DocBohn/CowPi_documentation/README.md

# CowPi_documentation
Datasheet and Construction Instructions for Cow Pi hardware and libraries
