DocBohn/CowPi_documentation/docs/source/stdio.rst

*******************
CowPi_stdio Library
*******************

..  |LibraryLicense| image:: https://img.shields.io/github/license/DocBohn/CowPi_stdio
..  _LibraryLicense: https://github.com/DocBohn/CowPi_stdio/blob/main/LICENSE
..  |DocumentationLicense| image:: https://img.shields.io/github/license/DocBohn/CowPi_documentation
..  _DocumentationLicense: https://github.com/DocBohn/CowPi_documentation/blob/main/LICENSE
..  |ArduinoBadge| image:: https://www.ardu-badge.com/badge/CowPi_stdio.svg
..  _ArduinoBadge: https://www.ardu-badge.com/CowPi_stdio
..  |PlatformIOBadge| image:: https://badges.registry.platformio.org/packages/docbohn/library/CowPi_stdio.svg
..  _PlatformIOBadge: https://registry.platformio.org/libraries/docbohn/CowPi_stdio

- Library licensed under |LibraryLicense|_
- Documentation licensed under |DocumentationLicense|_

This documentation is for the ``CowPi_stdio`` library, v\ **0.6**\ .

The current version is: |ArduinoBadge|_ |PlatformIOBadge|_

..  toctree::
    :maxdepth: 3

    CowPi_stdio/configuration
    CowPi_stdio/considerations
    CowPi_stdio/other_functions
    CowPi_stdio/seven_segment
    CowPi_stdio/led_matrix
    CowPi_stdio/lcd_character
    CowPi_stdio/morse_code
    CowPi_stdio/protocols
    CowPi_stdio/theory_of_operation
    CowPi_stdio/direct-control
