DocBohn/CowPi_documentation/docs/source/expansion.rst

*****************
Expansion Options
*****************

..  TODO:: EEPROM

..  TODO:: Servomotor

..  TODO:: Ultrasonic Echo Sensor

..  TODO:: Piezobuzzer

..  TODO:: Rotary Encoder
