DocBohn/CowPi_documentation/docs/source/hardware/pinouts.pptx

## Arduino Nano – SPI

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
RESET

D0 (RX)

D1 (TX)

D13

3V3

AREF

A6

A7

5V

RESET

VIN

A0/D14

A1/D15

A2/D16

A3/D17

A4/D18

A5/D19

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
Keypad Rows
* 7 4 1

CS

SCK

1 2 3 A
Keypad Columns

## Arduino Nano – I2C

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
RESET

D0 (RX)

D1 (TX)

D13

3V3

AREF

A6

A7

5V

RESET

VIN

A0/D14

A1/D15

A2/D16

A3/D17

A4/D18

A5/D19

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
Keypad Rows
* 7 4 1

1 2 3 A
Keypad Columns

SDA

SCL

## Arduino Uno – SPI

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
Keypad Rows
* 7 4 1

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
D0 (RX)

D1 (TX)

AREF

GND

RESET

PC6

3V3

5V

A3/D17

A2/D16

A4/D18

A1/D15

1 2 3 A
Keypad Columns

A0/D14

PC0

PC1

PC2

PC3

PC4

A5/D19

PC5

IOREF

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
RESET

GND

## Arduino Uno – I2C

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
Keypad Rows
* 7 4 1

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
D0 (RX)

D1 (TX)

SCL

SDA

AREF

GND

RESET

PC6

3V3

5V

A3/D17

A2/D16

A4/D18

A1/D15

1 2 3 A
Keypad Columns

A0/D14

PC0

PC1

PC2

PC3

PC4

A5/D19

PC5

SDA

SCL

IOREF

GND

GND

VIN

## Raspberry Pi Pico

39

1
2

SDO

GP28/A3

GND

GP27/A1

GP26/A0

SCK

CS

SDI

VBUS (USB)

VSYS

GND

3V3_EN

3V3 (OUT)

AREF

RUN

GP22

GND

GP21

GP20

GP19

GP18

GP17

GND

GP16

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
1 4 7 *
Keypad Rows

GP7

GP8

GP9

GP10

GND

1 2 3 A
Keypad Columns

GP11

GP12

GP13

GND

GP14

GP15

## Arduino Nano – SPI – NAND

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
RESET

D0 (RX)

D1 (TX)

D13

3V3

AREF

A6

A7

5V

RESET

VIN

A0/D14

A1/D15

A2/D16

A3/D17

A4/D18

A5/D19

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
COPI

Keypad Rows
* 7 4 1

CS

SCK

1 2 3 A
Keypad Columns

## Arduino Nano – I2C – NAND

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
RESET

D0 (RX)

D1 (TX)

D13

3V3

AREF

A6

A7

5V

RESET

VIN

A0/D14

A1/D15

A2/D16

A3/D17

A4/D18

A5/D19

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
Keypad Rows
* 7 4 1

1 2 3 A
Keypad Columns

SDA

SCL
