DocBohn/CowPi_documentation/docs/source/construction/pico/mk3c-images/CowPi-mk3c-schematic.png

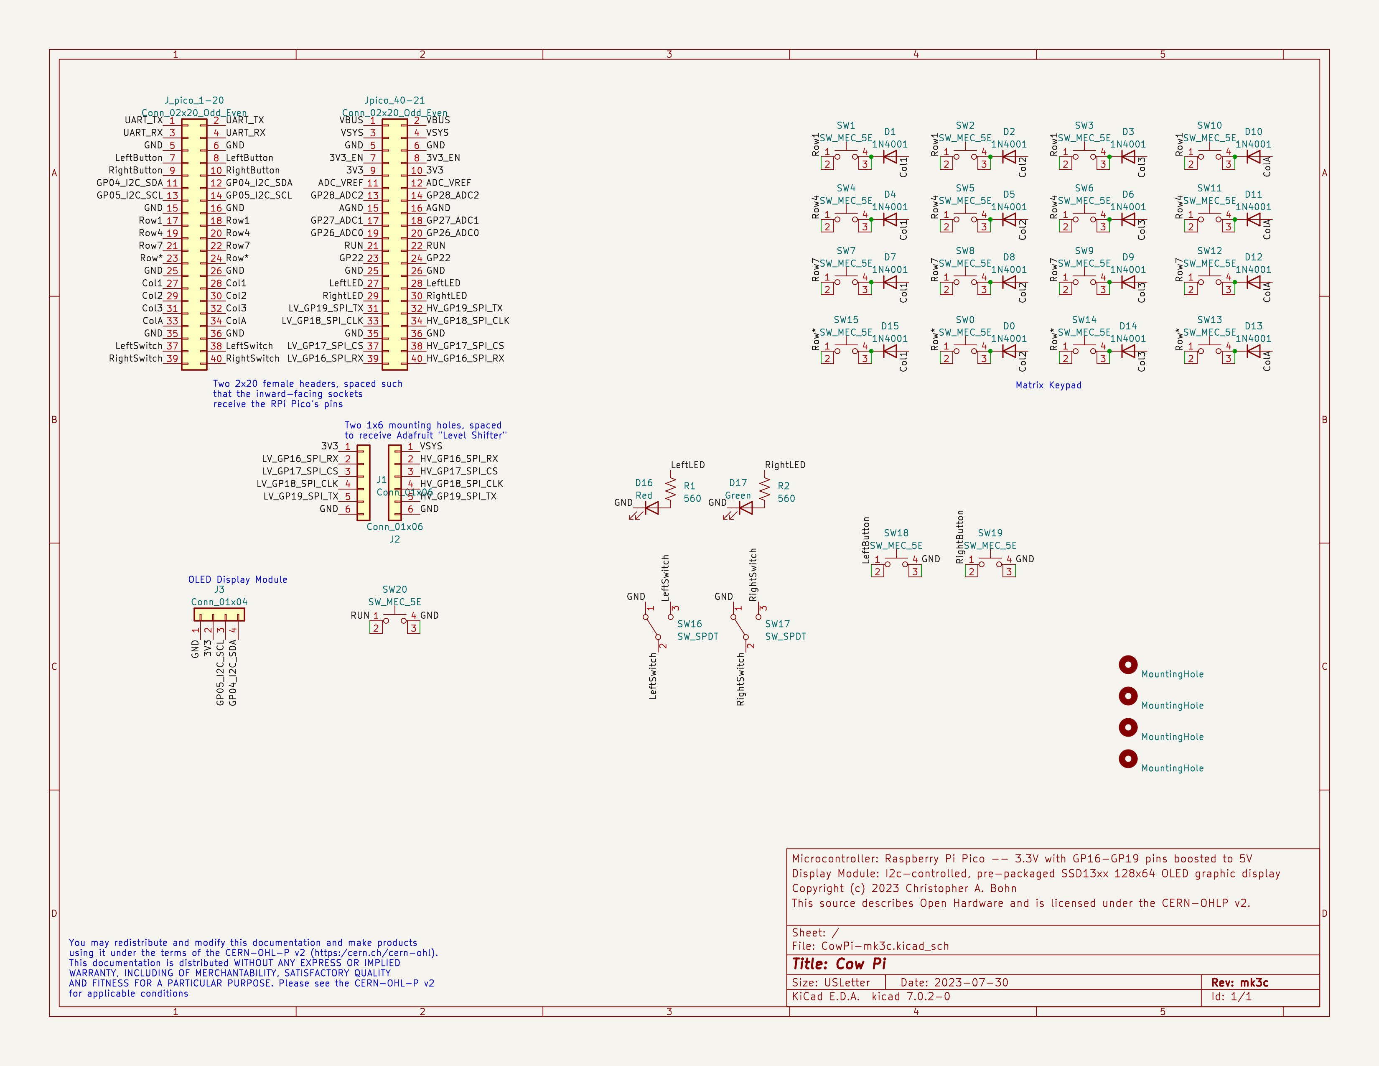
docs/source/construction/pico/mk3c-images/CowPi-mk3c-schematic.png
