DocBohn/CowPi_documentation/docs/source/construction/pico/mk4b-images/CowPi-mk4b-schematic.jpg

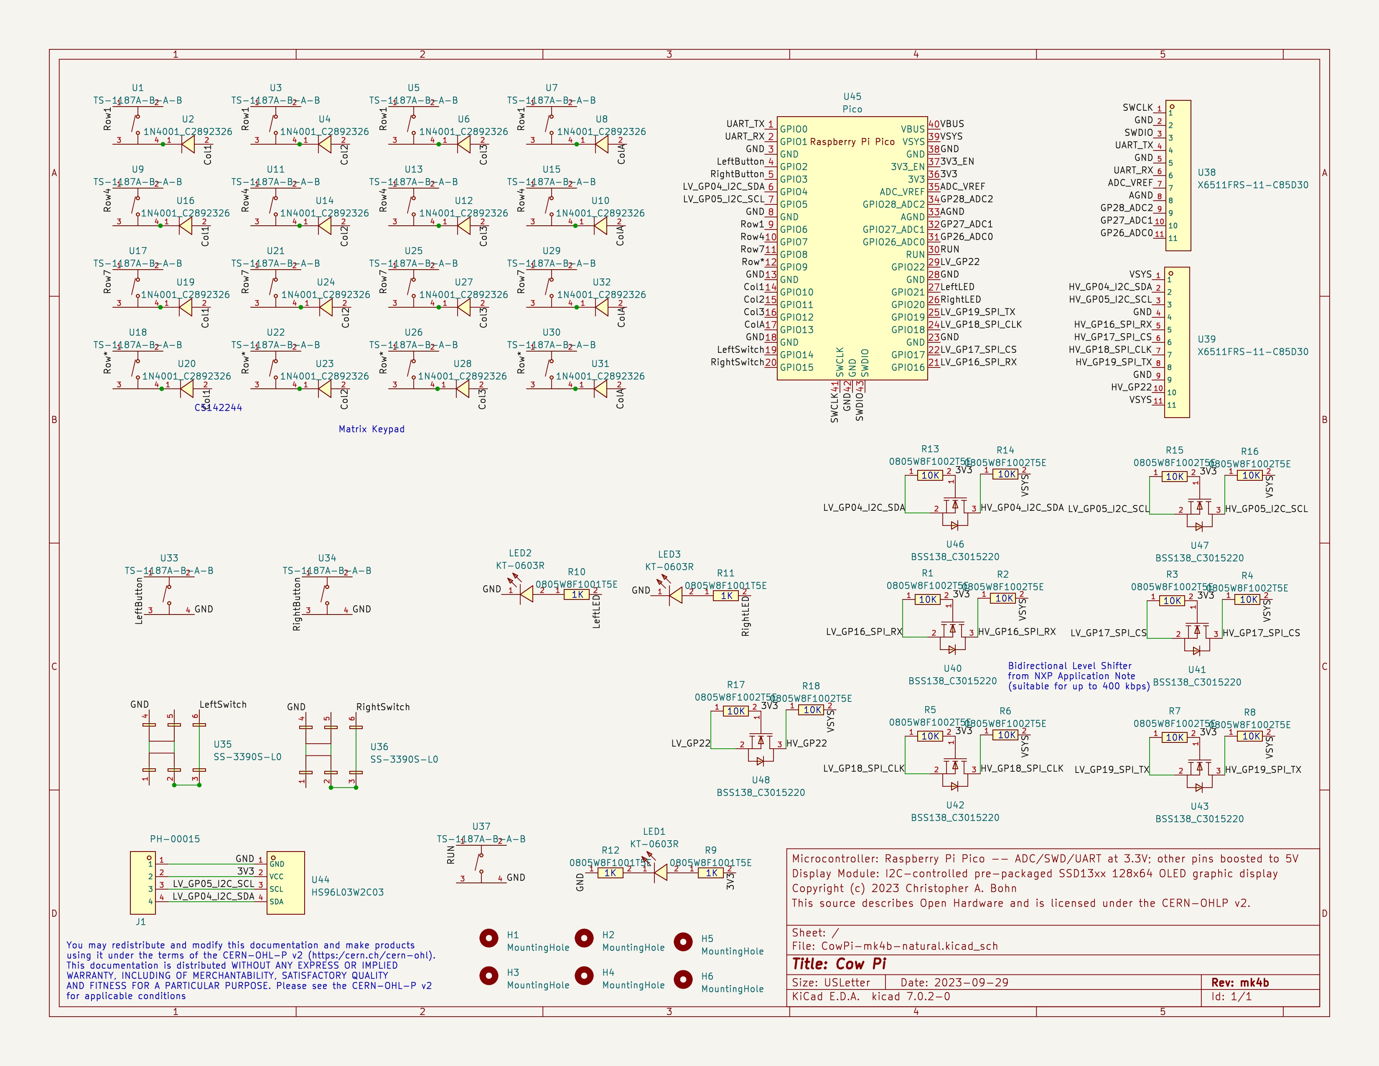
docs/source/construction/pico/mk4b-images/CowPi-mk4b-schematic.jpg
