DocBohn/CowPi_documentation/docs/source/CowPi_stdio/img/animations/lcd00.jpg

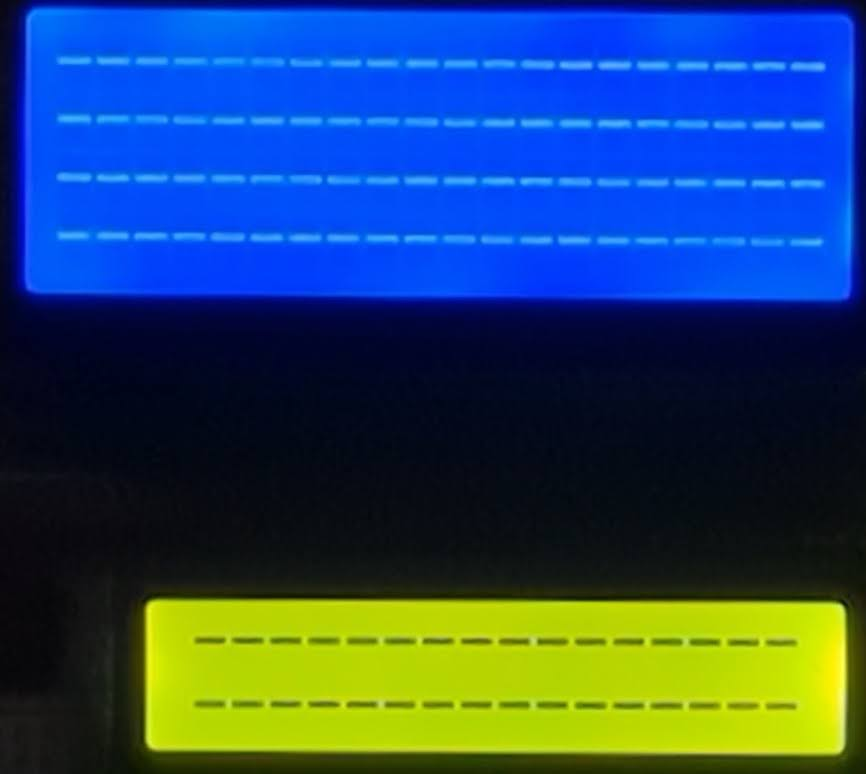
docs/source/CowPi_stdio/img/animations/lcd00.jpg
