DocBohn/CowPi_documentation/docs/source/CowPi_stdio/img/animations/lcd01.jpg

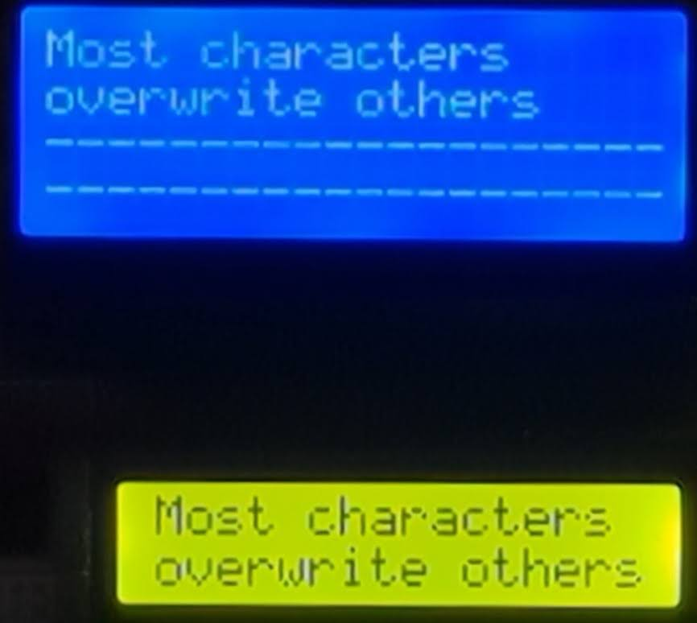
docs/source/CowPi_stdio/img/animations/lcd01.jpg
