DocBohn/CowPi_documentation/docs/source/CowPi_stdio/img/animations/lcd02.jpg

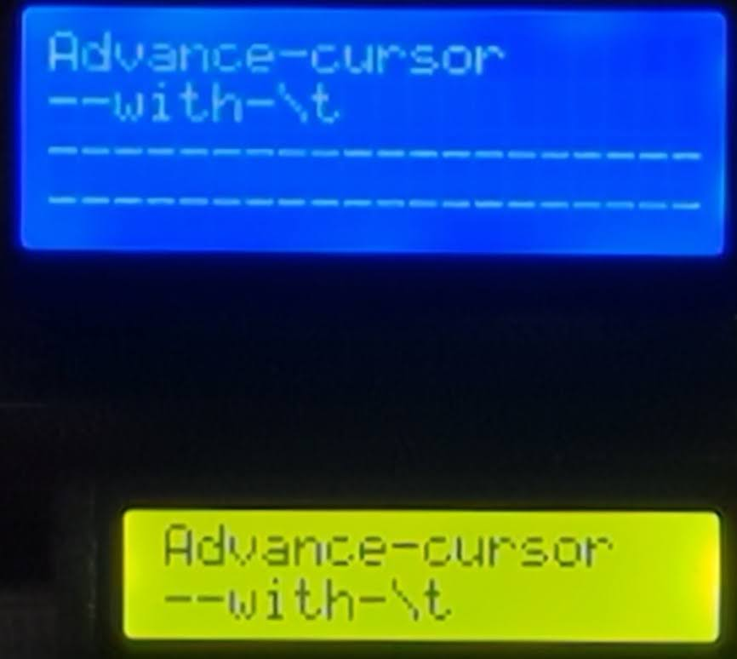
docs/source/CowPi_stdio/img/animations/lcd02.jpg
