DocBohn/CowPi_documentation/docs/source/CowPi_stdio/img/animations/lcd03.jpg

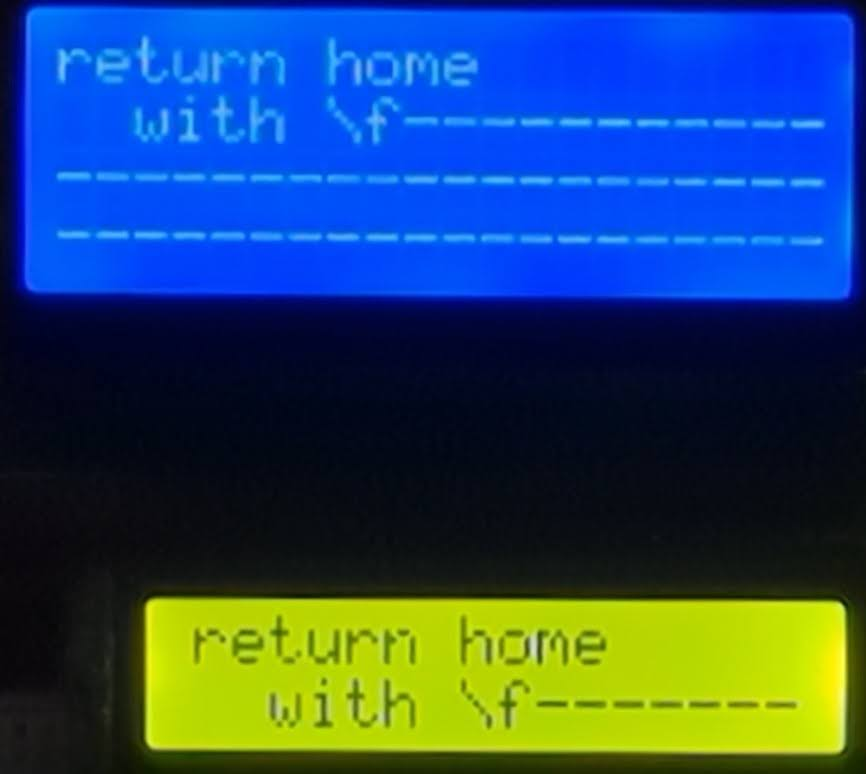
docs/source/CowPi_stdio/img/animations/lcd03.jpg
