DocBohn/CowPi_documentation/docs/source/CowPi_stdio/img/animations/lcd04.jpg

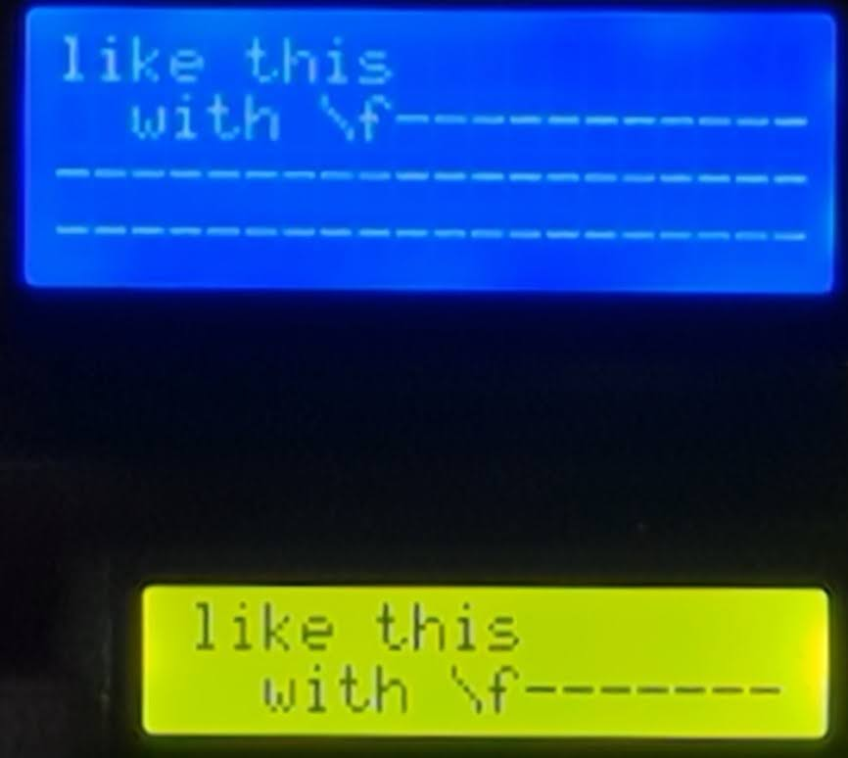
docs/source/CowPi_stdio/img/animations/lcd04.jpg
