DocBohn/CowPi_documentation/docs/source/CowPi_stdio/img/animations/lcd05.jpg

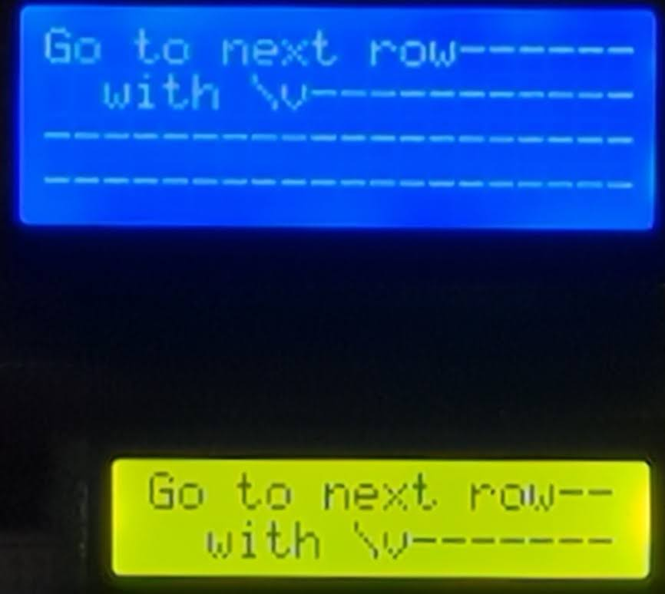
docs/source/CowPi_stdio/img/animations/lcd05.jpg
