DocBohn/CowPi_documentation/docs/source/CowPi_stdio/img/animations/lcd06.jpg

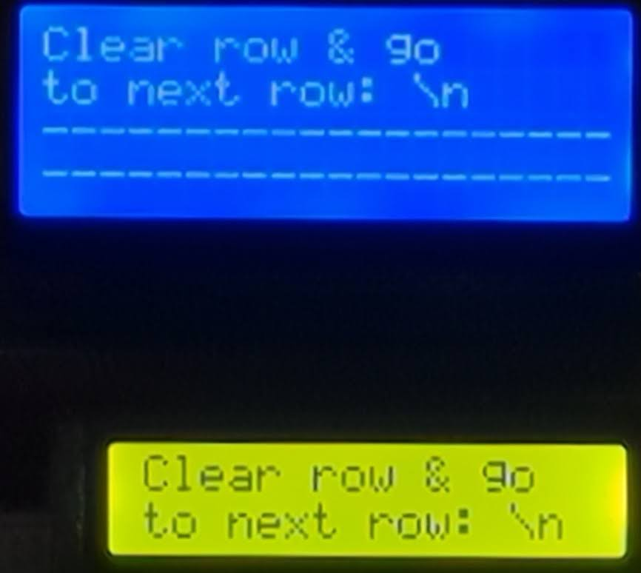
docs/source/CowPi_stdio/img/animations/lcd06.jpg
