DocBohn/CowPi_documentation/docs/source/CowPi_stdio/img/animations/lcd07.jpg

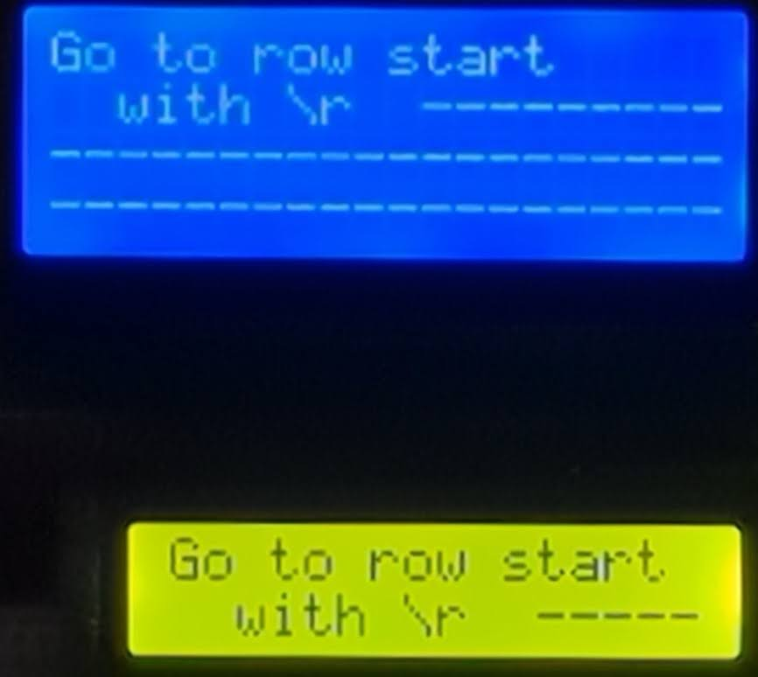
docs/source/CowPi_stdio/img/animations/lcd07.jpg
