DocBohn/CowPi_documentation/docs/source/CowPi_stdio/img/animations/lcd08.jpg

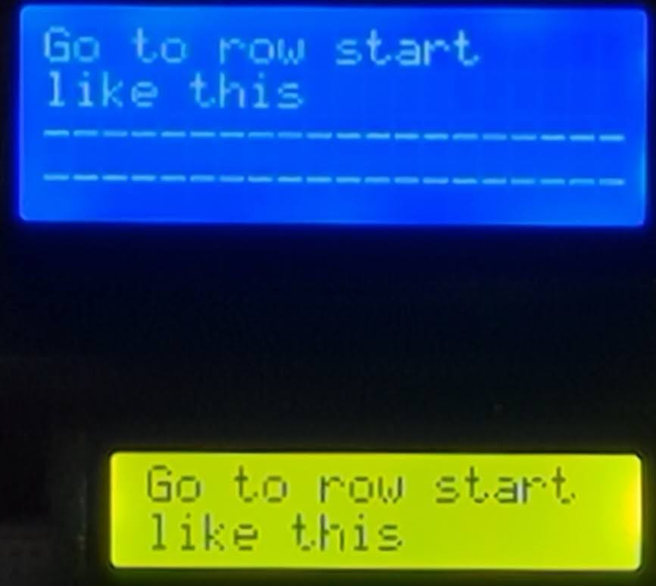
docs/source/CowPi_stdio/img/animations/lcd08.jpg
