DocBohn/CowPi_documentation/docs/source/CowPi_stdio/img/animations/lcd09.jpg

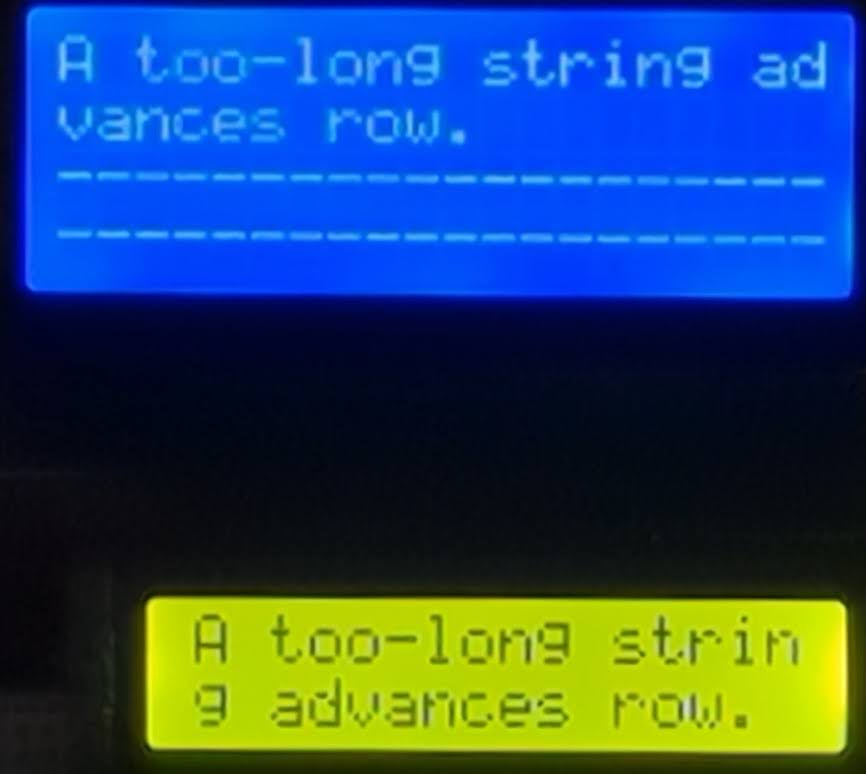
docs/source/CowPi_stdio/img/animations/lcd09.jpg
