DocBohn/CowPi_documentation/docs/source/CowPi_stdio/img/animations/lcd10.jpg

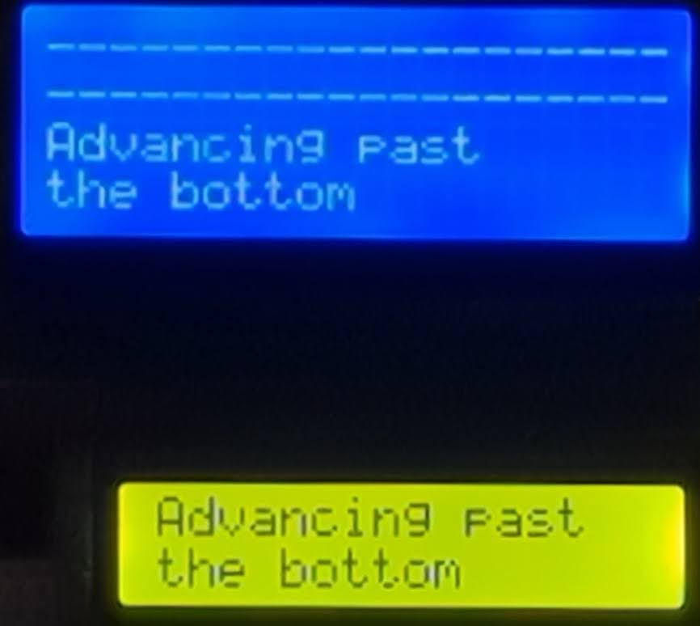
docs/source/CowPi_stdio/img/animations/lcd10.jpg
