DocBohn/CowPi_documentation/docs/source/CowPi_stdio/img/animations/lcd11.jpg

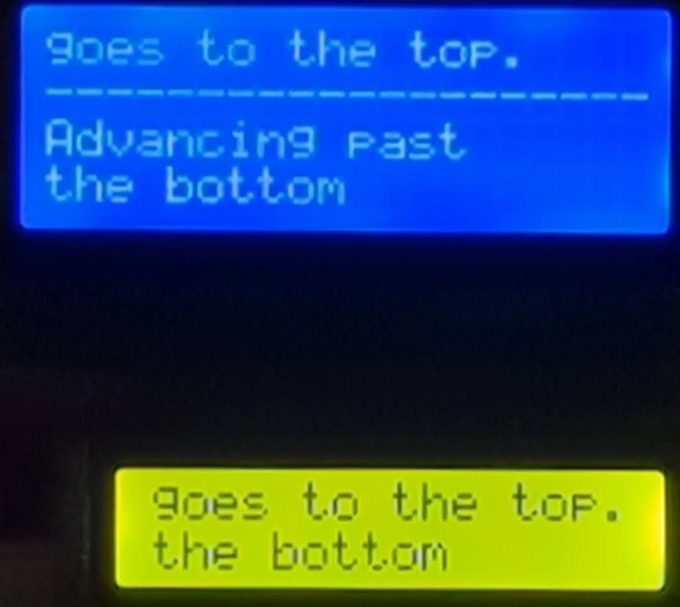
docs/source/CowPi_stdio/img/animations/lcd11.jpg
