DocBohn/CowPi_documentation/docs/source/CowPi_stdio/img/animations/lcd2004-1602.gif

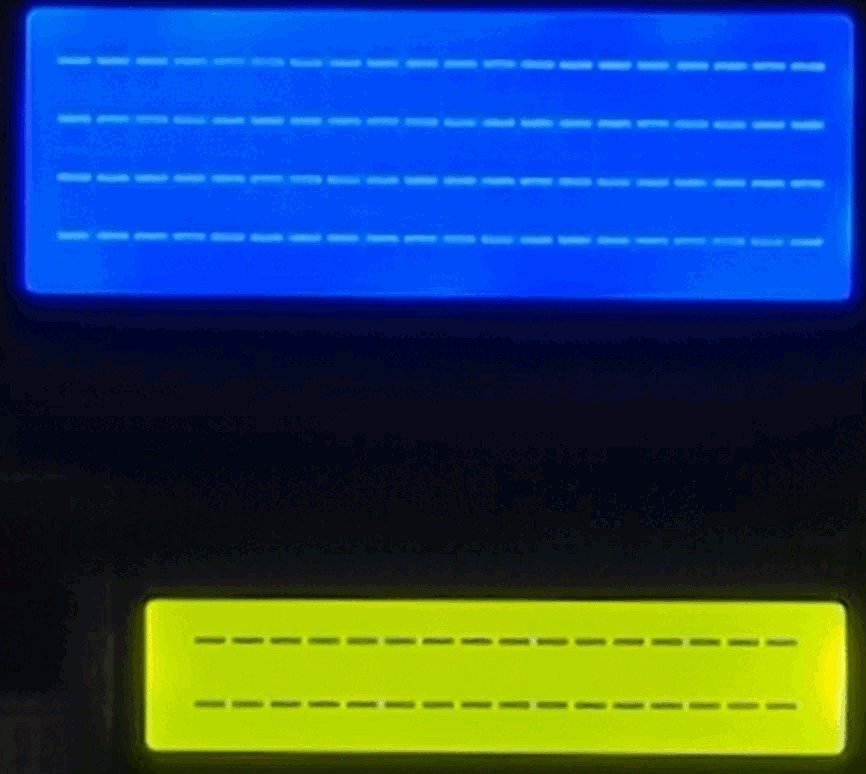
docs/source/CowPi_stdio/img/animations/lcd2004-1602.gif
