DocBohn/CowPi_documentation/docs/source/CowPi_stdio/img/morsecode.gif

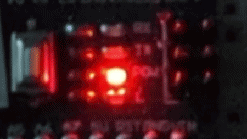
docs/source/CowPi_stdio/img/morsecode.gif
