DocBohn/CowPi_documentation/docs/source/CowPi_stdio/img/sevensegment.gif

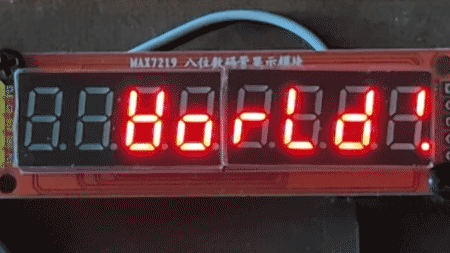
docs/source/CowPi_stdio/img/sevensegment.gif
