DocBohn/CowPi_documentation/docs/source/hardware/prepare-to-detect-keypress.png

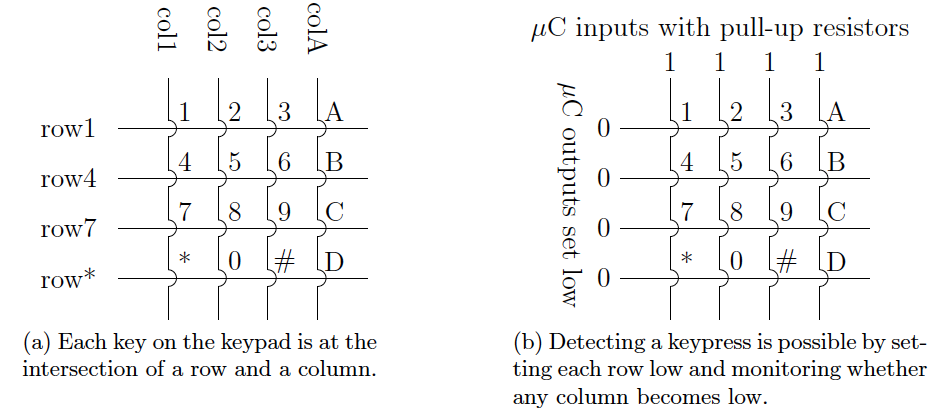
docs/source/hardware/prepare-to-detect-keypress.png
