DocBohn/CowPi_documentation/docs/source/hardware/scanning-keypad.png

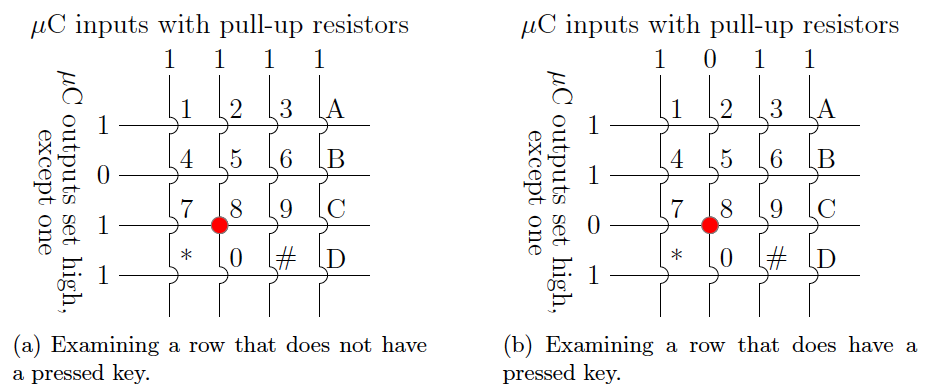
docs/source/hardware/scanning-keypad.png
