DocBohn/CowPi_documentation/docs/source/osi_symbol.png

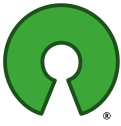
docs/source/osi_symbol.png
