DocBohn/CowPi_documentation/docs/source/construction/nano/inventory/preparation-mk1e.rst

..  include:: ../mk1e.txt

Prepare to Assemble the Cow Pi mark 1e
======================================

..  include:: preparation-inventory.rst

-   | One (1) 8-digit/7-segment display module
    | |max7219digits|

-   | One (1) 5-conductor 20cm "rainbow" cable (female-to-male)
    | |fiveConductor|

..  include:: preparation-assembling.rst

..  NOTE::
    The circuit you build by following these instructions will look a bit like a rat's nest by the time that you are finished.
    This is because the jumper wires you remove from the male-to-male rainbow cable are not cut to length and generally will be longer than they need to be (which is much better than being shorter than they need to be).
    If you have prior experience with building circuits on a solderless breadboard, and if you have solid-core wires and wire cutters, then optionally you may build the circuit with cut-to-length solid core wires.

    ..  image:: completed-kit-max7219.jpg
        :width: 90%
        :align: center

    \
        \
            Cow Pi mk1a that was constructed using 10cm jumper wires.

..  NOTE::
    In many of the photographs on the following pages, jumper wires from earlier steps have been replaced with cut-to-length wires to emphasize the wires from the current step.
    This may cause the photographs to look "cleaner" than your circuit.

..  |max7219digits|     image:: max7219digits.jpg
    :height: 2cm
..  |fiveConductor|     image:: fm-5cable.jpg
    :height: 2cm
