DocBohn/CowPi_documentation/docs/source/construction/nano/inventory/adafruit-lcd-adapter.jpg

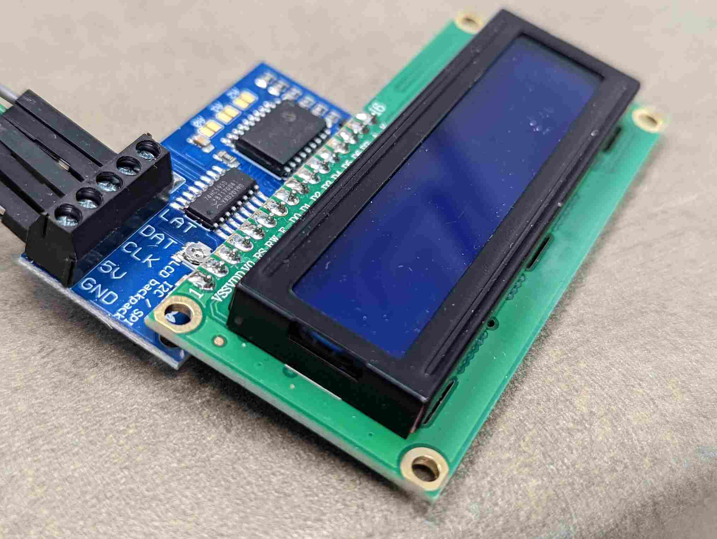
docs/source/construction/nano/inventory/adafruit-lcd-adapter.jpg
