DocBohn/CowPi_documentation/docs/source/construction/nano/inventory/breadboard.jpg

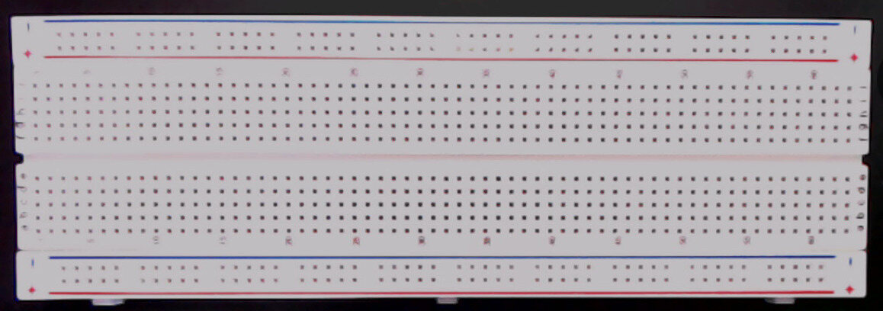
docs/source/construction/nano/inventory/breadboard.jpg
