DocBohn/CowPi_documentation/docs/source/construction/nano/inventory/buttons-2pin.jpg

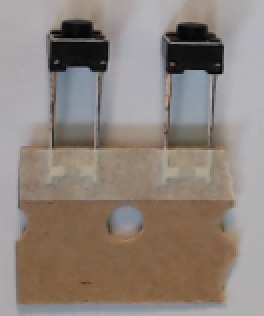
docs/source/construction/nano/inventory/buttons-2pin.jpg
