DocBohn/CowPi_documentation/docs/source/construction/nano/inventory/buttons-4pin.jpg

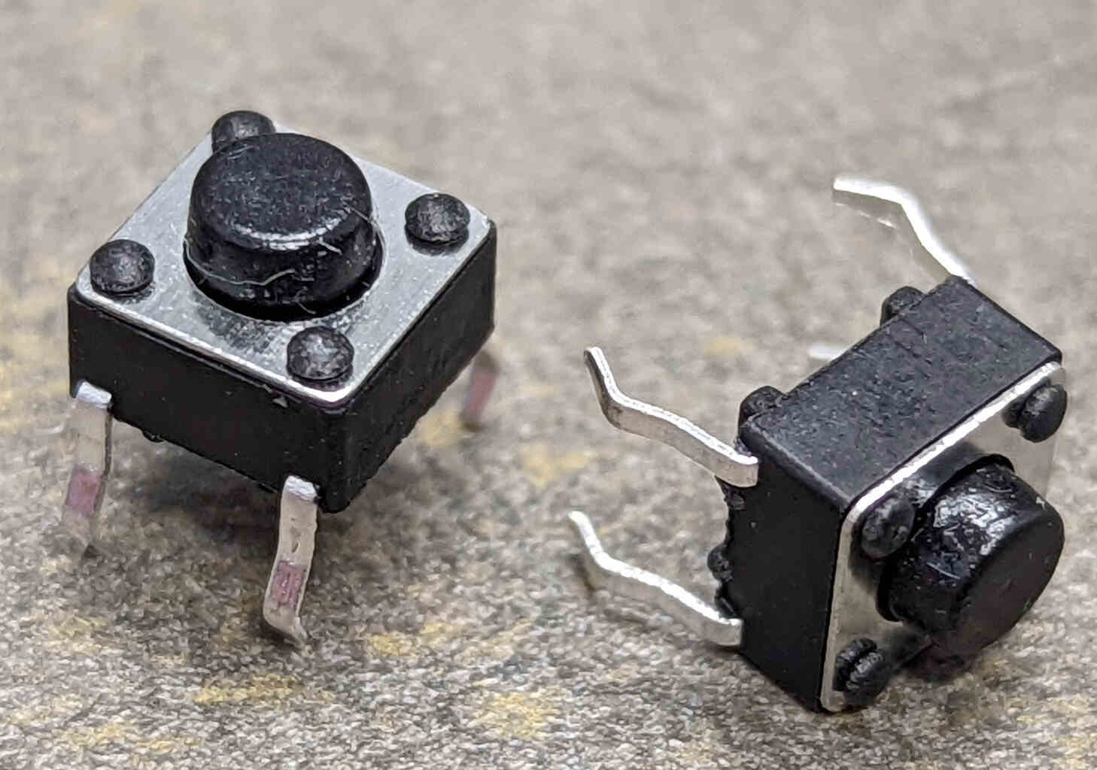
docs/source/construction/nano/inventory/buttons-4pin.jpg
