DocBohn/CowPi_documentation/docs/source/construction/nano/inventory/fm-4cable.jpg

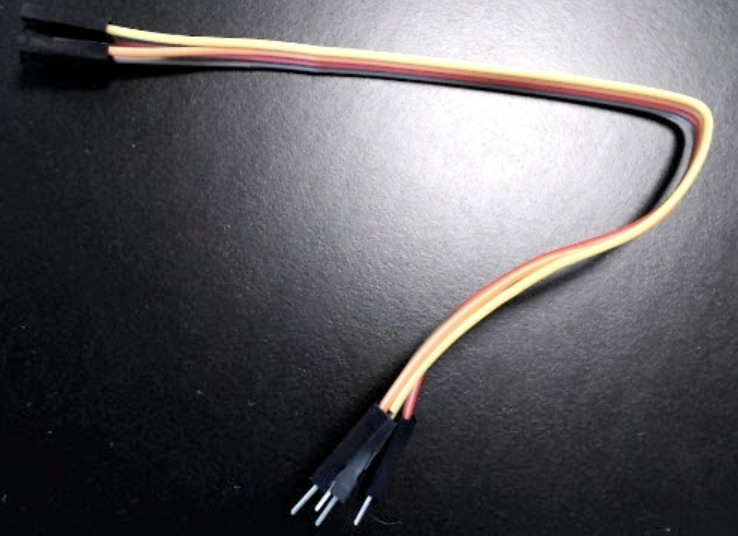
docs/source/construction/nano/inventory/fm-4cable.jpg
