DocBohn/CowPi_documentation/docs/source/construction/nano/inventory/fm-5cable.jpg

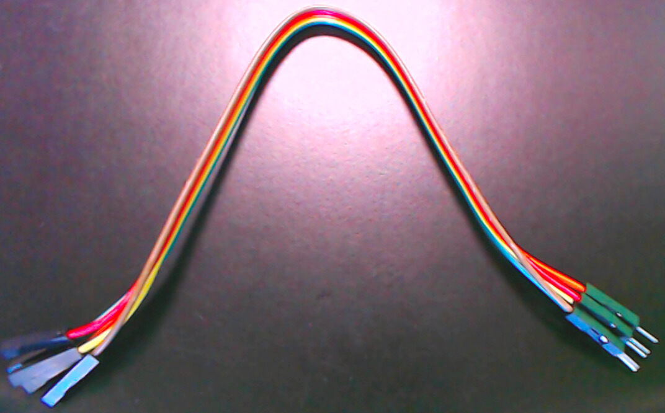
docs/source/construction/nano/inventory/fm-5cable.jpg
