DocBohn/CowPi_documentation/docs/source/construction/nano/inventory/keypad-header-in-connector.jpg

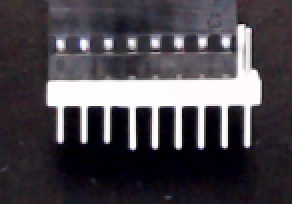
docs/source/construction/nano/inventory/keypad-header-in-connector.jpg
