DocBohn/CowPi_documentation/docs/source/construction/nano/inventory/keypad-header-without-connector.jpg

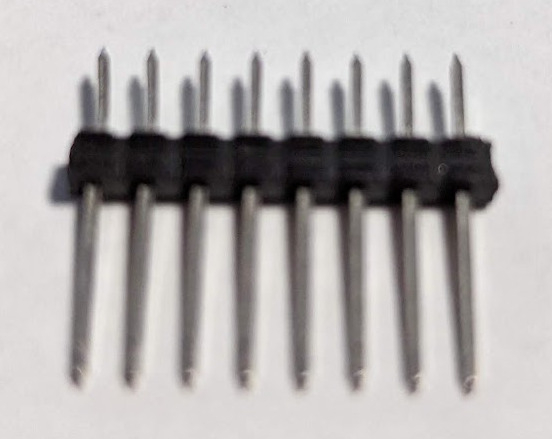
docs/source/construction/nano/inventory/keypad-header-without-connector.jpg
