DocBohn/CowPi_documentation/docs/source/construction/nano/inventory/keypad.jpg

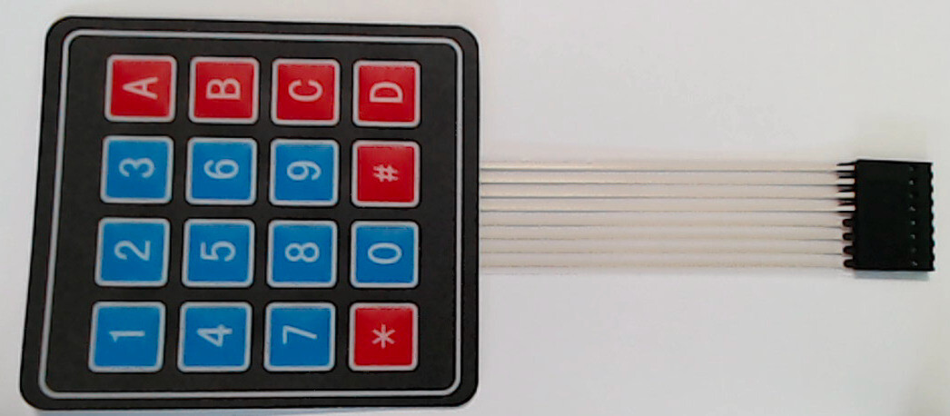
docs/source/construction/nano/inventory/keypad.jpg
