DocBohn/CowPi_documentation/docs/source/construction/nano/inventory/lcd1602.jpg

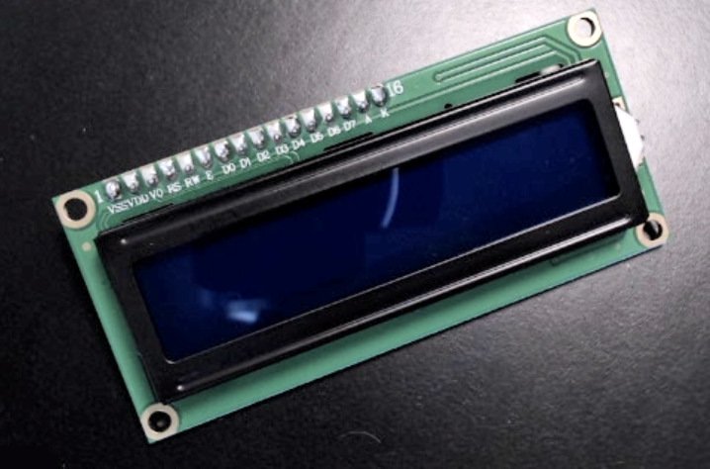
docs/source/construction/nano/inventory/lcd1602.jpg
