DocBohn/CowPi_documentation/docs/source/construction/nano/inventory/lcd-adapter.jpg

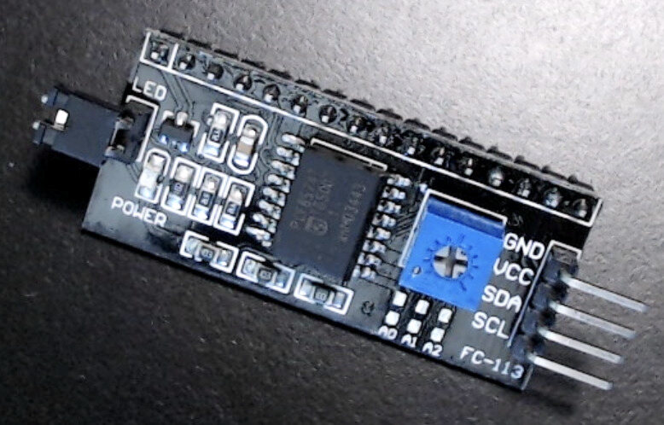
docs/source/construction/nano/inventory/lcd-adapter.jpg
