DocBohn/CowPi_documentation/docs/source/construction/nano/inventory/max7219digits.jpg

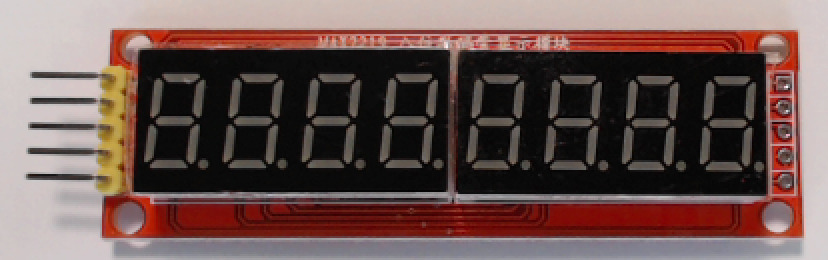
docs/source/construction/nano/inventory/max7219digits.jpg
