DocBohn/CowPi_documentation/docs/source/construction/nano/inventory/mm-cable.jpg

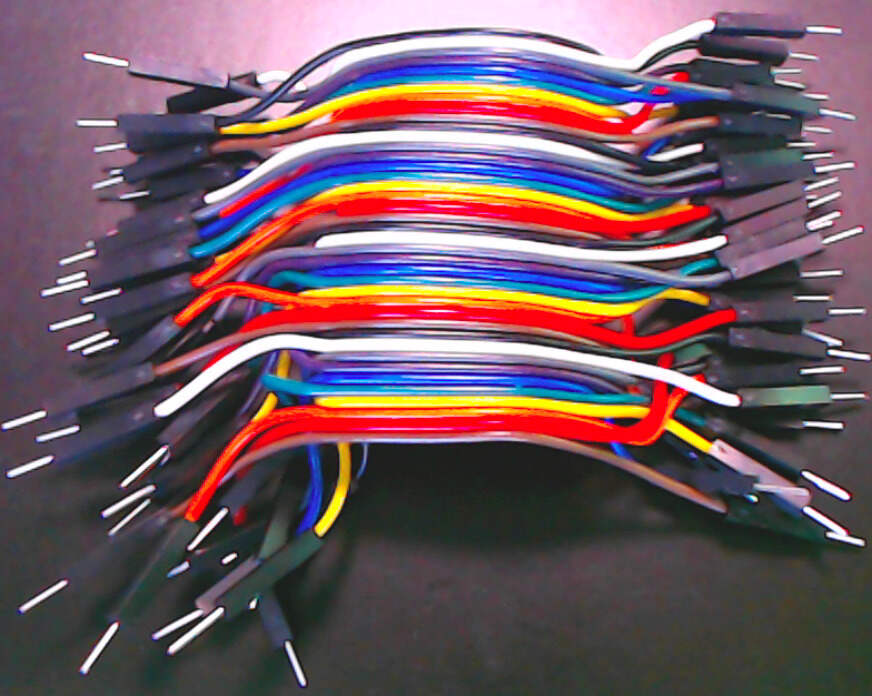
docs/source/construction/nano/inventory/mm-cable.jpg
