DocBohn/CowPi_documentation/docs/source/construction/nano/inventory/nano.jpg

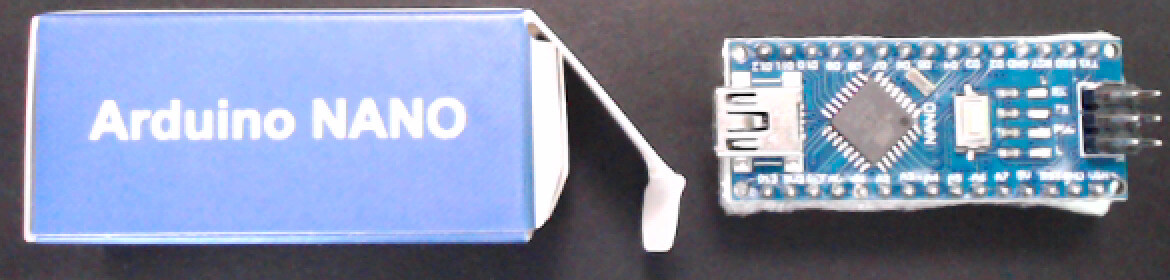
docs/source/construction/nano/inventory/nano.jpg
