DocBohn/CowPi_documentation/docs/source/construction/nano/inventory/piggyback-lcd-adapter.jpg

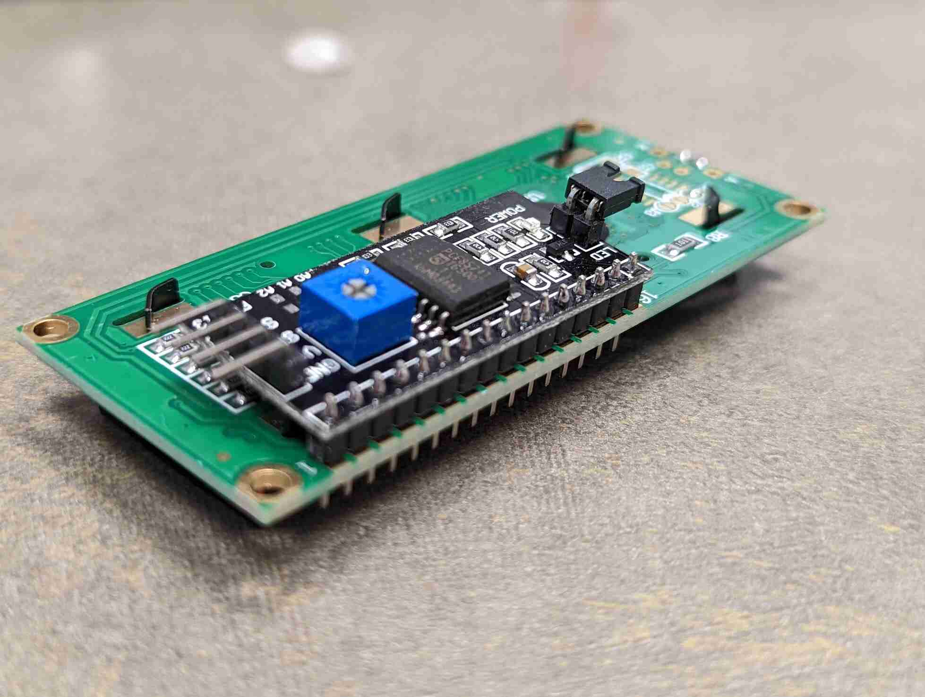
docs/source/construction/nano/inventory/piggyback-lcd-adapter.jpg
