DocBohn/CowPi_documentation/docs/source/construction/nano/inventory/sliders-spdt.jpg

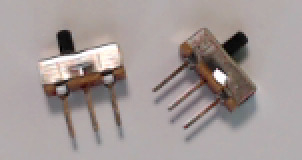
docs/source/construction/nano/inventory/sliders-spdt.jpg
