DocBohn/CowPi_documentation/docs/source/construction/nano/inventory/usb.jpg

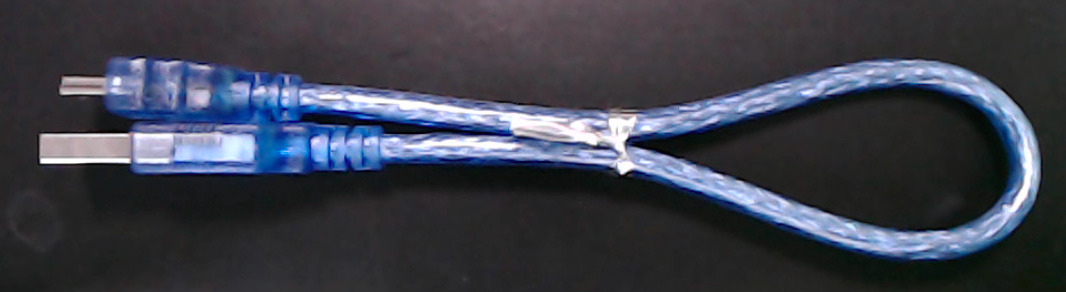
docs/source/construction/nano/inventory/usb.jpg
