DocBohn/CowPi_documentation/docs/source/construction/pico/mk3c-images/components.jpeg

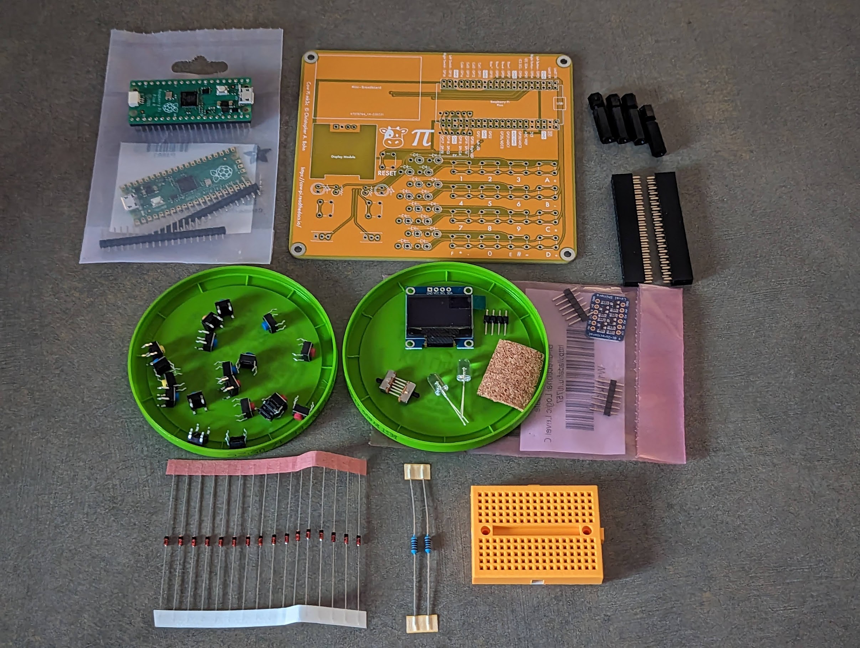
docs/source/construction/pico/mk3c-images/components.jpeg
