DocBohn/CowPi_documentation/docs/source/construction/pico/mk4b-images/components.jpeg

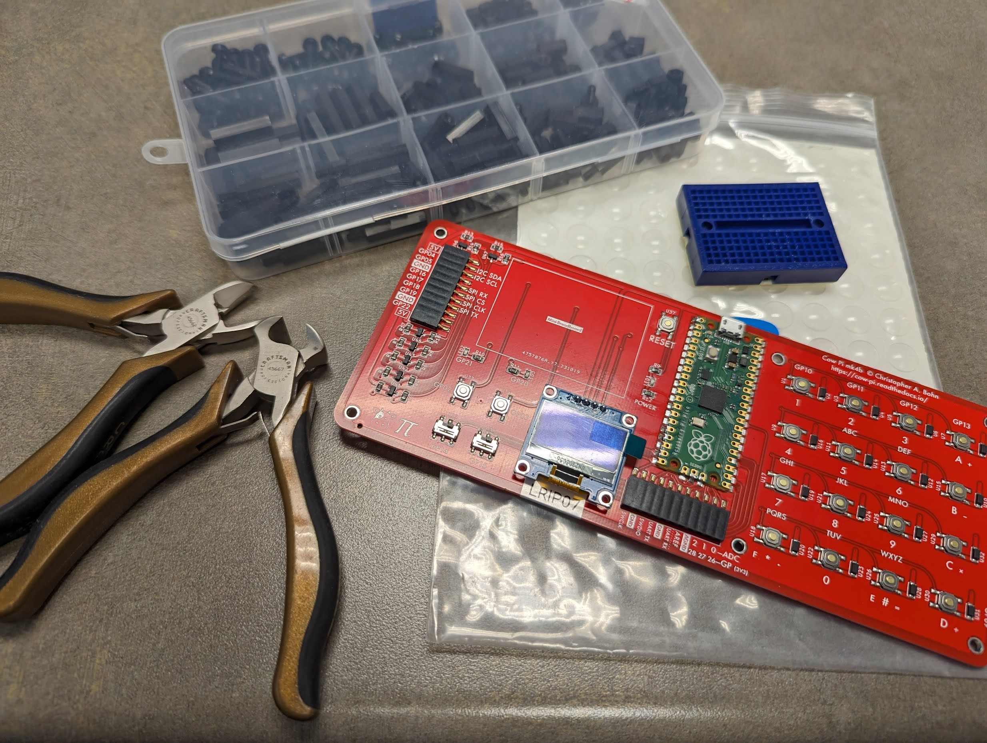
docs/source/construction/pico/mk4b-images/components.jpeg
