DocBohn/CowPi_documentation/docs/source/construction/nano/construction-mk1f.rst

****************************************************************************************
Cow Pi mark 1f Construction Instructions (Arduino Nano form factor, |i2c| communication)
****************************************************************************************

These are the instructions to assemble a Cow Pi circuit using an Arduino Nano, a Nano clone, or another microcontroller board that has the same form factor. [#nanos]_

..  TIP::
    In addition to the professor and the TAs, you may freely seek help on this assignment from other students.

In the I/O labs, we will use a microcontroller board with some peripherals. In this prelab, you will assemble the hardware for the I/O labs.

..  NOTE::
    The EE Shop has prepared “class kits” for CSCE 231;
    your class kit costs $34.
    The EE Shop is located at C308 Scott Engineering Center and is open M-F 7am-4pm.
    You do not need an appointment.
    You may pay at the window
    with cash, with a personal check, or with your NCard.
    The EE shop does *not* accept credit cards.

..  CAUTION::
    Access in/through the Scott Engineering Center changes frequently due to construction.
    See `the course's Piazza site <https://piazza.com/class/ll2imal4y7n5zq/post/42>`_ for the current best-known route.

----

.. toctree::
    :maxdepth: 2

    inventory/preparation-mk1f
    microcontroller/microcontroller-mk1f
    microcontroller/ide-mk1f
    microcontroller/power-mk1f
    direct-io/led-mk1f
    microcontroller/libraries-mk1f
    direct-io/switches-mk1f
    direct-io/buttons-mk1f
    keypad/keypad-mk1f
    display/i2c

----

..  [#nanos]
    | Five-volt microcontroller boards that have the same form factor as the Arduino Nano include the Nano itself and the Arduino Nano Every. Three-volt microcontroller boards that have the same form factor as the Arduino nano include the Arduino Nano 33 IoT, the Arduino Nano 33 BLE, and the Arduino Nano RP2040 Connect.
