DocBohn/CowPi_documentation/docs/source/construction/nano/direct-io/buttons-confirmation.rst

..  ATTENTION::
    **CHECKPOINT 6**
    | |checkpoint| inserted and wired the momentary pushbuttons. |updateCheckpointsTXT|

Connect your |developmentBoard| to the computer.
In the IDE's Serial Monitor, notice that
Left button is normally UP, but it becomes DOWN when you press the left button.
Similarly, Right button is normally UP, but it becomes DOWN when you press the right button.

Notice that both Left LED and Right LED are normally OFF.
Position both switches to the right.
Notice than when (and only when) the left button is to the right and you're also pressing the left button, Left LED becomes ON, and the LED labelled "L" on the |developmentBoard| illuminates.
Similarly, when (and only when) the right button is to the right and you're also pressing the right button, Right LED becomes ON, and the LED that you installed illuminates.
