DocBohn/CowPi_documentation/docs/source/construction/nano/direct-io/switches-confirmation.rst

..  ATTENTION::
    **CHECKPOINT 5**
    | |checkpoint| inserted and wired the slider switches. |updateCheckpointsTXT|

Connect your |developmentBoard| to the computer.
In the IDE's Serial Monitor, notice that
Left switch is LEFT when the left switch is toggled to the left, and it is RIGHT when the left switch is toggled to the right.
Similarly, Right switch is LEFT or RIGHT, depending on whether the right switch is toggled to the left or right.
