DocBohn/CowPi_documentation/docs/source/construction/nano/microcontroller/power-steps.rst

The columns marked with red and blue stripes are the power bus strips, also known as the power rails.
You will now provide power to the bus strips so that the other components can use power.

..  IMPORTANT:: |unplug|

:\:[   ]: Take the male-to-male rainbow cable, and peel off two wires.

:\:[   ]: Insert one end of a wire into contact point |mcuFiveVoltContactPoint|
    (notice that contact point |mcuFiveVoltContactPoint| is electrically connected to the |developmentBoard|'s ``5V`` pin, which is in contact point |mcuFiveVolt|).

:\:[   ]: Insert the other end of the ``5V`` wire into the upper |power| marked with a red stripe.

:\:[   ]: Now insert one end of the other wire into contact point |mcuUpperGroundContactPoint|
    (notice that contact point |mcuUpperGroundContactPoint| is electrically connected to one of the |developmentBoard|'s ``GND`` pins, which is in contact point |mcuUpperGround|).
