DocBohn/CowPi_documentation/docs/source/construction/nano/direct-io/buttons-mk1e.rst

..  include:: ../mk1ef.txt
..  include:: ../mk1e.txt

Install the Momentary Pushbuttons
=================================
*Cow Pi mk1e: Arduino Nano form factor, SPI communication*

..  include:: buttons-preamble.rst

Install the Buttons
-------------------

These are "normally open" momentary "switches" that close when pressed and re-open when released.
We will wire the pushbuttons such that they normally produce a 1, and when pressed will produce a 0.
:numref:`mk1eButtonDiagram` shows a diagram of the wiring for the pushbuttons.

.. _mk1eButtonDiagram:


    Diagram of wiring associated with momentary pushbutton input.

    +-------+-------------------------------------------------------------------+
    |       | 
    | **a** |    :width: 90.0%                                                  |
    |       |                                                                   |
    |       | 2-lead pushbuttons                                                |
    +-------+-------------------------------------------------------------------+
    |       | 
    | **b** |    :width: 90.0%                                                  |
    |       |                                                                   |
    |       | 4-prong pushbuttons                                               |
    +-------+-------------------------------------------------------------------+

..  _mk1eFigureButton:


    Wiring the momentary pushbuttons

    +-------+---------------------------------+-------+----------------------------------+
    |       | 
    | **a** |                                 | **b** |                                  |
    |       | Pushbuttons with two leads.     |       | Pushbuttons with four prongs.    |
    +-------+---------------------------------+-------+----------------------------------+
    |       | 
    | **c** |    :width: 90.0%                                                           |
    |       |                                                                            |
    |       | The momentary pushbuttons, wired to the |developmentBoard|.                |
    +-------+----------------------------------------------------------------------------+

..  include:: buttons-steps.rst

When you have finished setting up the pushbuttons' wiring, there should be the electrical paths described in :numref:`mk1eTablePushbuttons`.

..  _mk1eTablePushbuttons:
..  table:: Electrical Paths for Momentary Pushbuttons.

    +----------------+------------------------+-------------------+
    | Pushbutton     | |developmentBoard| pin | Power/Ground Rail |
    +================+========================+===================+
    | Left button's  |                        | |ground|          |
    | grounded lead  |                        |                   |
    +----------------+------------------------+-------------------+
    | Left button's  | |mcuLeftButtonPin|     |                   |
    | ungrounded     |                        |                   |
    | lead           |                        |                   |
    +----------------+------------------------+-------------------+
    | Right button's |                        | |ground|          |
    | grounded lead  |                        |                   |
    +----------------+------------------------+-------------------+
    | Right button's | |mcuRightButtonPin|    |                   |
    | ungrounded     |                        |                   |
    | lead           |                        |                   |
    +----------------+------------------------+-------------------+

..  include:: buttons-confirmation.rst
