DocBohn/CowPi_documentation/docs/source/construction/nano/direct-io/buttons-mk1f.rst

..  include:: ../mk1ef.txt
..  include:: ../mk1f.txt

Install the Momentary Pushbuttons
=================================
*Cow Pi mk1f: Arduino Nano form factor,* |i2c-italics| *communication*

..  include:: buttons-preamble.rst

Install the Buttons
-------------------

These are "normally open" momentary "switches" that close when pressed and re-open when released.
We will wire the pushbuttons such that they normally produce a 1, and when pressed will produce a 0.
:numref:`mk1fButtonDiagram` shows a diagram of the wiring for the pushbuttons.

.. _mk1fButtonDiagram:


    Diagram of wiring associated with momentary pushbutton input.

    +-------+-------------------------------------------------------------------+
    |       | 
    | **a** |    :width: 90.0%                                                  |
    |       |                                                                   |
    |       | 2-lead pushbuttons                                                |
    +-------+-------------------------------------------------------------------+
    |       | 
    | **b** |    :width: 90.0%                                                  |
    |       |                                                                   |
    |       | 4-prong pushbuttons                                               |
    +-------+-------------------------------------------------------------------+

..  _mk1fFigureButton:


    Wiring the momentary pushbuttons

    +-------+---------------------------------+-------+----------------------------------+
    |       | 
    | **a** |                                 | **b** |                                  |
    |       | Pushbuttons with two leads.     |       | Pushbuttons with four prongs.    |
    +-------+---------------------------------+-------+----------------------------------+
    |       | 
    | **c** |    :width: 90.0%                                                           |
    |       |                                                                            |
    |       | The momentary pushbuttons, wired to the |developmentBoard|.                |
    +-------+----------------------------------------------------------------------------+

..  include:: buttons-steps.rst

When you have finished setting up the pushbuttons' wiring, there should be the electrical paths described in :numref:`mk1fTablePushbuttons`.

..  _mk1fTablePushbuttons:
..  table:: Electrical Paths for Momentary Pushbuttons.

    +----------------+------------------------+-------------------+
    | Pushbutton     | |developmentBoard| pin | Power/Ground Rail |
    +================+========================+===================+
    | Left button's  |                        | |ground|          |
    | grounded lead  |                        |                   |
    +----------------+------------------------+-------------------+
    | Left button's  | |mcuLeftButtonPin|     |                   |
    | ungrounded     |                        |                   |
    | lead           |                        |                   |
    +----------------+------------------------+-------------------+
    | Right button's |                        | |ground|          |
    | grounded lead  |                        |                   |
    +----------------+------------------------+-------------------+
    | Right button's | |mcuRightButtonPin|    |                   |
    | ungrounded     |                        |                   |
    | lead           |                        |                   |
    +----------------+------------------------+-------------------+

..  include:: buttons-confirmation.rst
