DocBohn/CowPi_documentation/docs/source/construction/nano/microcontroller/libraries-arduino-steps.rst

Install the Libraries for the Arduino IDE
"""""""""""""""""""""""""""""""""""""""""

The library manager can be accessed either from the top menu bar (*File* ⟶ *Manage Libraries*) or from the side menu bar (select the icon that looks like books standing on a shelf).

:\:[   ]: Open the library manager.

:\:[   ]: In the library manager's search bar, type "CowPi" (without quotation marks).

The results will be the CowPi library and the CowPi_stdio library.

:\:[   ]: Click the "Install" button for the CowPi library.
