DocBohn/CowPi_documentation/docs/source/construction/nano/microcontroller/libraries.rst

Install the CowPi and the CowPi_stdio Libraries
===============================================
*Cow Pi mk1e/f: Arduino Nano form factor*

..  DANGER::
    TODO
