DocBohn/CowPi_documentation/docs/source/construction/nano/direct-io/animations/revisedblink-0.jpg

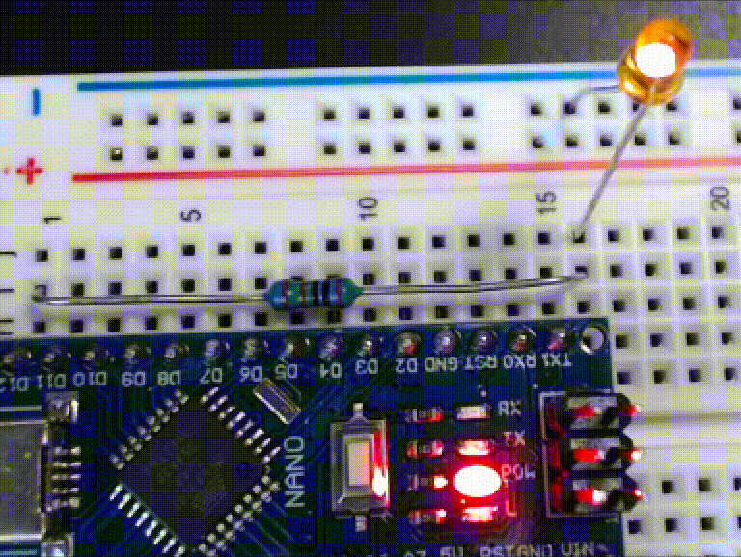
docs/source/construction/nano/direct-io/animations/revisedblink-0.jpg
