DocBohn/CowPi_documentation/docs/source/construction/nano/direct-io/led-inserted.jpg

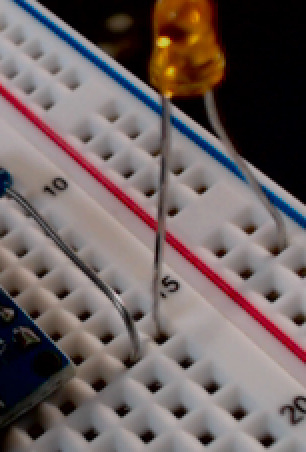
docs/source/construction/nano/direct-io/led-inserted.jpg
