DocBohn/CowPi_documentation/docs/source/construction/nano/direct-io/pushbutton-2lead.jpg

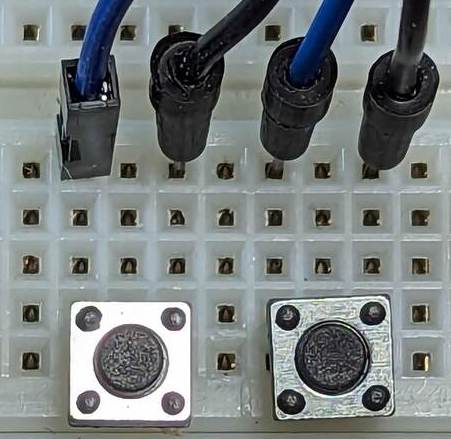
docs/source/construction/nano/direct-io/pushbutton-2lead.jpg
