DocBohn/CowPi_documentation/docs/source/construction/nano/direct-io/pushbutton-4prong.jpg

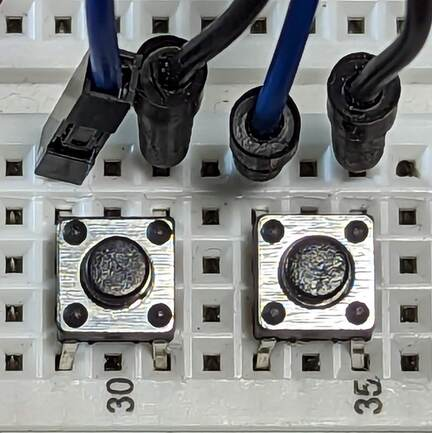
docs/source/construction/nano/direct-io/pushbutton-4prong.jpg
