DocBohn/CowPi_documentation/docs/source/construction/nano/direct-io/pushbutton-wired-mk1e.jpg

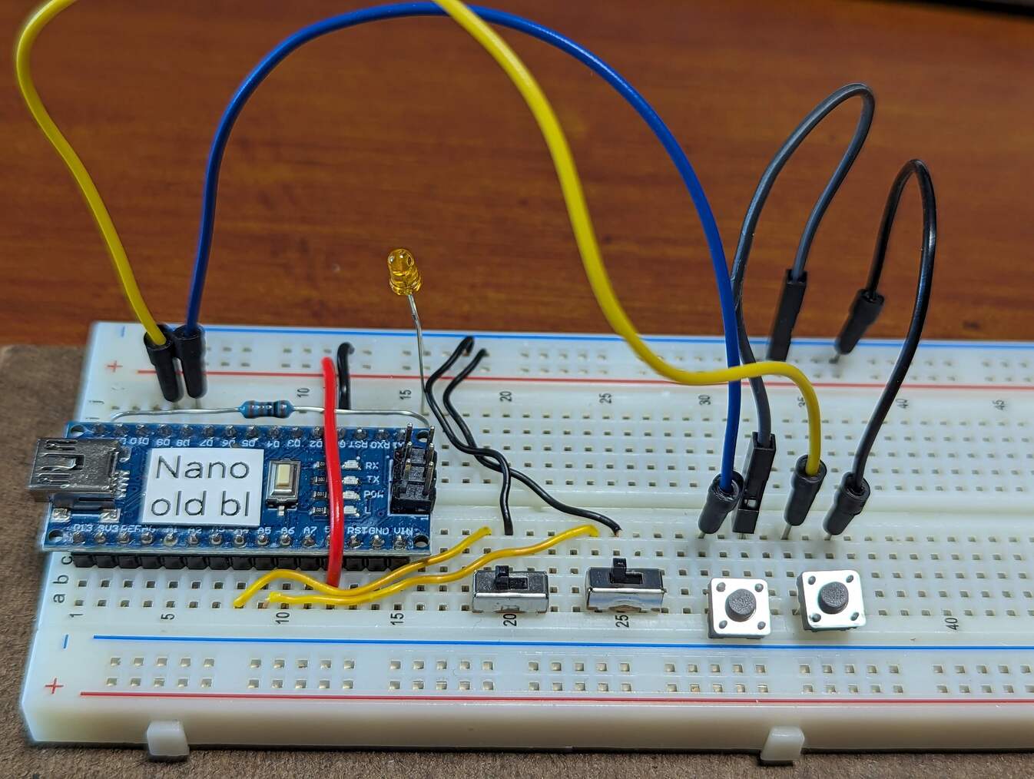
docs/source/construction/nano/direct-io/pushbutton-wired-mk1e.jpg
