DocBohn/CowPi_documentation/docs/source/construction/nano/direct-io/pushbutton-wired-mk1f.jpg

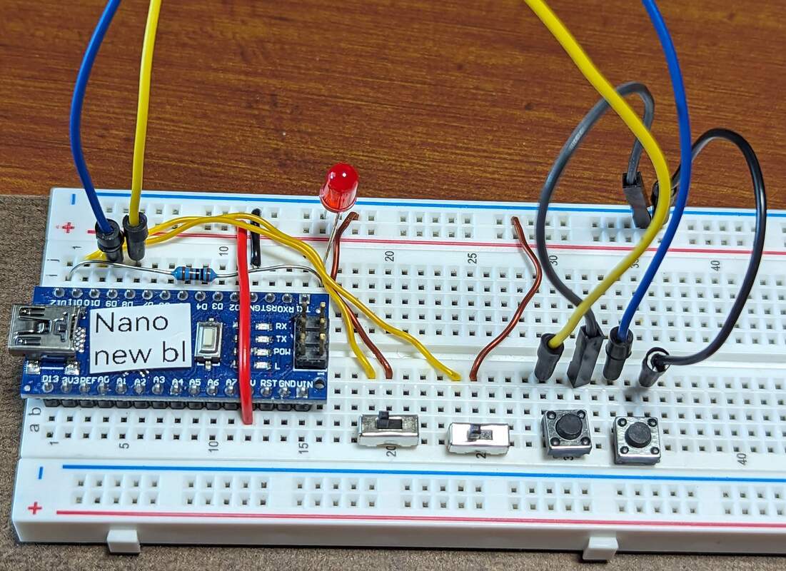
docs/source/construction/nano/direct-io/pushbutton-wired-mk1f.jpg
