DocBohn/CowPi_documentation/docs/source/construction/nano/direct-io/resistor-bent.jpg

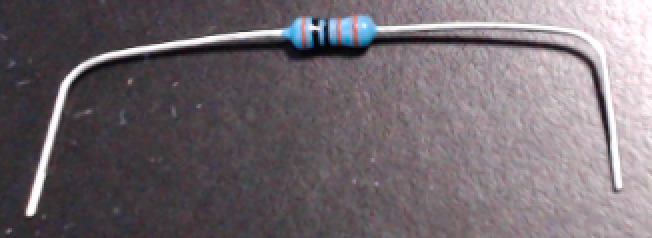
docs/source/construction/nano/direct-io/resistor-bent.jpg
