DocBohn/CowPi_documentation/docs/source/construction/nano/direct-io/resistor-inserted.jpg

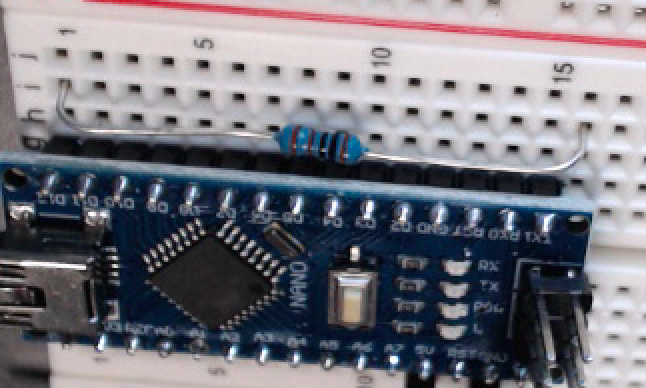
docs/source/construction/nano/direct-io/resistor-inserted.jpg
