DocBohn/CowPi_documentation/docs/source/construction/nano/direct-io/switches-spdt-mk1f.jpg

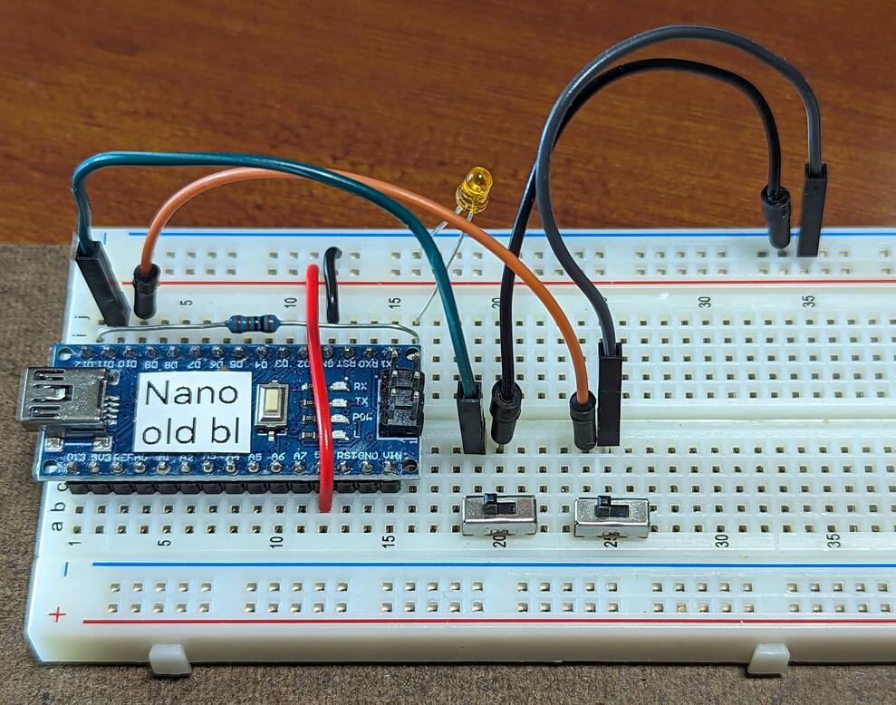
docs/source/construction/nano/direct-io/switches-spdt-mk1f.jpg
