DocBohn/CowPi_documentation/docs/source/construction/nano/display/animations/displaytest-0.jpg

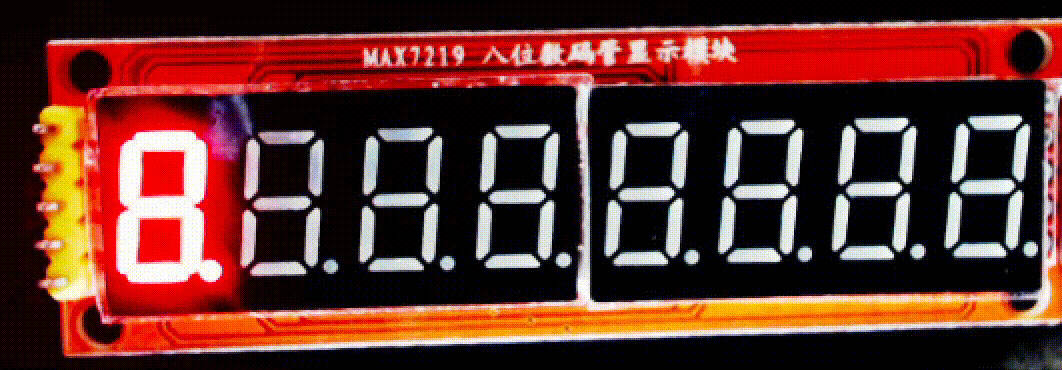
docs/source/construction/nano/display/animations/displaytest-0.jpg
