DocBohn/CowPi_documentation/docs/source/construction/nano/display/animations/displaytest-1.jpg

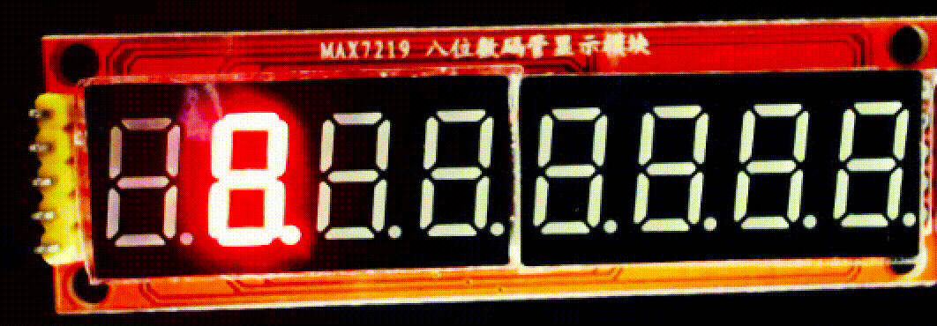
docs/source/construction/nano/display/animations/displaytest-1.jpg
