DocBohn/CowPi_documentation/docs/source/construction/nano/display/animations/displaytest-2.jpg

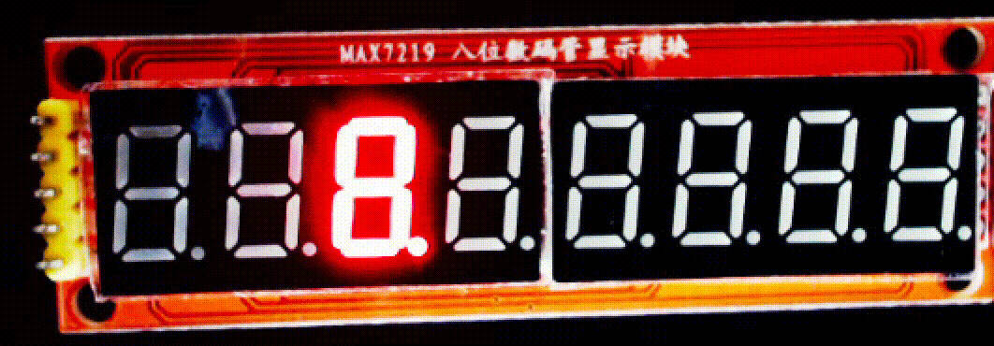
docs/source/construction/nano/display/animations/displaytest-2.jpg
