DocBohn/CowPi_documentation/docs/source/construction/nano/display/animations/displaytest-3.jpg

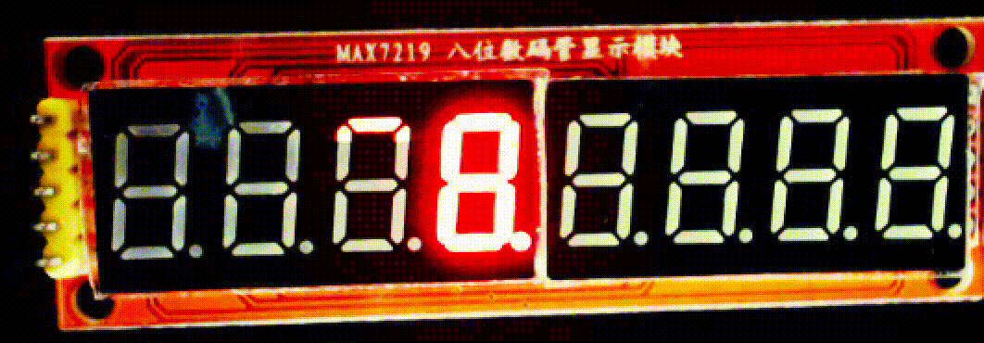
docs/source/construction/nano/display/animations/displaytest-3.jpg
