DocBohn/CowPi_documentation/docs/source/construction/nano/display/animations/displaytest-4.jpg

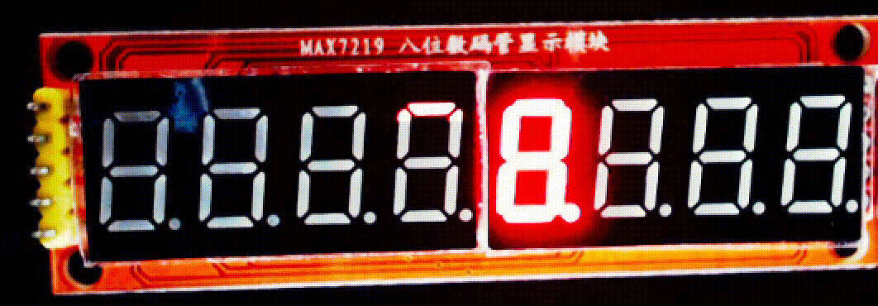
docs/source/construction/nano/display/animations/displaytest-4.jpg
