DocBohn/CowPi_documentation/docs/source/construction/nano/display/animations/displaytest-5.jpg

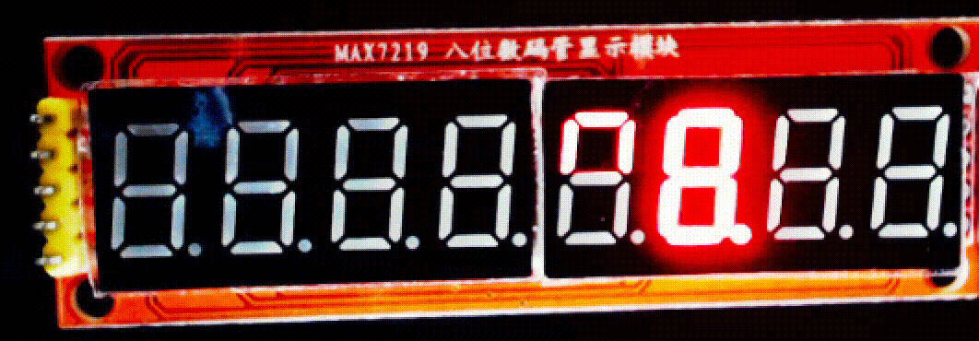
docs/source/construction/nano/display/animations/displaytest-5.jpg
