DocBohn/CowPi_documentation/docs/source/construction/nano/display/animations/displaytest-6.jpg

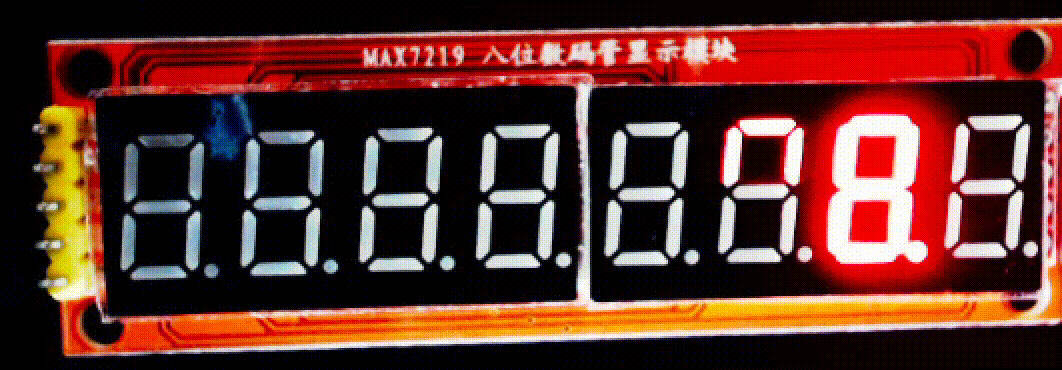
docs/source/construction/nano/display/animations/displaytest-6.jpg
