DocBohn/CowPi_documentation/docs/source/construction/nano/display/animations/displaytest-7.jpg

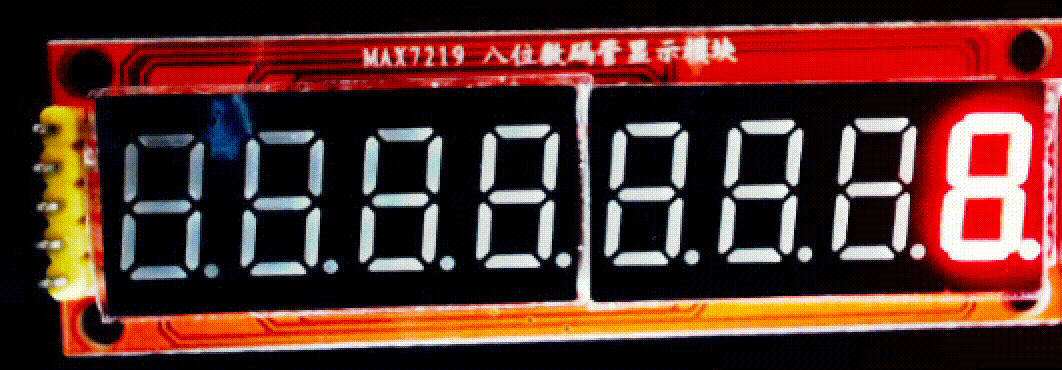
docs/source/construction/nano/display/animations/displaytest-7.jpg
