DocBohn/CowPi_documentation/docs/source/construction/nano/display/animations/lcd1602-0.jpg

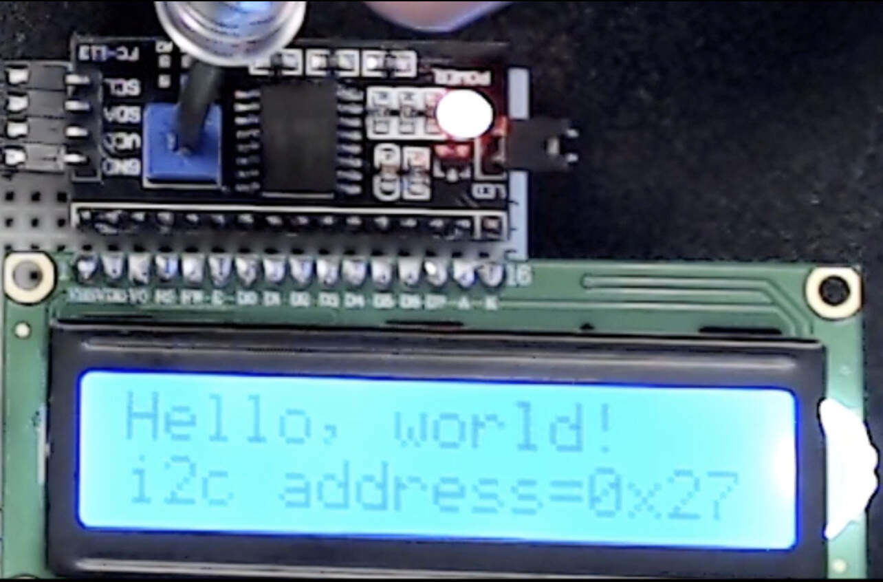
docs/source/construction/nano/display/animations/lcd1602-0.jpg
