DocBohn/CowPi_documentation/docs/source/construction/nano/display/display-connections-mk1e.jpg

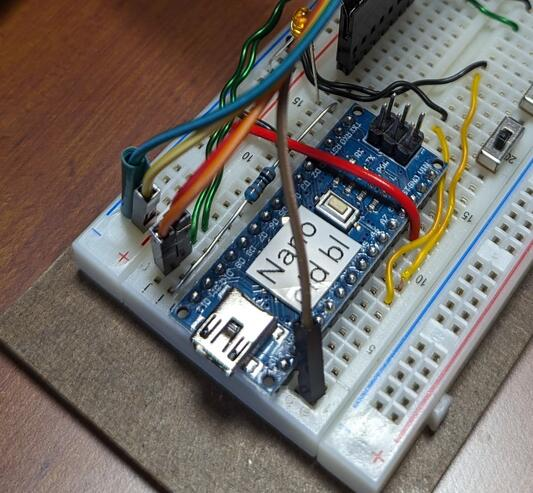
docs/source/construction/nano/display/display-connections-mk1e.jpg
