DocBohn/CowPi_documentation/docs/source/construction/nano/display/display-connections-mk1f.jpg

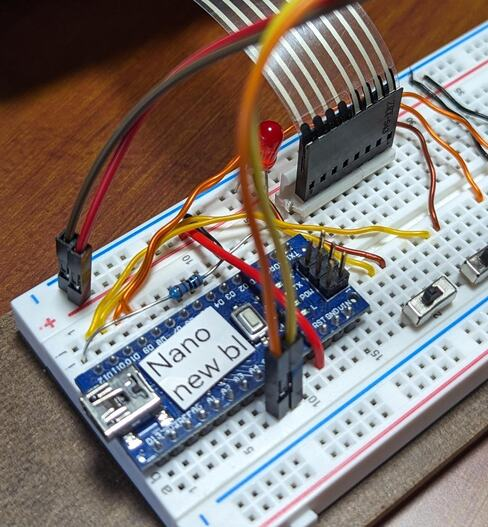
docs/source/construction/nano/display/display-connections-mk1f.jpg
