DocBohn/CowPi_documentation/docs/source/construction/nano/display/hd44780-character-floating-display.jpg

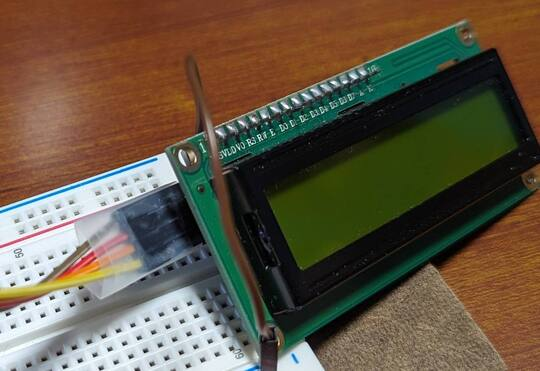
docs/source/construction/nano/display/hd44780-character-floating-display.jpg
