DocBohn/CowPi_documentation/docs/source/construction/nano/display/i2c-module-header.jpg

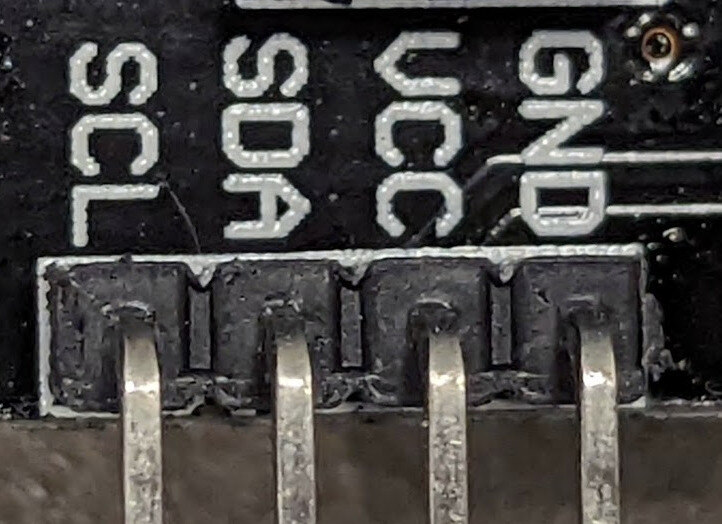
docs/source/construction/nano/display/i2c-module-header.jpg
