DocBohn/CowPi_documentation/docs/source/construction/nano/display/max7219-matrix-floating-display.jpg

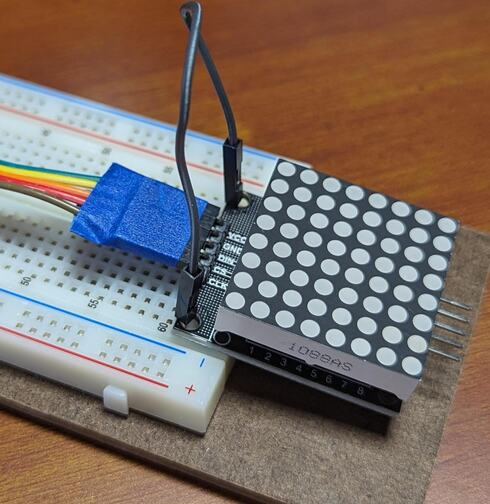
docs/source/construction/nano/display/max7219-matrix-floating-display.jpg
