DocBohn/CowPi_documentation/docs/source/construction/nano/display/max7219-matrix-pinned-display.jpg

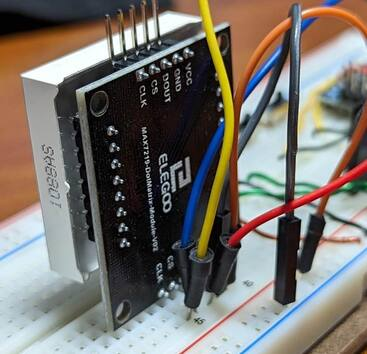
docs/source/construction/nano/display/max7219-matrix-pinned-display.jpg
