DocBohn/CowPi_documentation/docs/source/construction/nano/display/max7219-segment-display.jpg

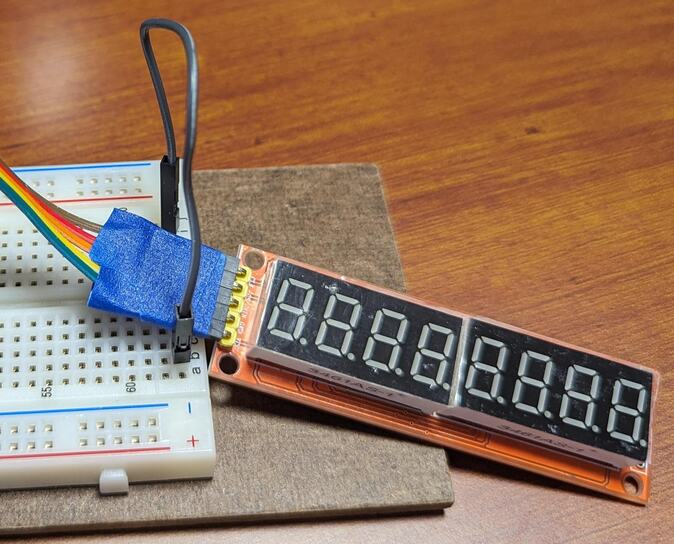
docs/source/construction/nano/display/max7219-segment-display.jpg
