DocBohn/CowPi_documentation/docs/source/construction/nano/display/spi-module-header.jpg

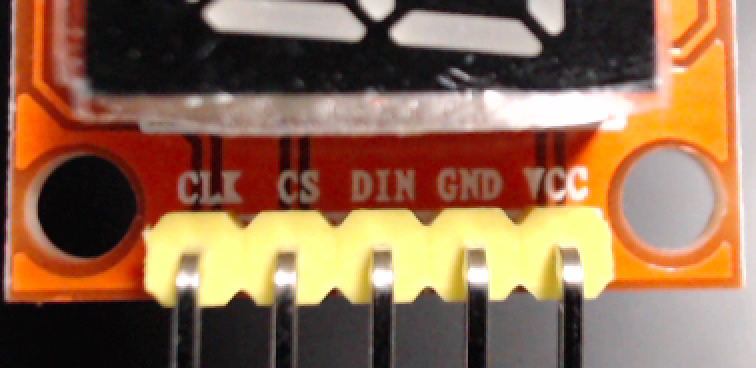
docs/source/construction/nano/display/spi-module-header.jpg
