DocBohn/CowPi_documentation/docs/source/construction/nano/display/ssd1306-oled-graphic-display.jpg

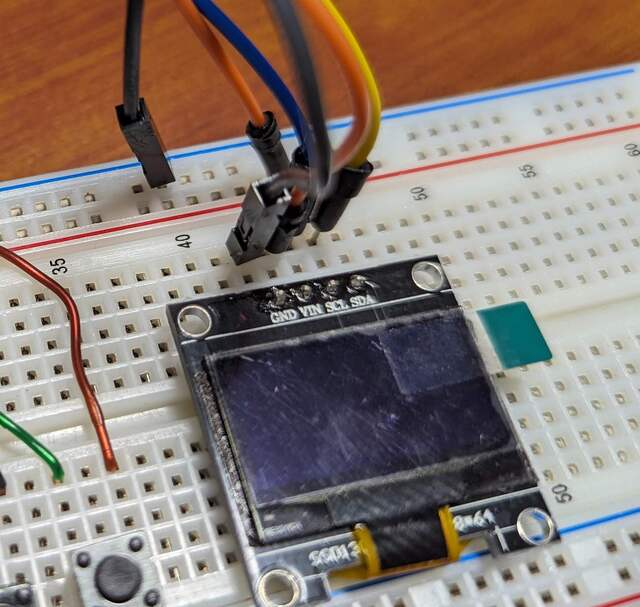
docs/source/construction/nano/display/ssd1306-oled-graphic-display.jpg
