DocBohn/CowPi_documentation/docs/source/construction/nano/fritzing_diagrams/CowPi-mk1e-display-max7219.png

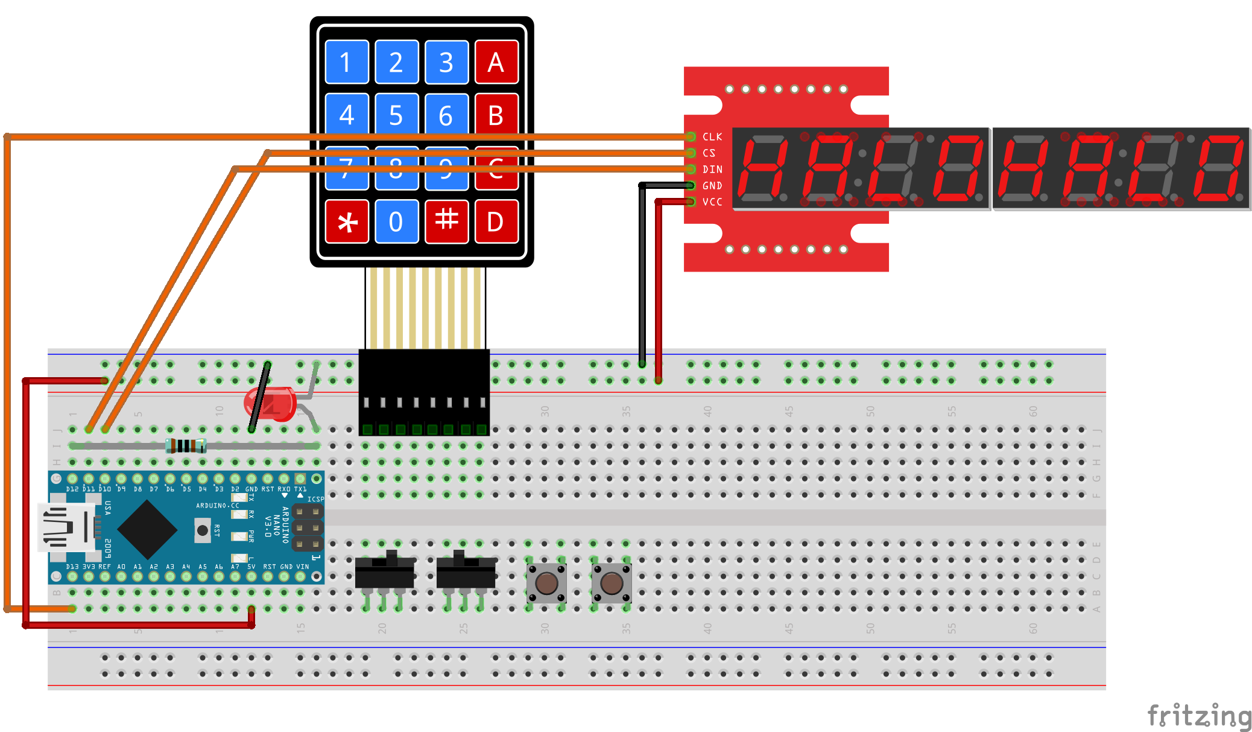
docs/source/construction/nano/fritzing_diagrams/CowPi-mk1e-display-max7219.png
