DocBohn/CowPi_documentation/docs/source/construction/nano/fritzing_diagrams/CowPi-mk1ef-keypad.png

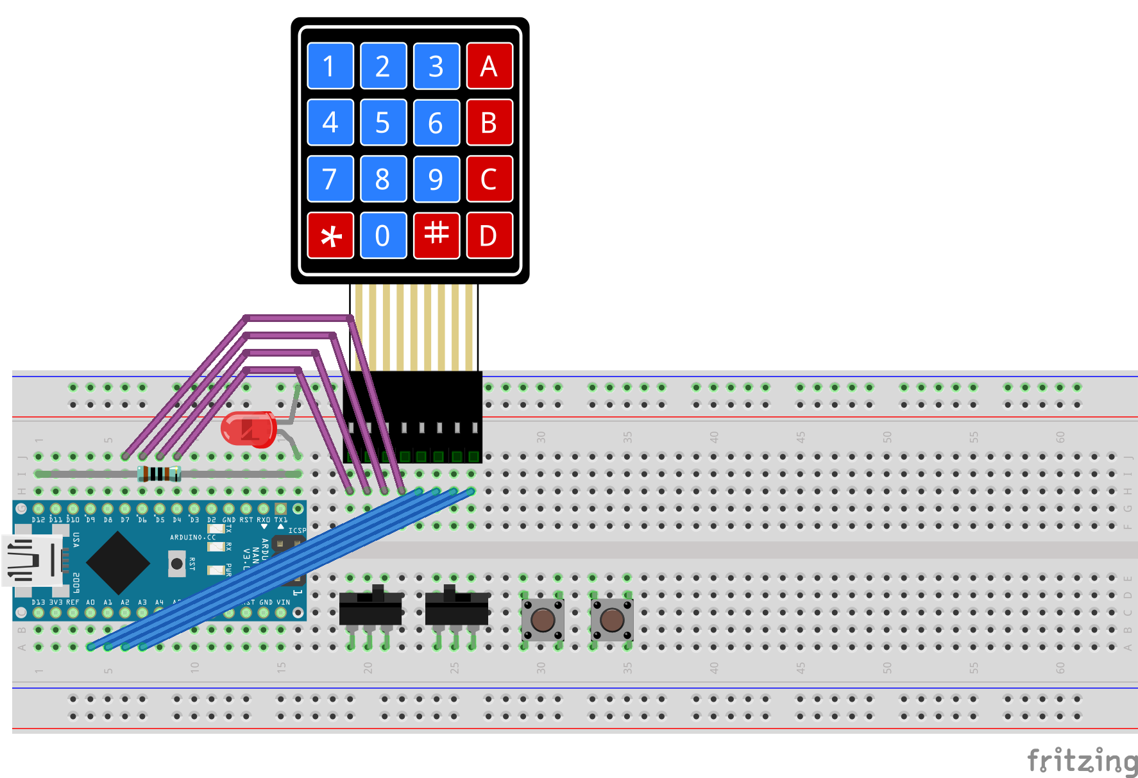
docs/source/construction/nano/fritzing_diagrams/CowPi-mk1ef-keypad.png
