DocBohn/CowPi_documentation/docs/source/construction/nano/fritzing_diagrams/CowPi-mk1ef-led.png

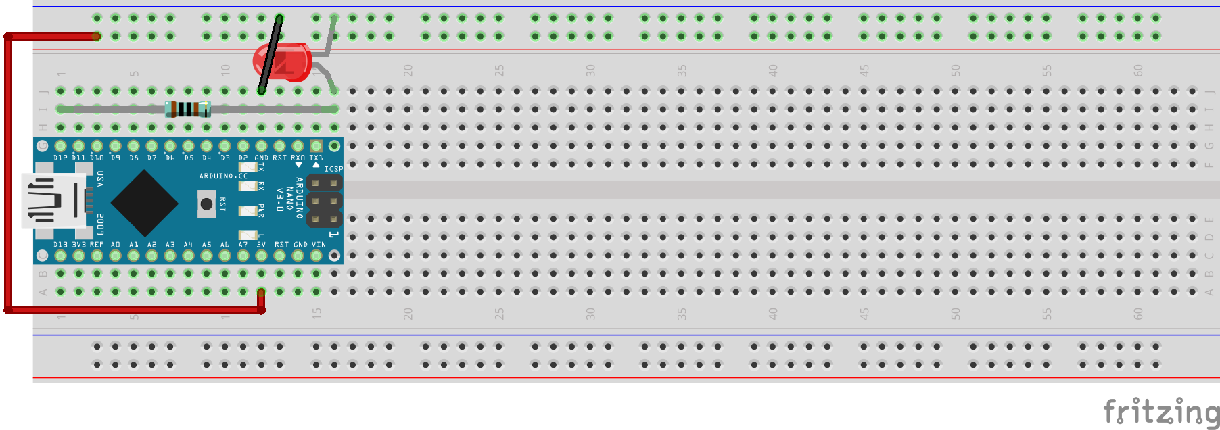
docs/source/construction/nano/fritzing_diagrams/CowPi-mk1ef-led.png
