DocBohn/CowPi_documentation/docs/source/construction/nano/fritzing_diagrams/CowPi-mk1ef-pushbutton-2lead.png

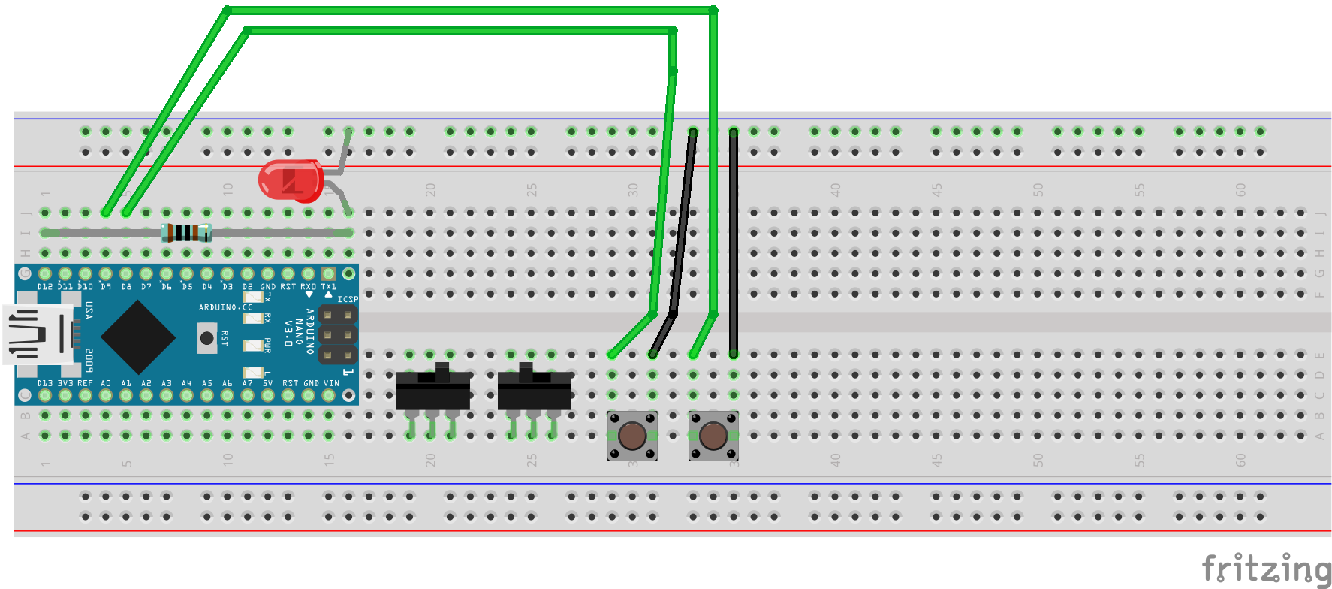
docs/source/construction/nano/fritzing_diagrams/CowPi-mk1ef-pushbutton-2lead.png
