DocBohn/CowPi_documentation/docs/source/construction/nano/fritzing_diagrams/CowPi-mk1f-display-lcd1602.png

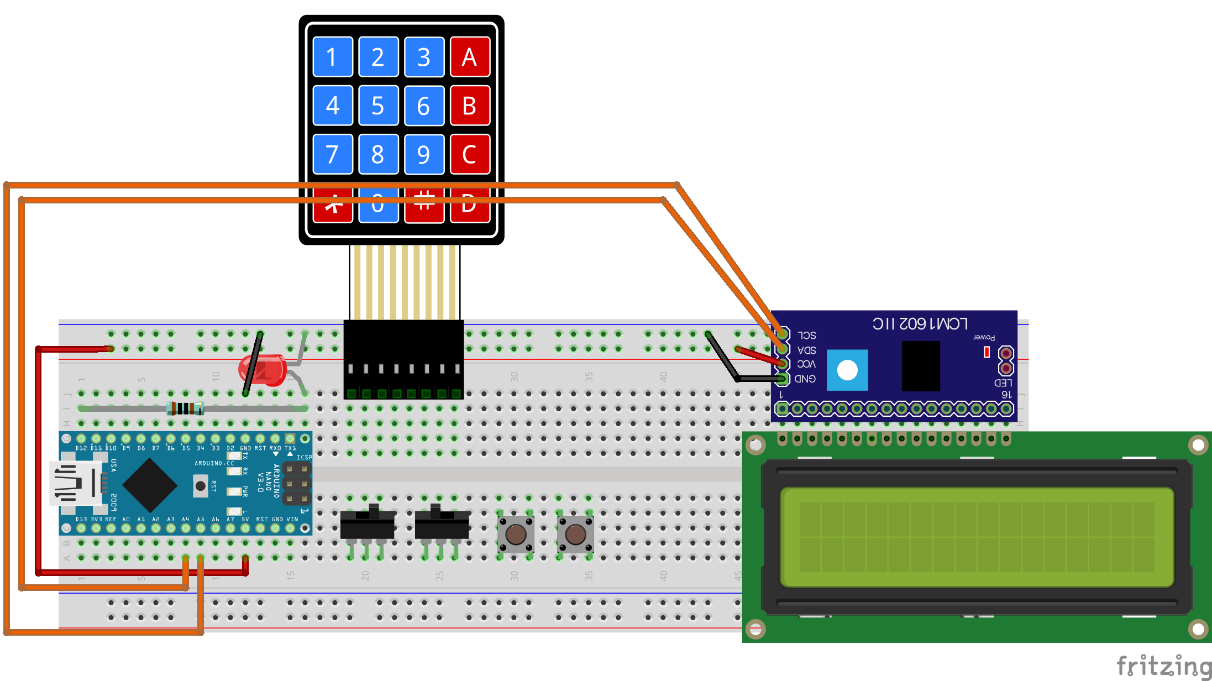
docs/source/construction/nano/fritzing_diagrams/CowPi-mk1f-display-lcd1602.png
