DocBohn/CowPi_documentation/docs/source/construction/nano/fritzing_diagrams/CowPi-mk1f-lcd1602-complete.png

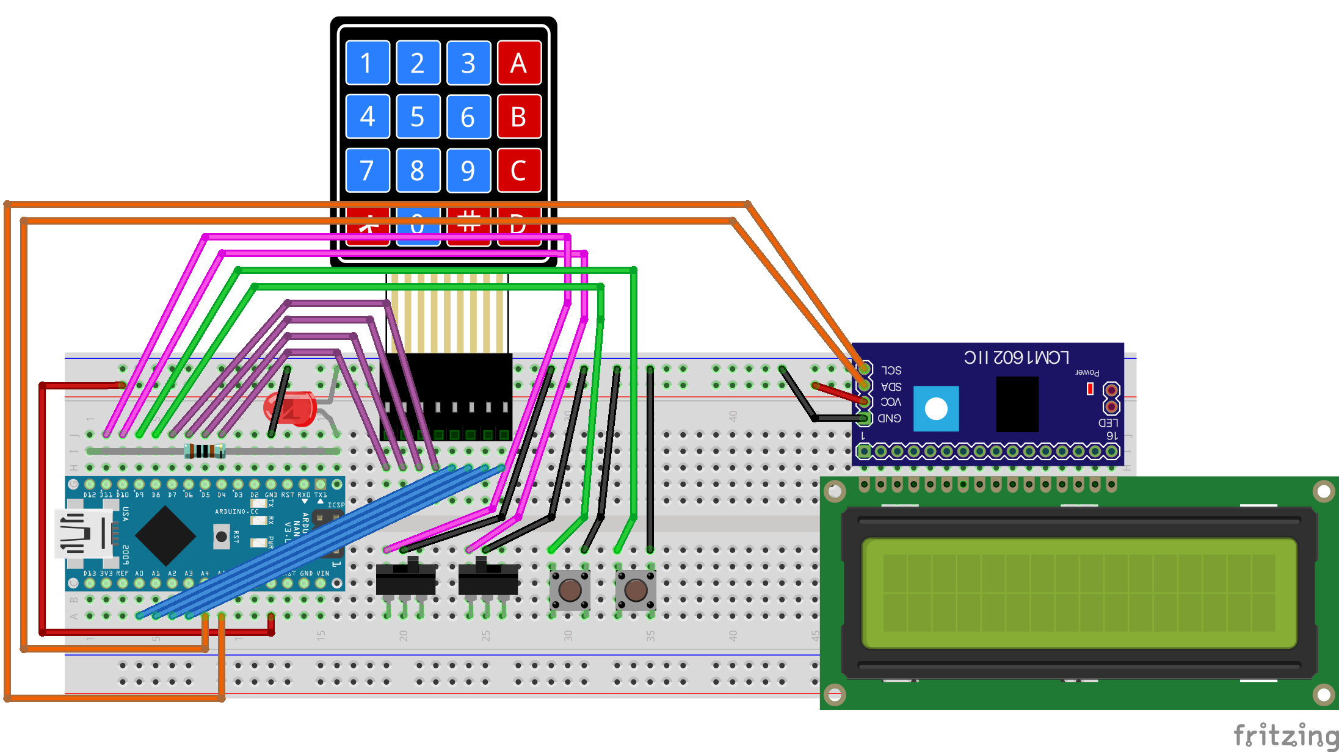
docs/source/construction/nano/fritzing_diagrams/CowPi-mk1f-lcd1602-complete.png
