DocBohn/CowPi_documentation/docs/source/construction/nano/fritzing_diagrams/CowPi-mk1f-switch-spdt.png

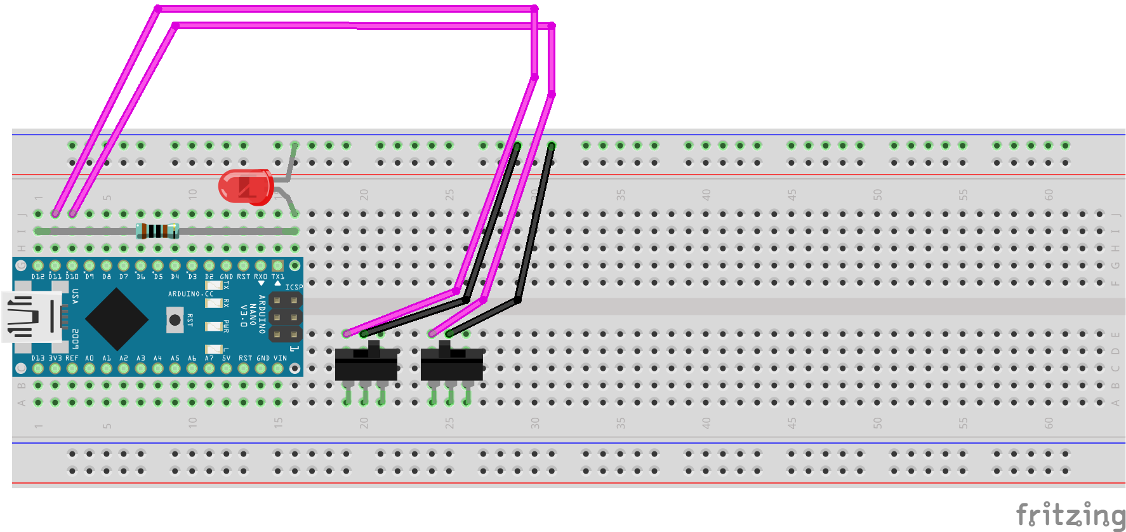
docs/source/construction/nano/fritzing_diagrams/CowPi-mk1f-switch-spdt.png
