DocBohn/CowPi_documentation/docs/source/construction/nano/keypad/keypad-annotated.jpg

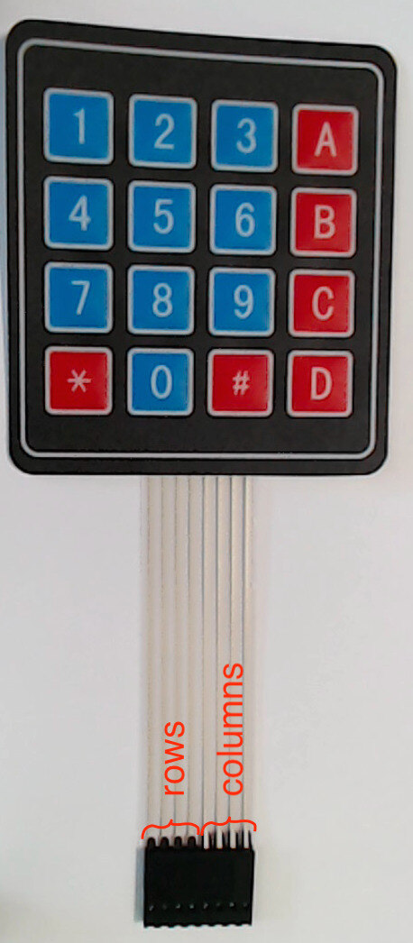
docs/source/construction/nano/keypad/keypad-annotated.jpg
