DocBohn/CowPi_documentation/docs/source/construction/nano/keypad/keypad-cables.jpg

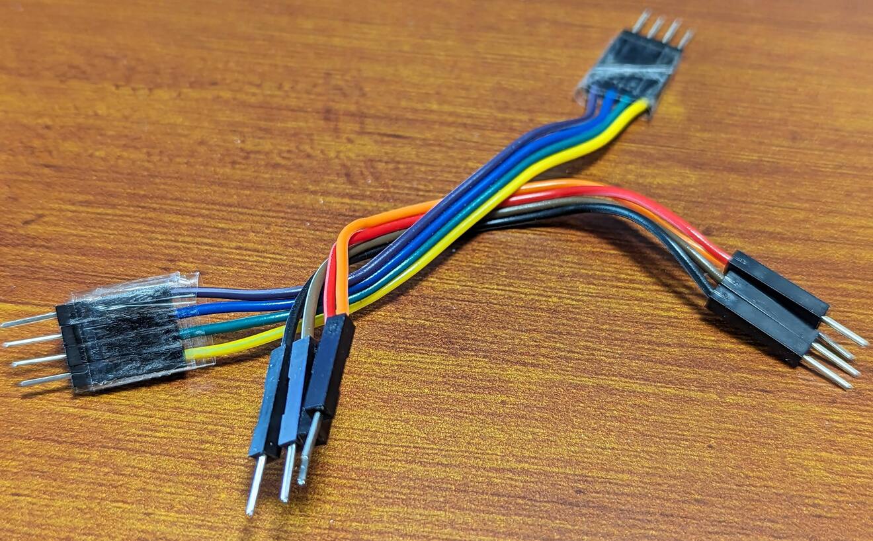
docs/source/construction/nano/keypad/keypad-cables.jpg
