DocBohn/CowPi_documentation/docs/source/construction/nano/keypad/keypad-columns-mk1e.jpg

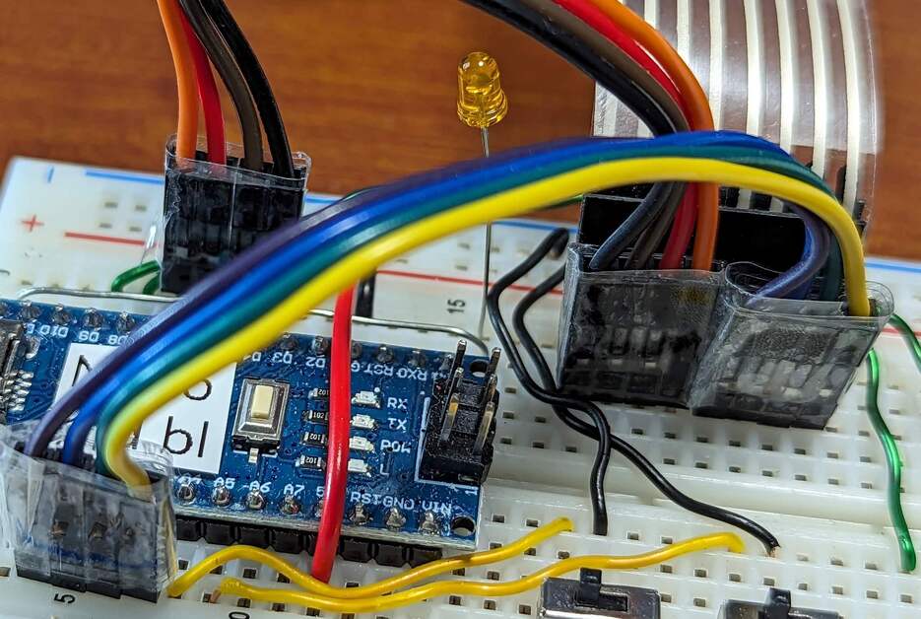
docs/source/construction/nano/keypad/keypad-columns-mk1e.jpg
