DocBohn/CowPi_documentation/docs/source/construction/nano/keypad/keypad-columns-mk1f.jpg

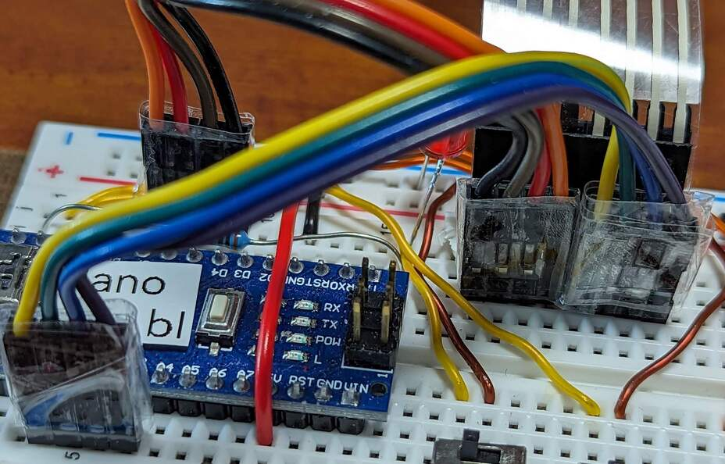
docs/source/construction/nano/keypad/keypad-columns-mk1f.jpg
