DocBohn/CowPi_documentation/docs/source/construction/nano/keypad/keypad-matrix.png

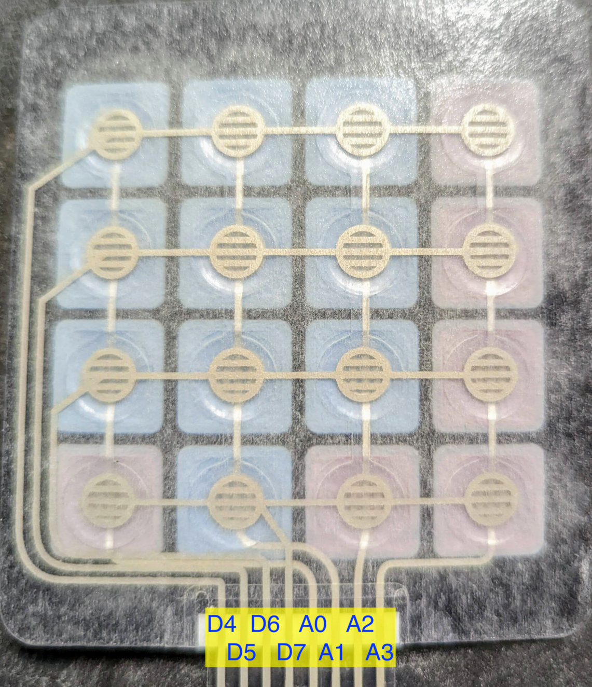
docs/source/construction/nano/keypad/keypad-matrix.png
