DocBohn/CowPi_documentation/docs/source/construction/nano/keypad/keypad-pullingwires.jpg

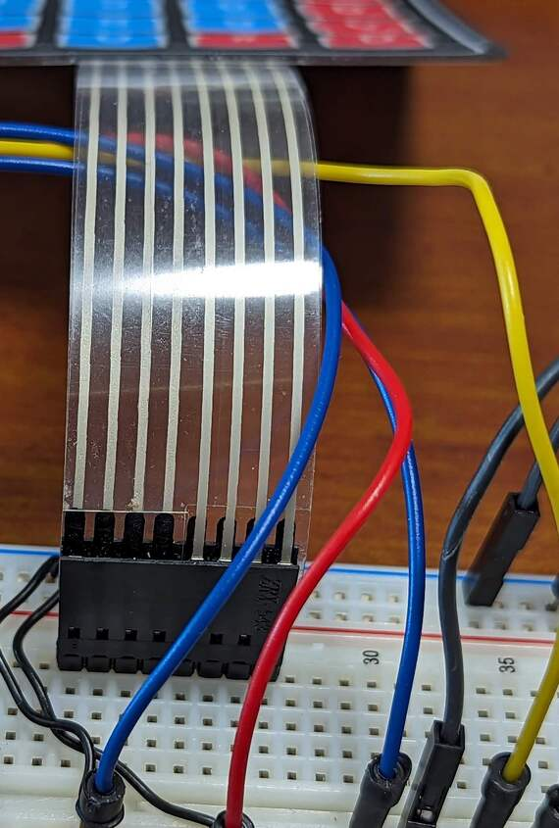
docs/source/construction/nano/keypad/keypad-pullingwires.jpg
