DocBohn/CowPi_documentation/docs/source/construction/nano/keypad/keypad-rows-mk1e.jpg

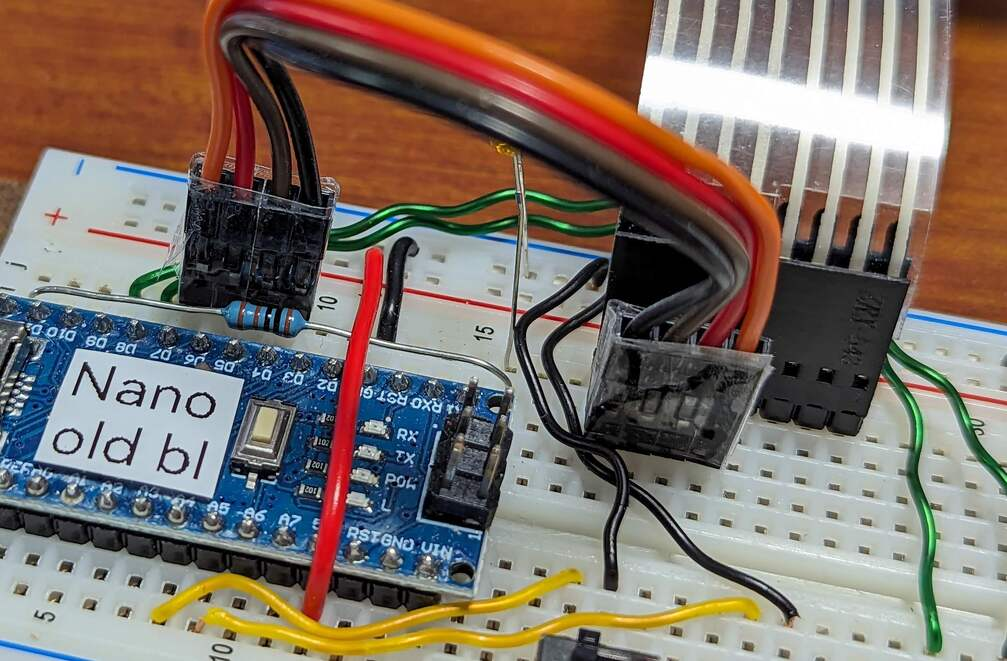
docs/source/construction/nano/keypad/keypad-rows-mk1e.jpg
