DocBohn/CowPi_documentation/docs/source/construction/nano/keypad/keypad-rows-mk1f.jpg

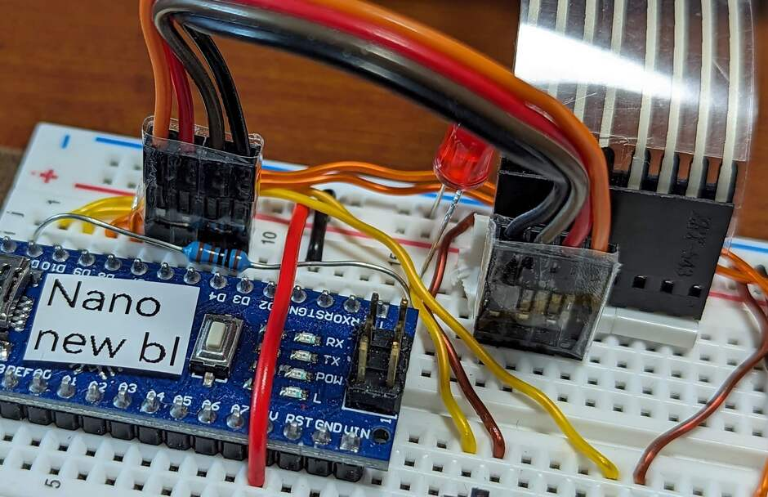
docs/source/construction/nano/keypad/keypad-rows-mk1f.jpg
