DocBohn/CowPi_documentation/docs/source/construction/nano/microcontroller/animations/myblink-0.jpg

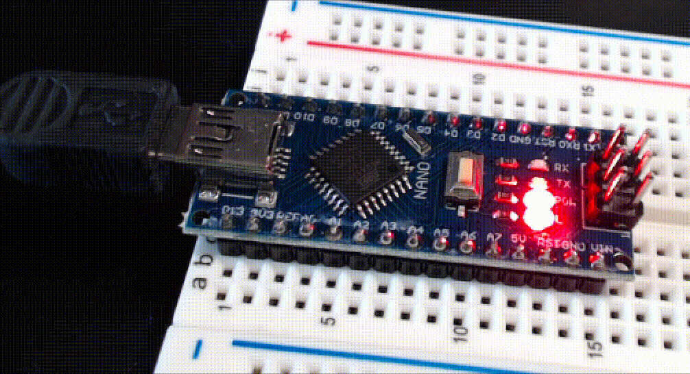
docs/source/construction/nano/microcontroller/animations/myblink-0.jpg
