DocBohn/CowPi_documentation/docs/source/construction/nano/microcontroller/animations/myblink-2.jpg

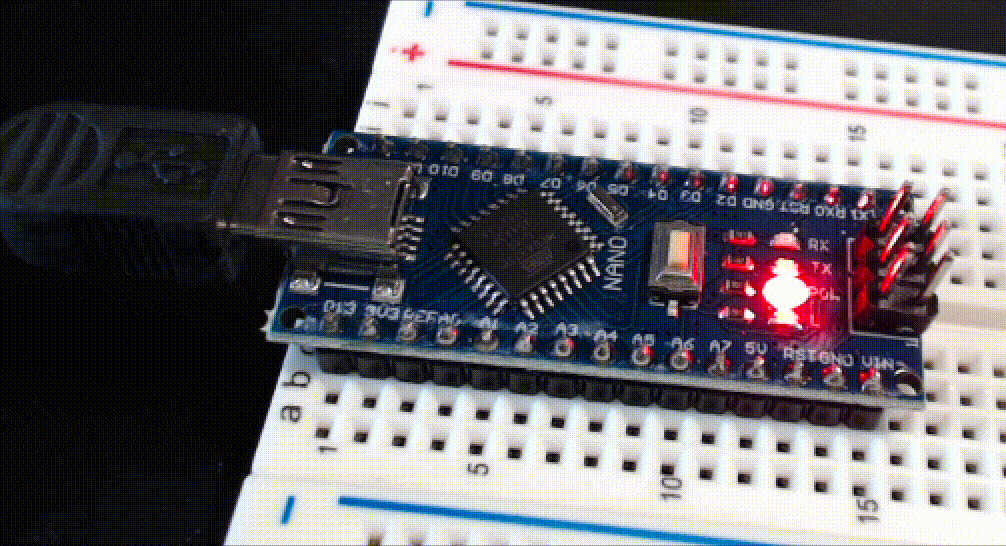
docs/source/construction/nano/microcontroller/animations/myblink-2.jpg
