DocBohn/CowPi_documentation/docs/source/construction/nano/microcontroller/inserting-nano.jpg

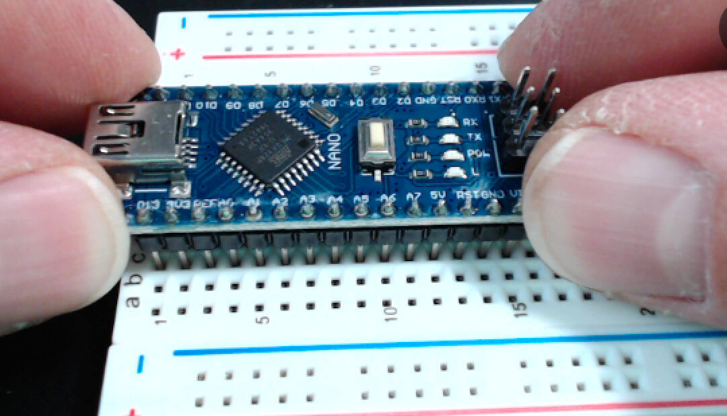
docs/source/construction/nano/microcontroller/inserting-nano.jpg
