DocBohn/CowPi_documentation/docs/source/construction/nano/microcontroller/libraries-arduino.png

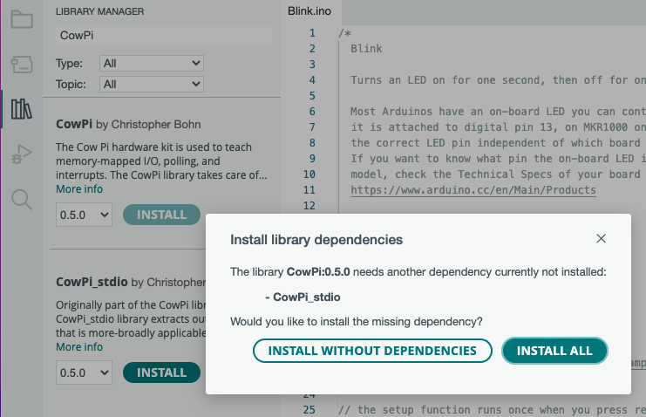
docs/source/construction/nano/microcontroller/libraries-arduino.png
