DocBohn/CowPi_documentation/docs/source/construction/nano/microcontroller/nano-fully-inserted.jpg

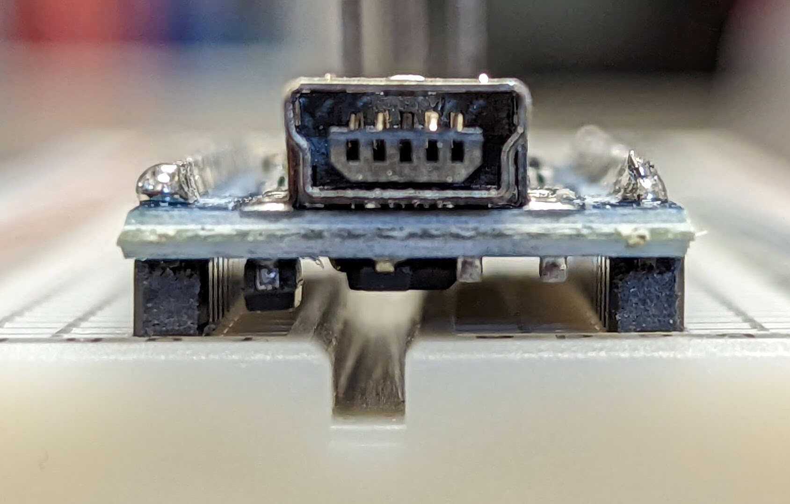
docs/source/construction/nano/microcontroller/nano-fully-inserted.jpg
