DocBohn/CowPi_documentation/docs/source/construction/nano/microcontroller/platformioINI.png

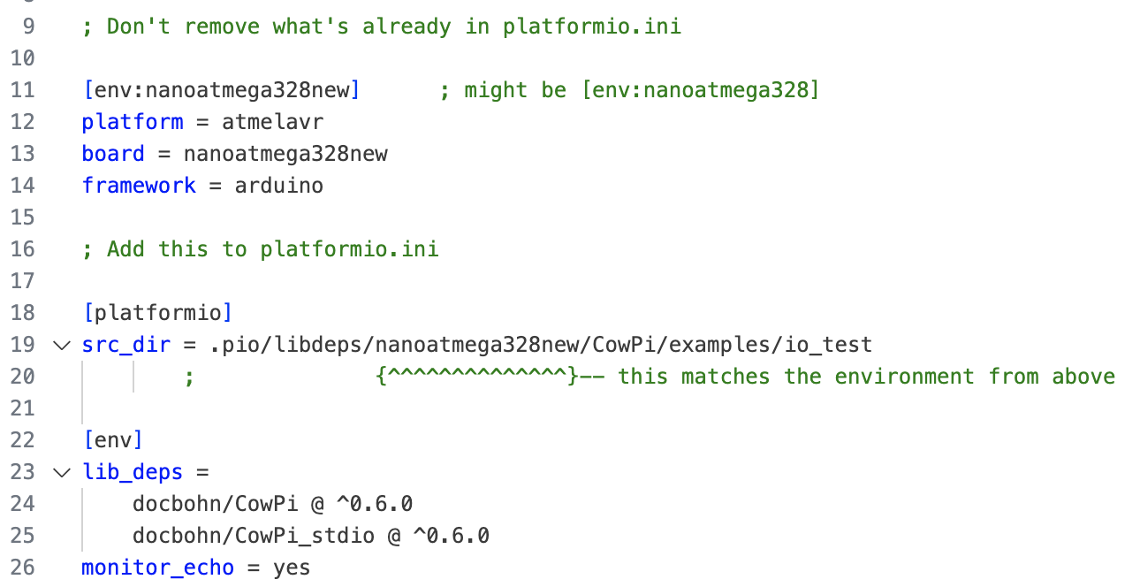
docs/source/construction/nano/microcontroller/platformioINI.png
