DocBohn/CowPi_documentation/docs/source/construction/nano/microcontroller/platformIOReadyForIOTest.png

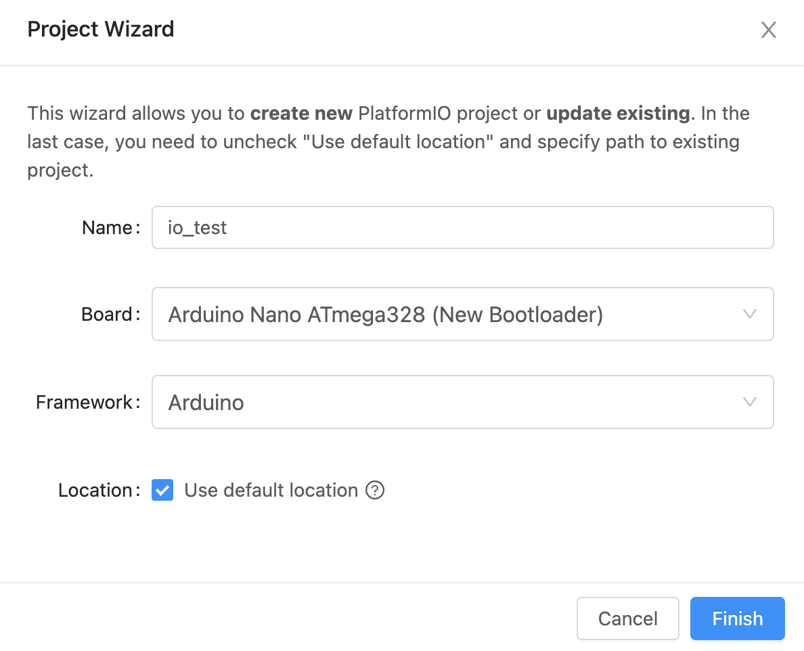
docs/source/construction/nano/microcontroller/platformIOReadyForIOTest.png
