DocBohn/CowPi_documentation/docs/source/construction/nano/microcontroller/platformioReadyForNewProject.png

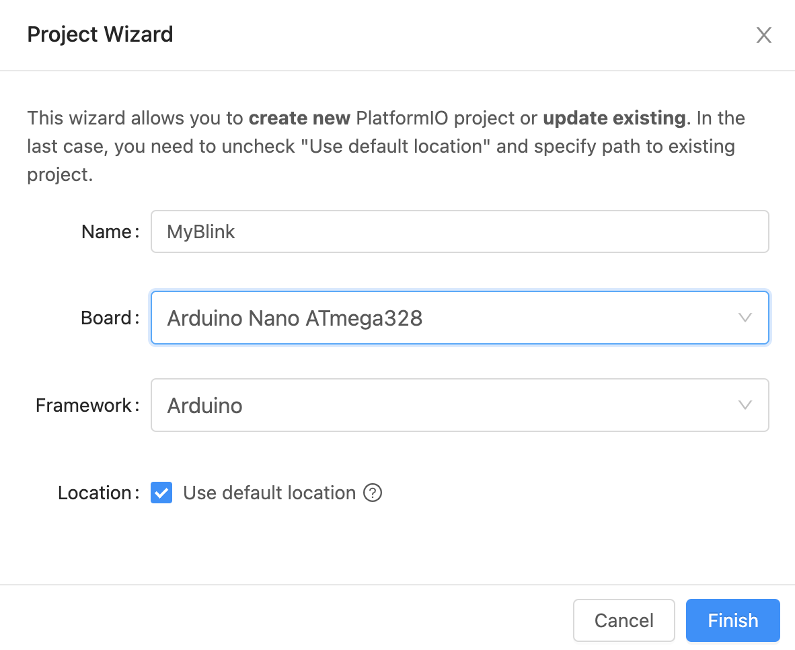
docs/source/construction/nano/microcontroller/platformioReadyForNewProject.png
