DocBohn/CowPi_documentation/docs/source/construction/nano/microcontroller/platformioSelectBoard.png

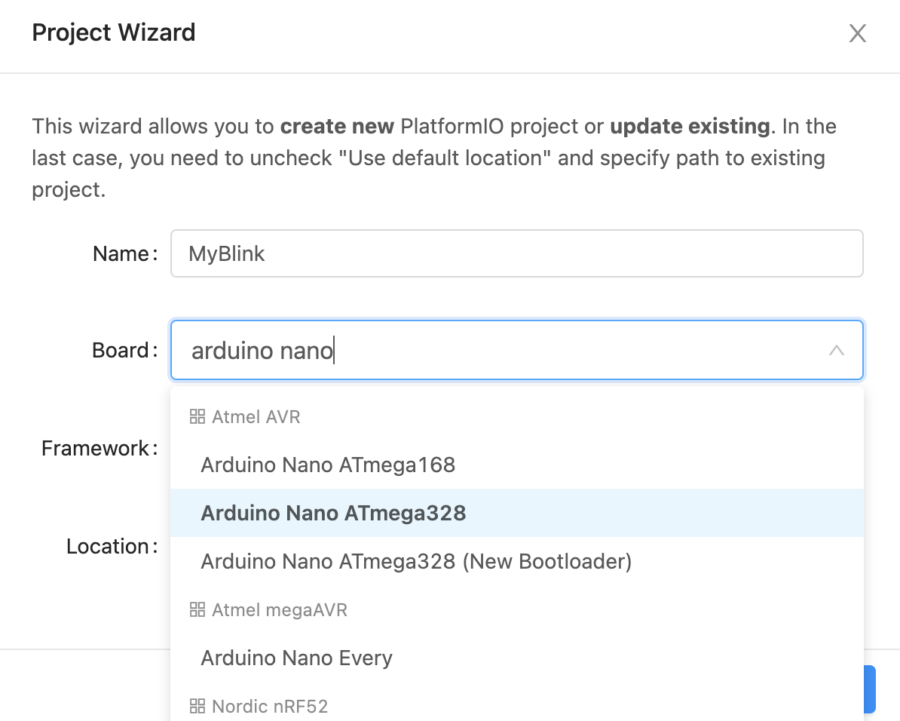
docs/source/construction/nano/microcontroller/platformioSelectBoard.png
