DocBohn/CowPi_documentation/docs/source/construction/nano/microcontroller/platformIOStartingProject.png

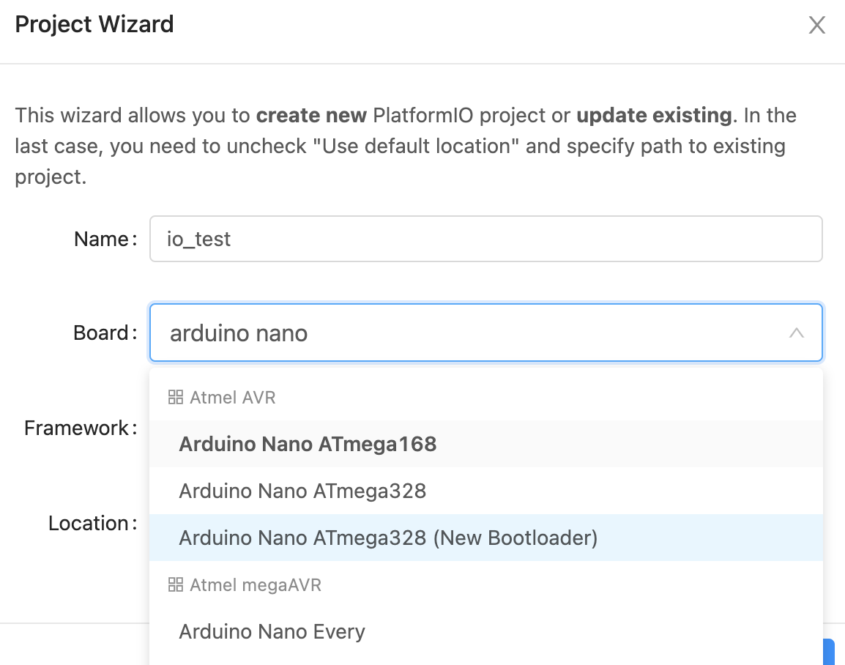
docs/source/construction/nano/microcontroller/platformIOStartingProject.png
