DocBohn/CowPi_documentation/docs/source/construction/nano/microcontroller/power.jpg

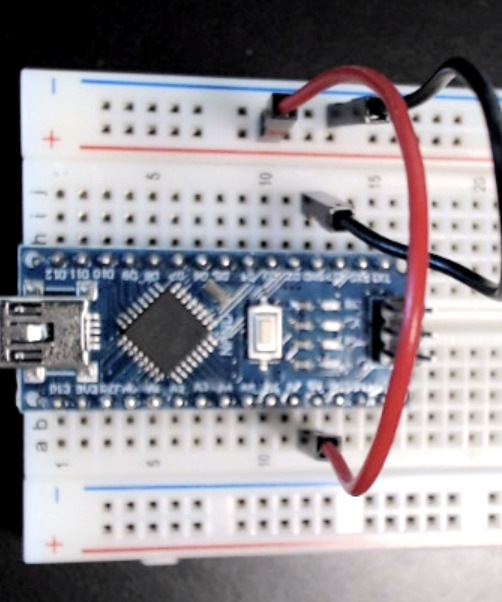
docs/source/construction/nano/microcontroller/power.jpg
