DocBohn/CowPi_documentation/docs/source/construction/nano/microcontroller/selecting-nano-processor.jpg

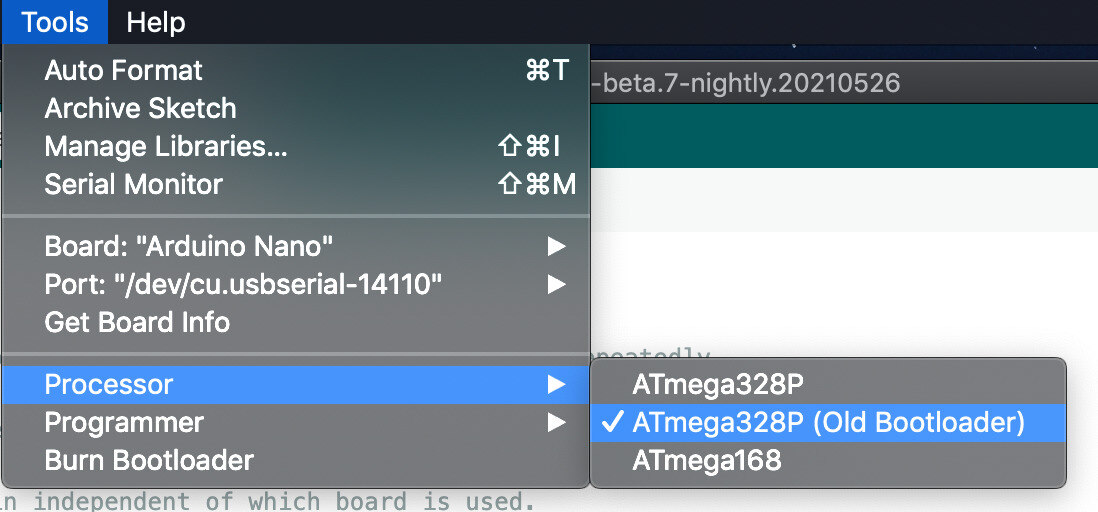
docs/source/construction/nano/microcontroller/selecting-nano-processor.jpg
