DocBohn/CowPi_documentation/docs/source/construction/nano/microcontroller/selecting-nano.jpg

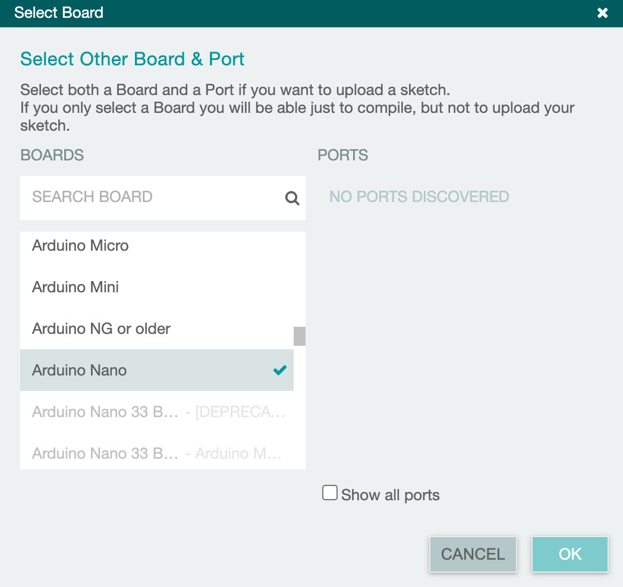
docs/source/construction/nano/microcontroller/selecting-nano.jpg
