DocBohn/CowPi_documentation/docs/source/construction/nano/microcontroller/terminalServerPlatformIO.png

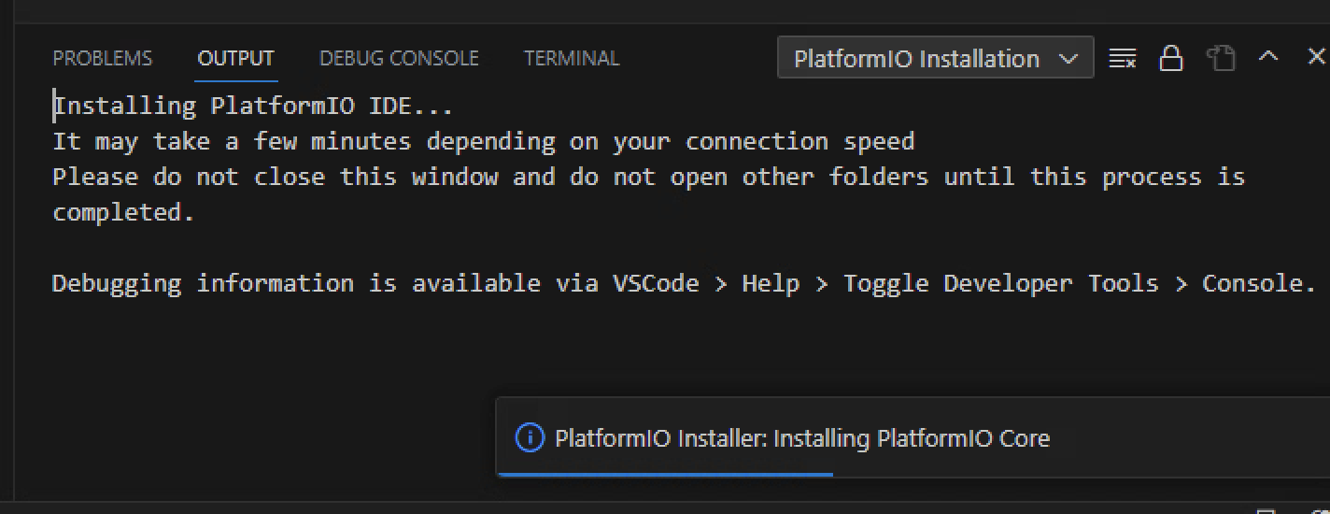
docs/source/construction/nano/microcontroller/terminalServerPlatformIO.png
