DocBohn/CowPi_documentation/docs/source/construction/nano/microcontroller/terminalServerUSB.png

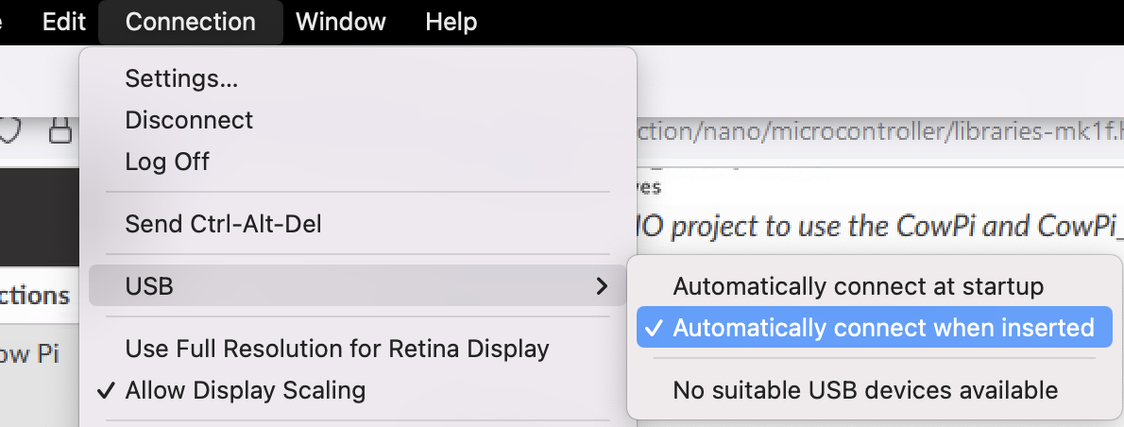
docs/source/construction/nano/microcontroller/terminalServerUSB.png
