DocBohn/CowPi_documentation/docs/source/construction/pico/mk3c-images/aligning-upper-socket.jpeg

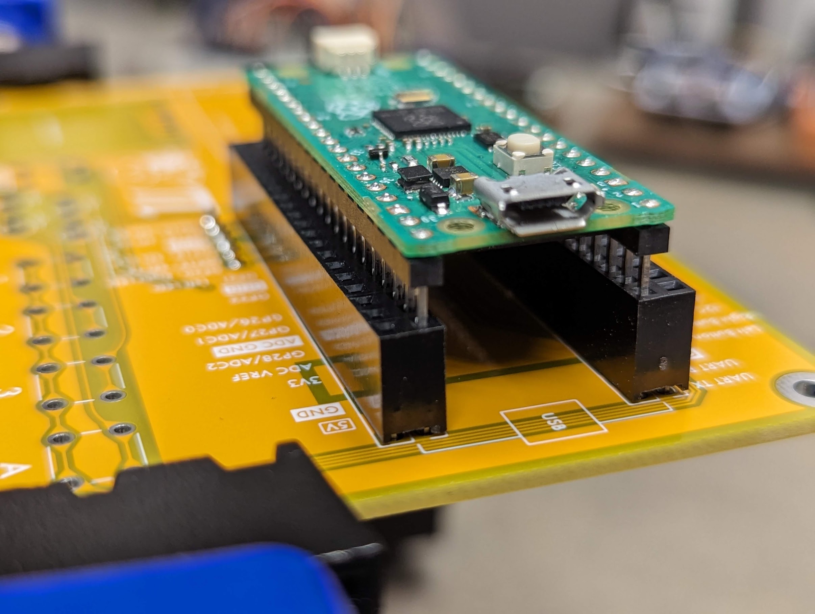
docs/source/construction/pico/mk3c-images/aligning-upper-socket.jpeg
