DocBohn/CowPi_documentation/docs/source/construction/pico/mk3c-images/aligning-voltage-booster.jpeg

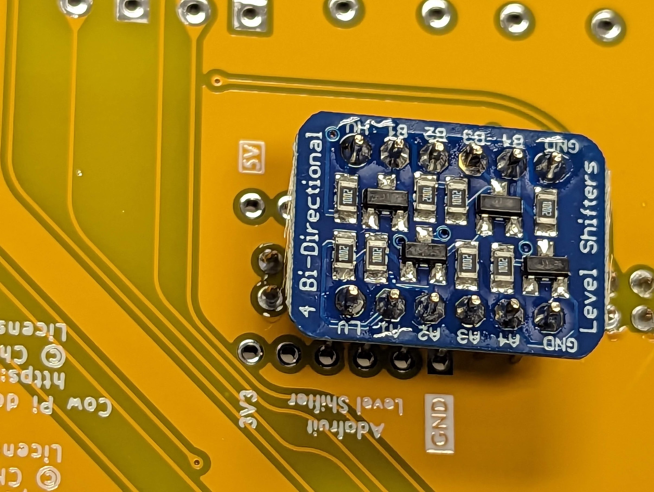
docs/source/construction/pico/mk3c-images/aligning-voltage-booster.jpeg
