DocBohn/CowPi_documentation/docs/source/construction/pico/mk3c-images/attaching-headers.jpeg

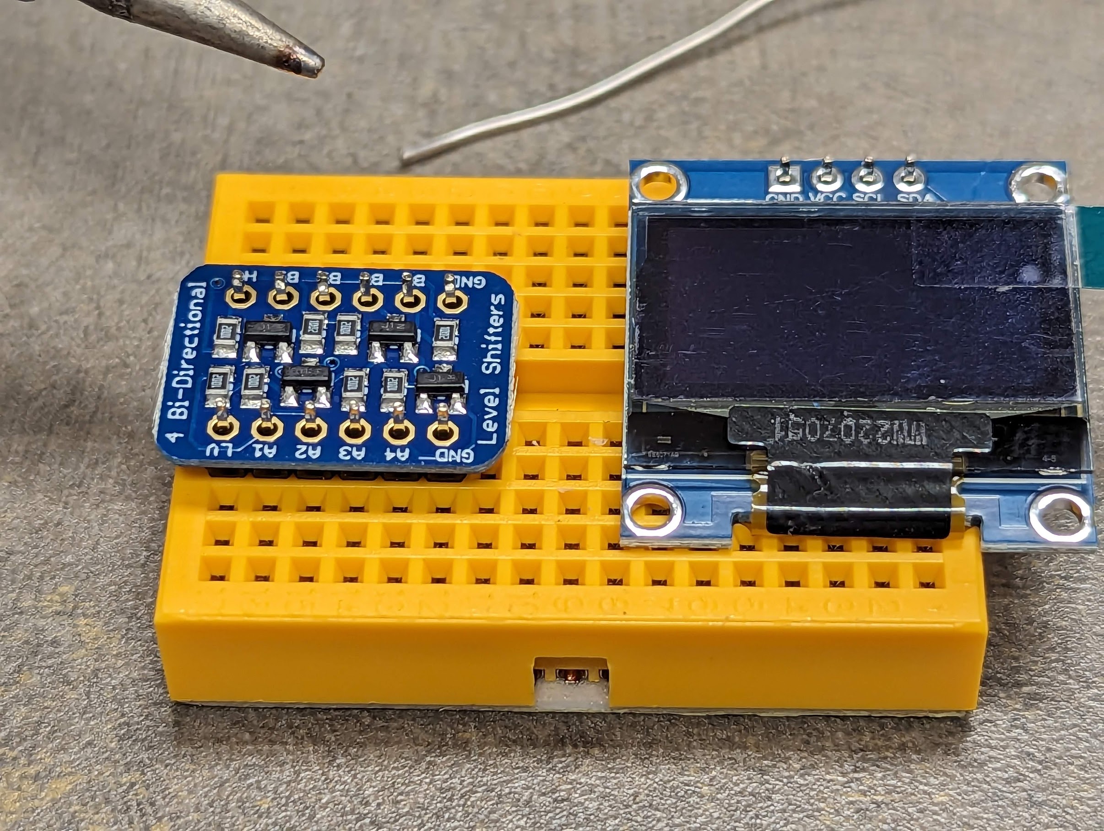
docs/source/construction/pico/mk3c-images/attaching-headers.jpeg
