DocBohn/CowPi_documentation/docs/source/construction/pico/mk3c-images/breadboard.jpeg

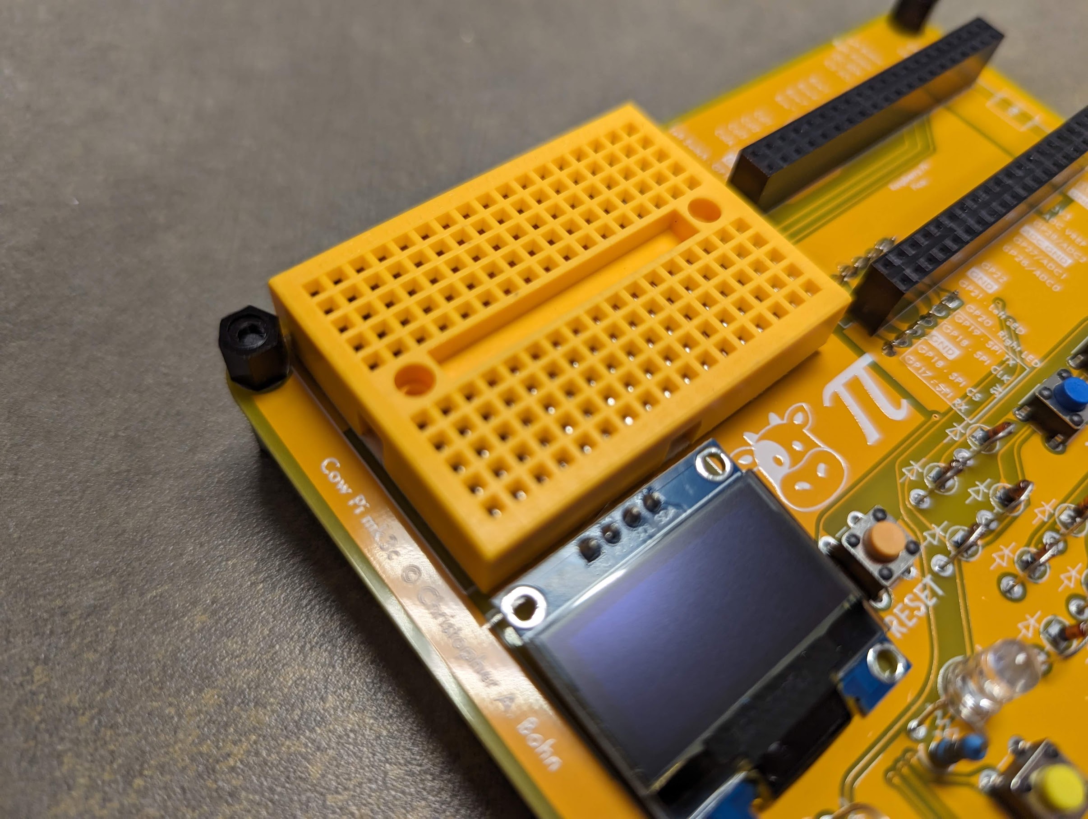
docs/source/construction/pico/mk3c-images/breadboard.jpeg
