DocBohn/CowPi_documentation/docs/source/construction/pico/mk3c-images/complete-back.jpg

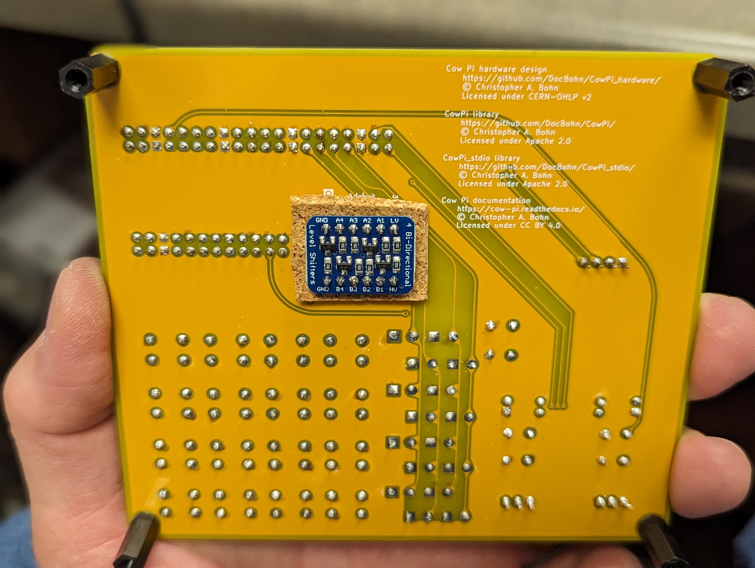
docs/source/construction/pico/mk3c-images/complete-back.jpg
