DocBohn/CowPi_documentation/docs/source/construction/pico/mk3c-images/cork-attached.jpeg

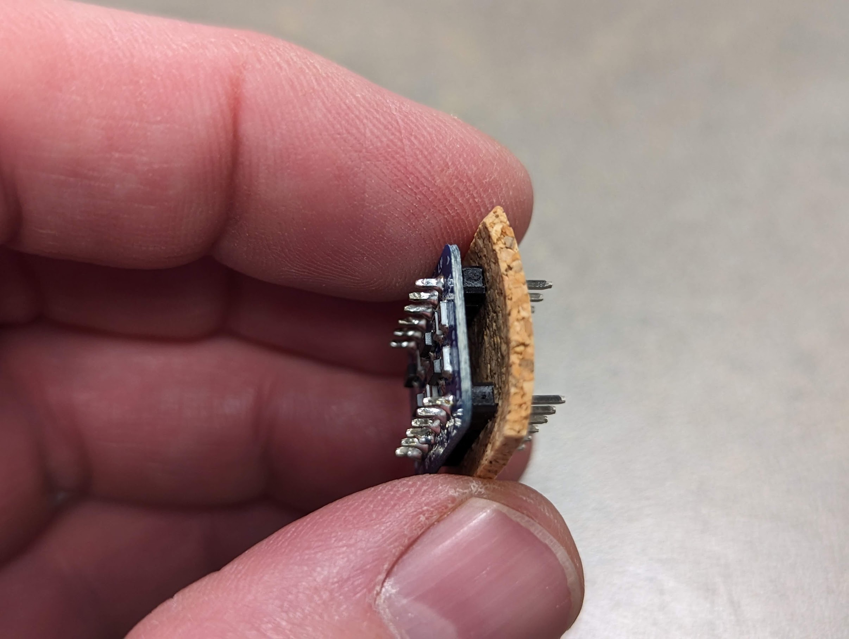
docs/source/construction/pico/mk3c-images/cork-attached.jpeg
