DocBohn/CowPi_documentation/docs/source/construction/pico/mk3c-images/defective-mk3c.png

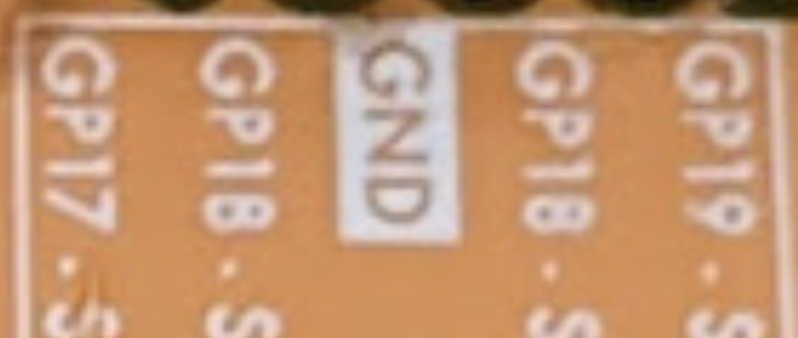
docs/source/construction/pico/mk3c-images/defective-mk3c.png
