DocBohn/CowPi_documentation/docs/source/construction/pico/mk3c-images/display-module.jpeg

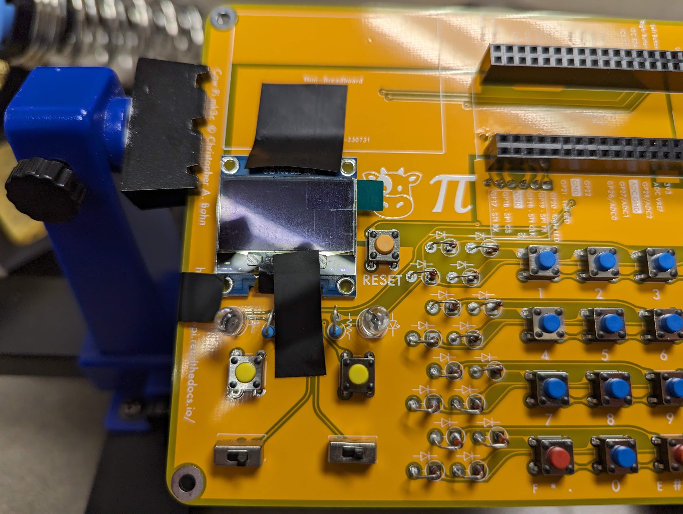
docs/source/construction/pico/mk3c-images/display-module.jpeg
