DocBohn/CowPi_documentation/docs/source/construction/pico/mk3c-images/feet-attached.jpeg

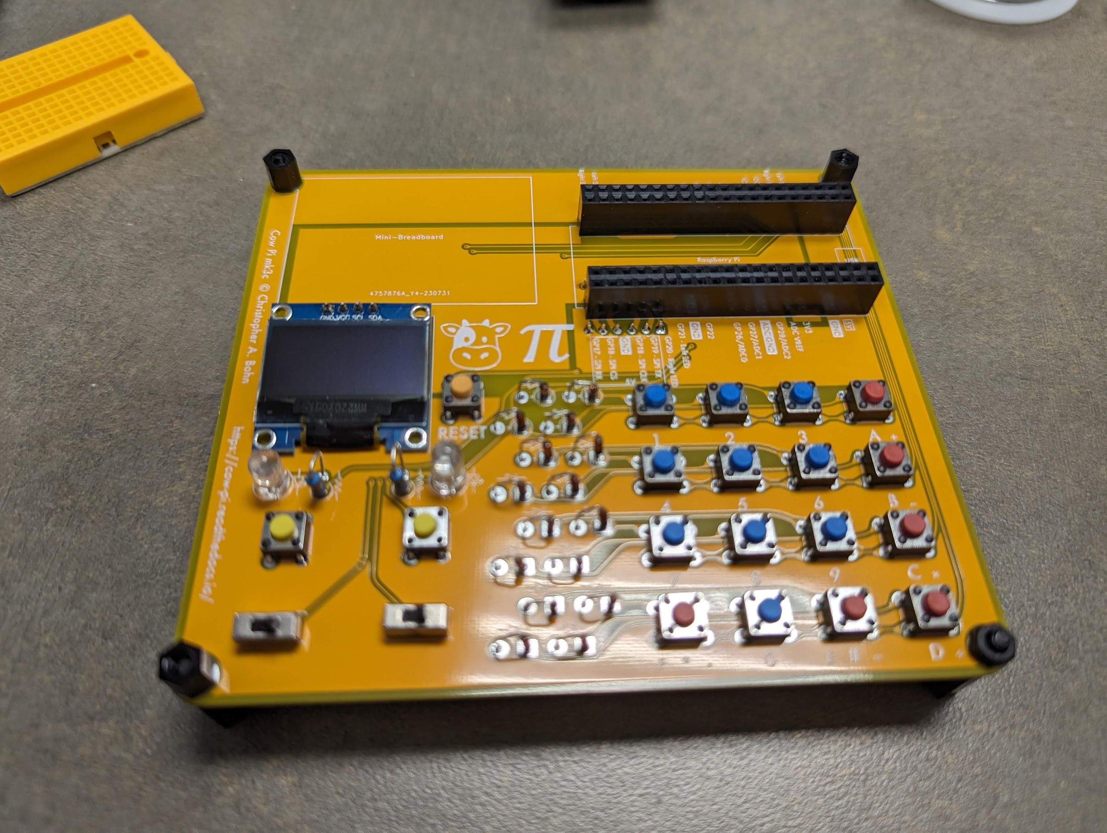
docs/source/construction/pico/mk3c-images/feet-attached.jpeg
