DocBohn/CowPi_documentation/docs/source/construction/pico/mk3c-images/inserting-diodes.jpeg

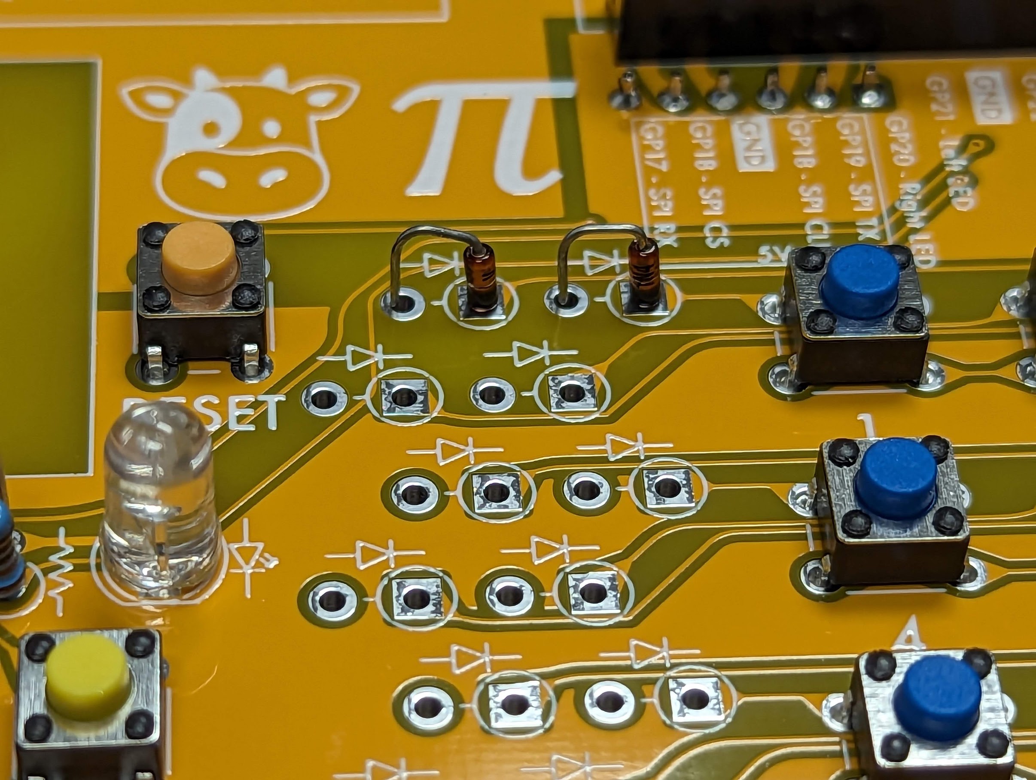
docs/source/construction/pico/mk3c-images/inserting-diodes.jpeg
