DocBohn/CowPi_documentation/docs/source/construction/pico/mk3c-images/LED.jpeg

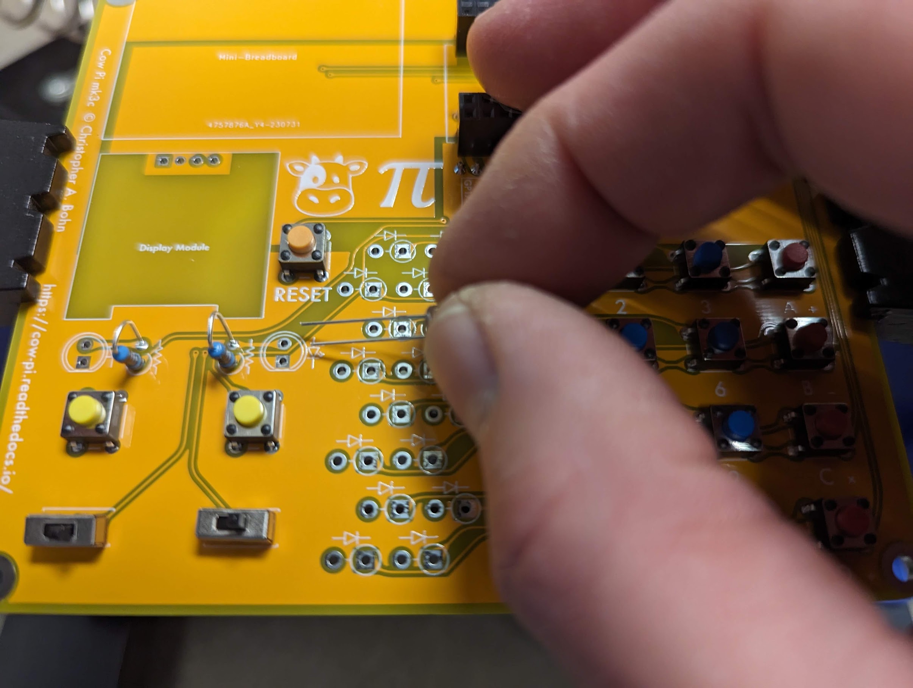
docs/source/construction/pico/mk3c-images/LED.jpeg
