DocBohn/CowPi_documentation/docs/source/construction/pico/mk3c-images/level-booster-with-cork.jpeg

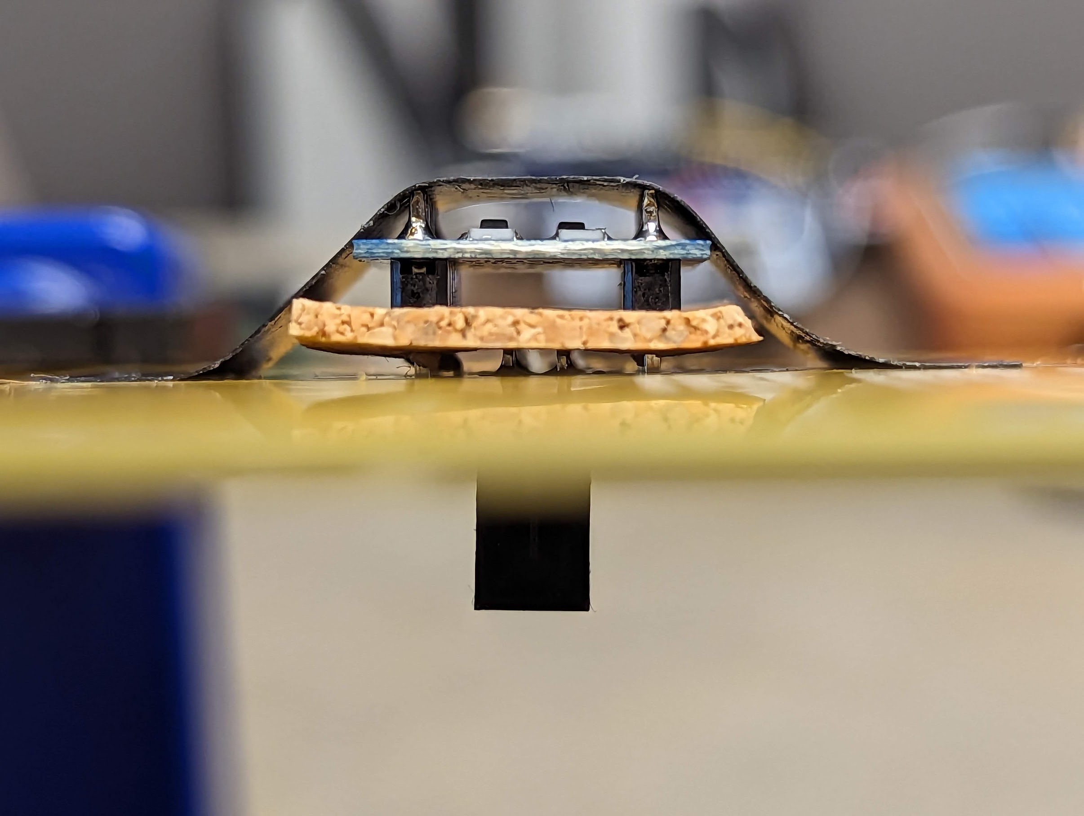
docs/source/construction/pico/mk3c-images/level-booster-with-cork.jpeg
