DocBohn/CowPi_documentation/docs/source/construction/pico/mk3c-images/lower-socket-ready.jpeg

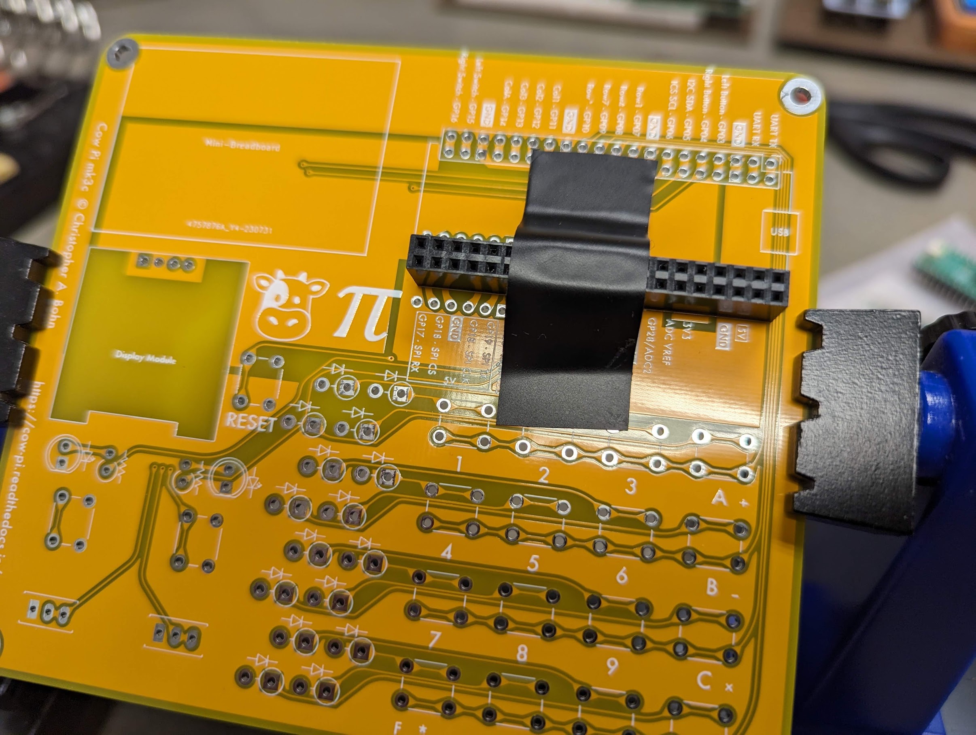
docs/source/construction/pico/mk3c-images/lower-socket-ready.jpeg
