DocBohn/CowPi_documentation/docs/source/construction/pico/mk3c-images/pico-inserted.jpeg

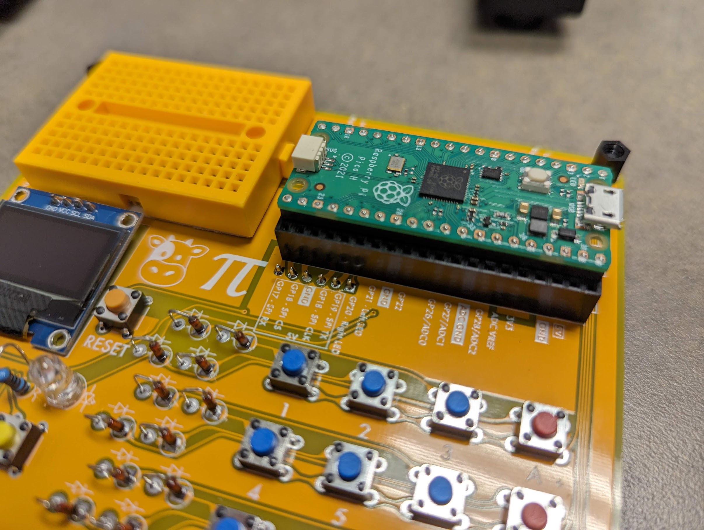
docs/source/construction/pico/mk3c-images/pico-inserted.jpeg
