DocBohn/CowPi_documentation/docs/source/construction/pico/mk3c-images/prepping-diodes.jpg

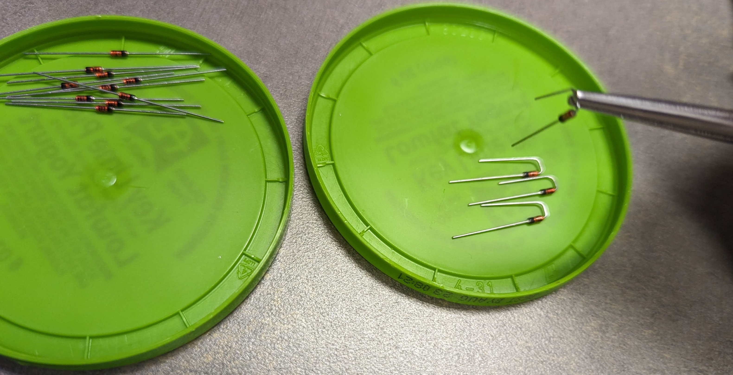
docs/source/construction/pico/mk3c-images/prepping-diodes.jpg
