DocBohn/CowPi_documentation/docs/source/construction/pico/mk3c-images/resistors.jpeg

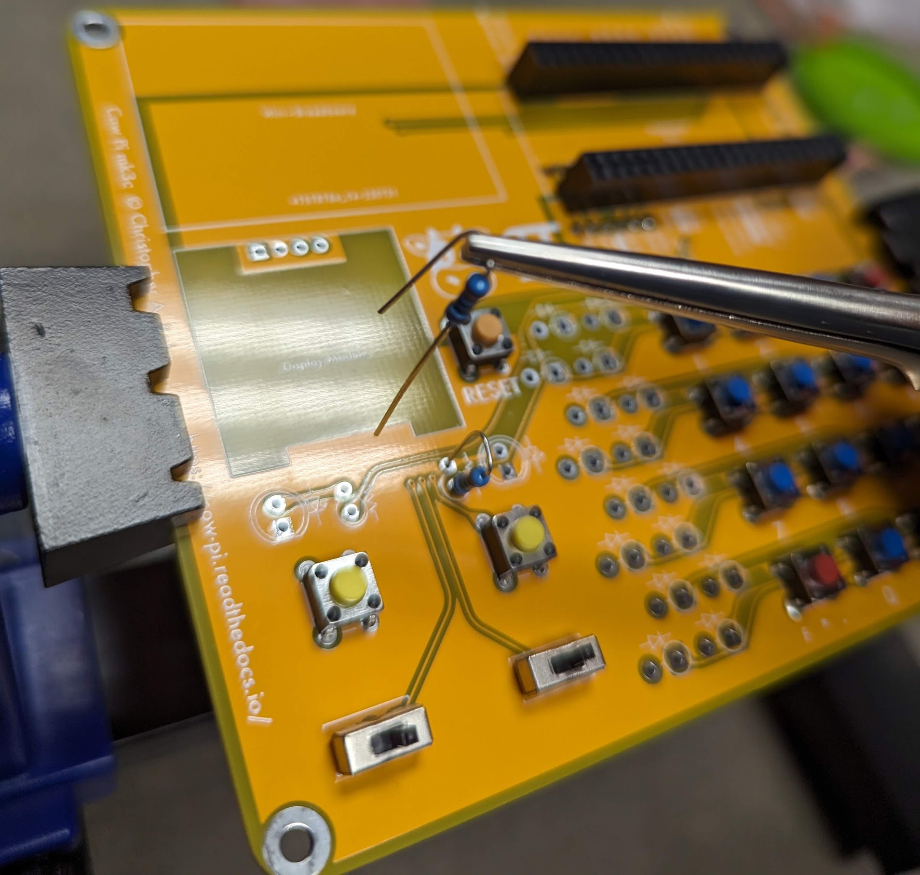
docs/source/construction/pico/mk3c-images/resistors.jpeg
