DocBohn/CowPi_documentation/docs/source/construction/pico/mk3c-images/slide-switches.jpeg

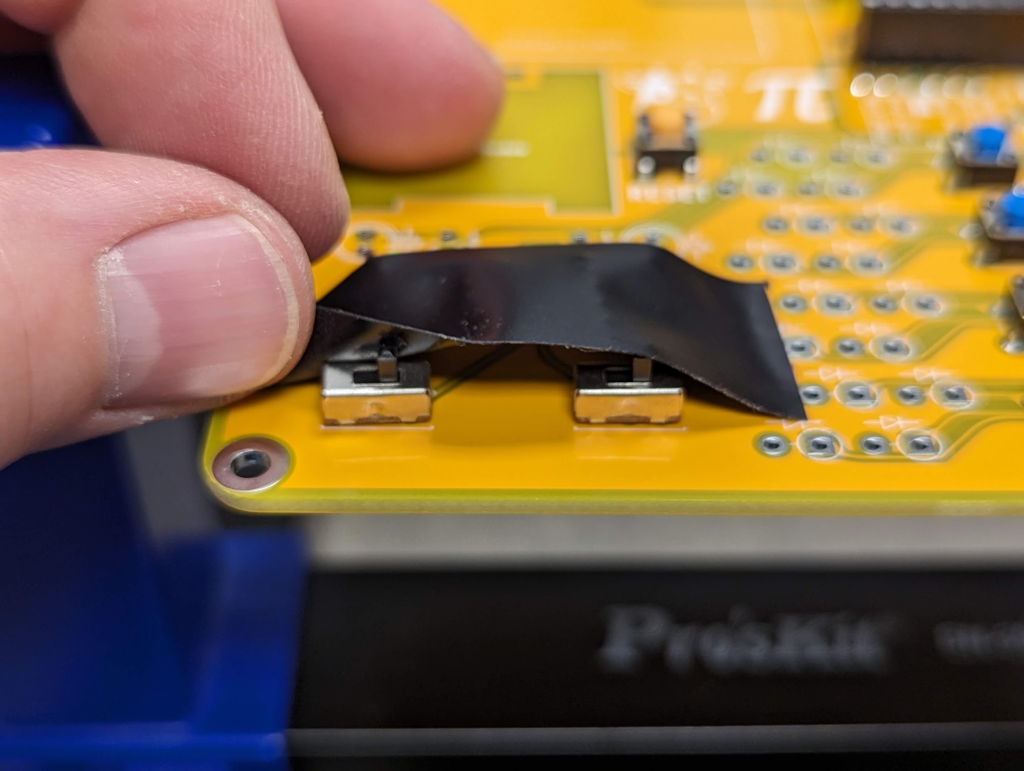
docs/source/construction/pico/mk3c-images/slide-switches.jpeg
