DocBohn/CowPi_documentation/docs/source/construction/pico/mk3c-images/soldering-diodes.jpeg

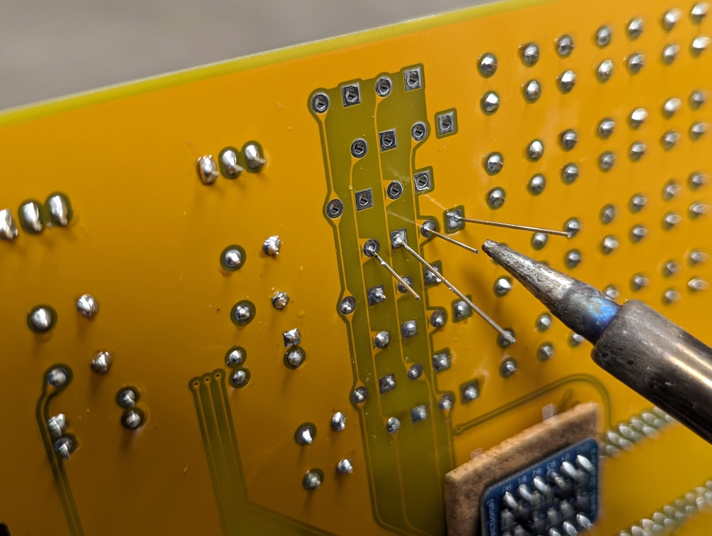
docs/source/construction/pico/mk3c-images/soldering-diodes.jpeg
