DocBohn/CowPi_documentation/docs/source/construction/pico/mk3c-images/tacking-upper-socket.jpeg

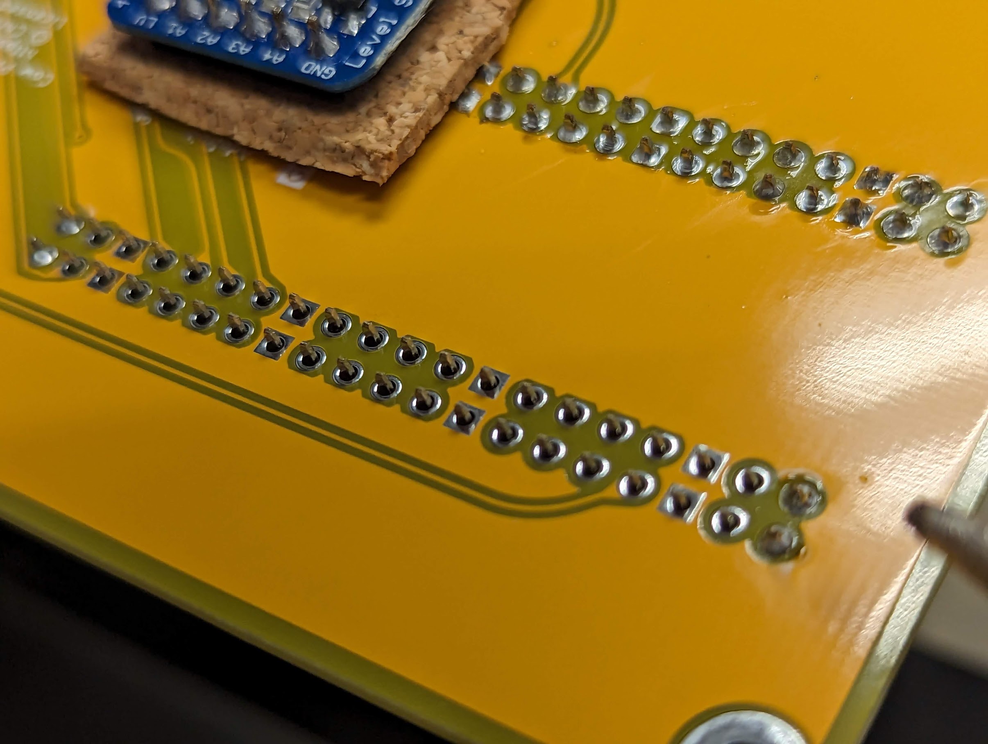
docs/source/construction/pico/mk3c-images/tacking-upper-socket.jpeg
