DocBohn/CowPi_documentation/docs/source/construction/pico/mk3c-images/tactile-switches.jpeg

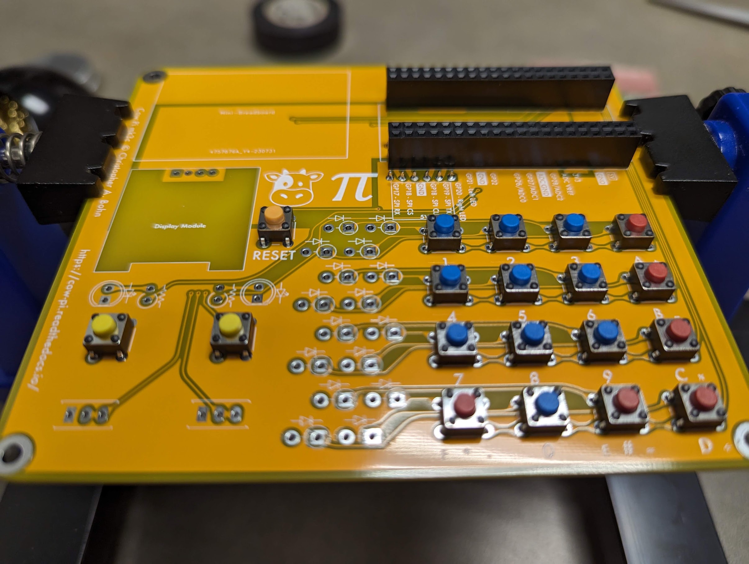
docs/source/construction/pico/mk3c-images/tactile-switches.jpeg
