DocBohn/CowPi_documentation/docs/source/construction/pico/mk3c-images/upper-socket-finished.jpeg

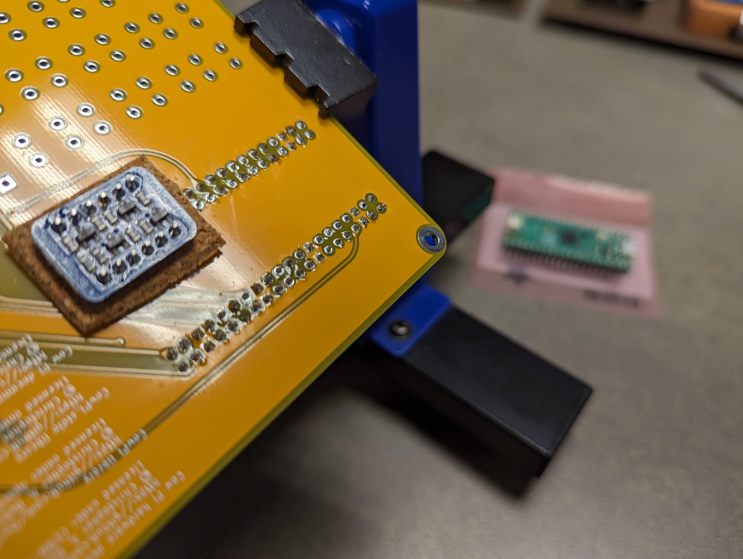
docs/source/construction/pico/mk3c-images/upper-socket-finished.jpeg
