DocBohn/CowPi_documentation/docs/source/construction/pico/mk3c-images/voltage-booster-without-cork.jpg

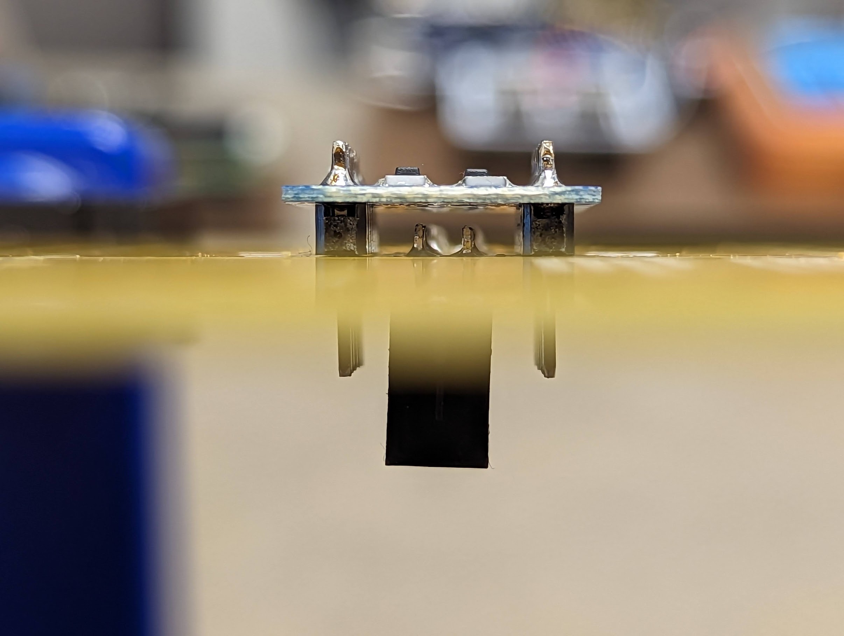
docs/source/construction/pico/mk3c-images/voltage-booster-without-cork.jpg
