DocBohn/CowPi_documentation/docs/source/construction/pico/mk4b-images/breadboard.jpeg

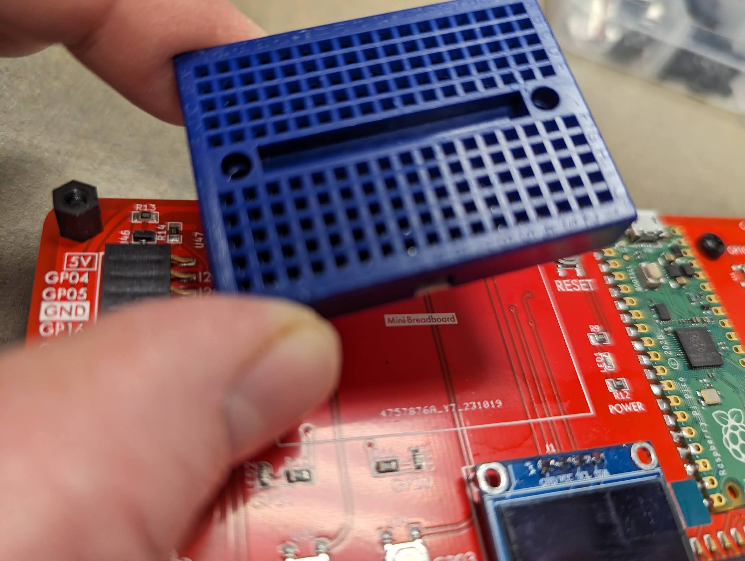
docs/source/construction/pico/mk4b-images/breadboard.jpeg
