DocBohn/CowPi_documentation/docs/source/construction/pico/mk4b-images/certification-mark-US002586-stacked.png

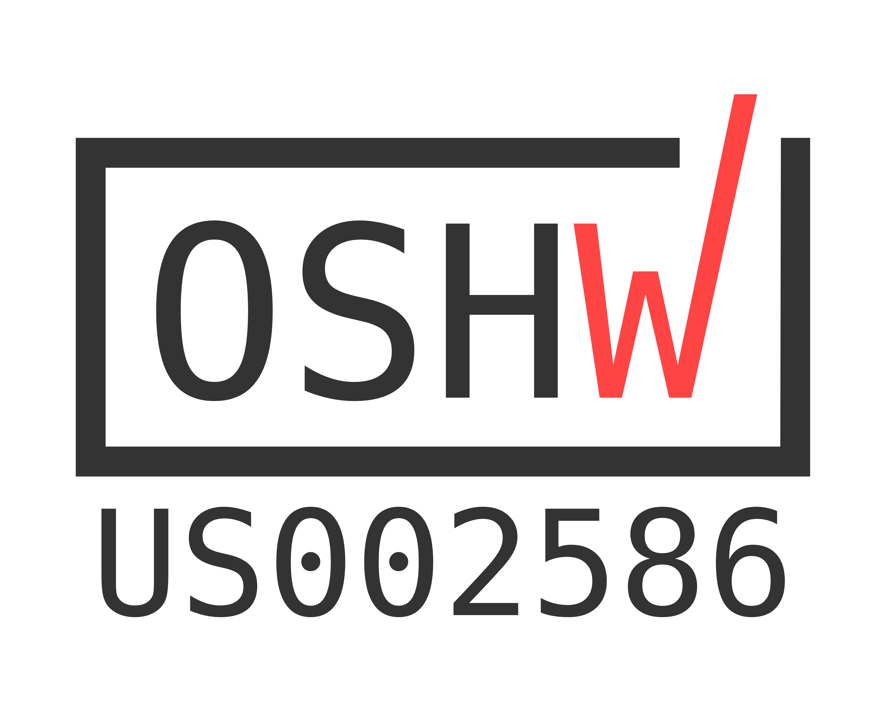
docs/source/construction/pico/mk4b-images/certification-mark-US002586-stacked.png
