DocBohn/CowPi_documentation/docs/source/construction/pico/mk4b-images/complete.jpeg

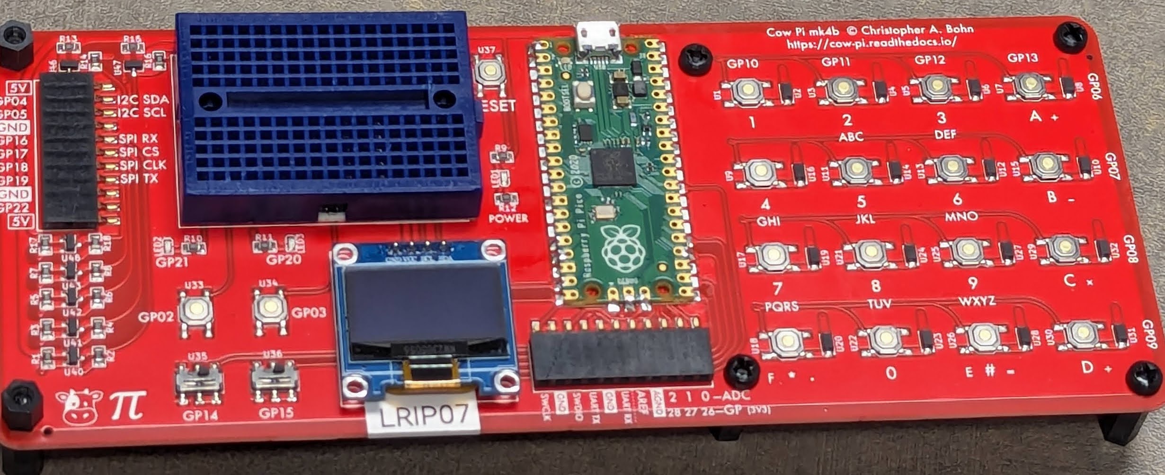
docs/source/construction/pico/mk4b-images/complete.jpeg
