DocBohn/CowPi_documentation/docs/source/construction/pico/mk4b-images/diagonal-cutters.jpg

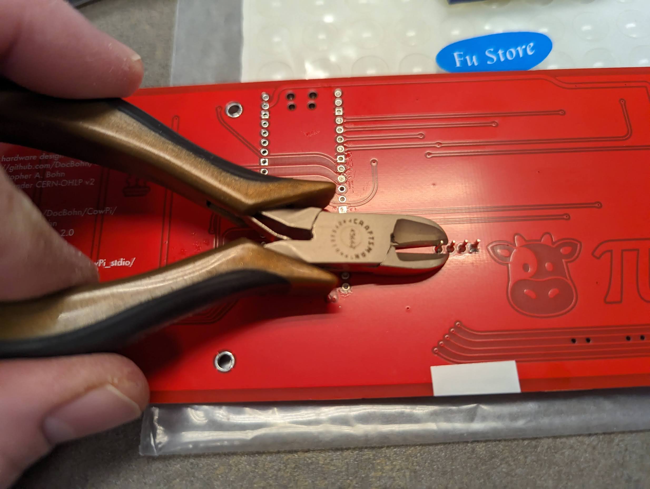
docs/source/construction/pico/mk4b-images/diagonal-cutters.jpg
