DocBohn/CowPi_documentation/docs/source/construction/pico/mk4b-images/end-cutters.jpeg

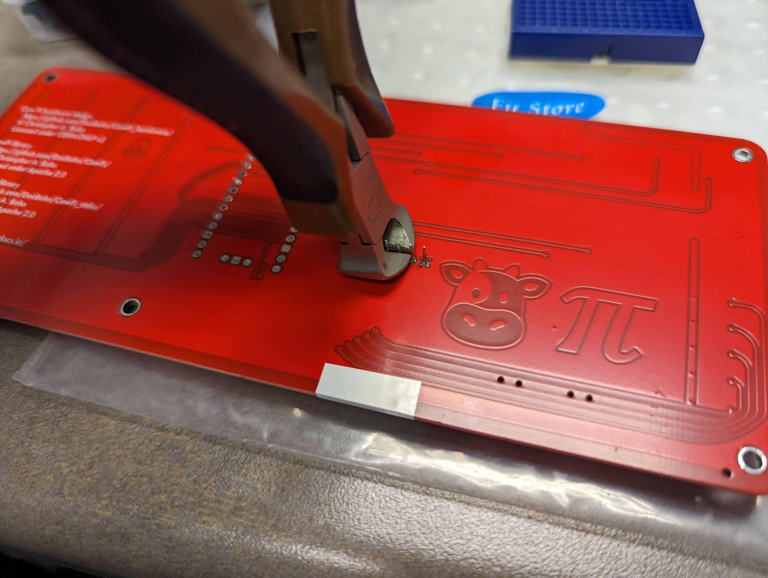
docs/source/construction/pico/mk4b-images/end-cutters.jpeg
