DocBohn/CowPi_documentation/docs/source/construction/pico/mk4b-images/feet-and-bumpers.jpeg

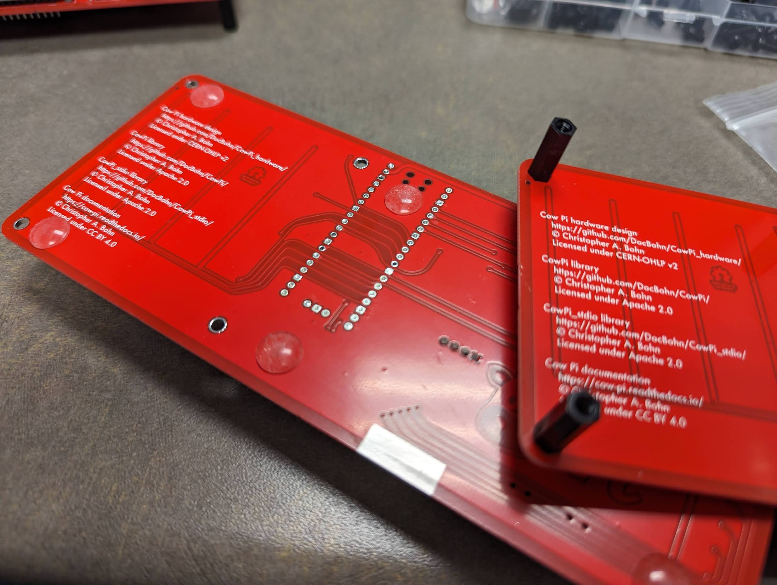
docs/source/construction/pico/mk4b-images/feet-and-bumpers.jpeg
