DocBohn/CowPi_documentation/docs/source/troubleshooting/device-manager-warning.png

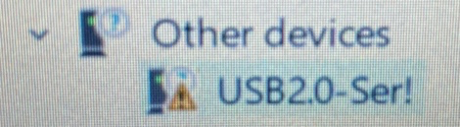
docs/source/troubleshooting/device-manager-warning.png
