DocBohn/CowPi_documentation/docs/source/troubleshooting/update-driver.jpg

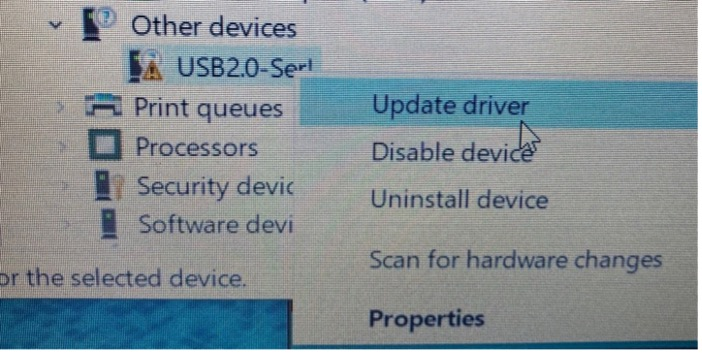
docs/source/troubleshooting/update-driver.jpg
