DocBohn/CowPi_documentation/(threads)

Thread 1 (2024-01-02):

"Arduino Nano upload error in 'Arduino IDE 2.1.1': 'avrdude: ser_open(): can't set com-state for "\\.\COM4".

willyliu93, 2024-01-02:
**I have tried the following methods in Arduino IDE 2.1.1, but I still cannot upload the code successfully every time:**

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

**This error message appears every time:**

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

**'Arduino Nano' code I uploaded:**

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

**other:**

> I can successfully transmit this code to 'arduino uno r3'

DocBohn, 2024-01-02:
An easy suggestion is to try upgrading to the latest Arduino IDE (the current version is 2.2.1). I don't recommend pinning your hopes on that solving the problem, though.

It seems that some Nano clones use the ATmega328PB microcontroller instead of the ATmega328P. The discussion toward the end of [this thread](https://forum.arduino.cc/t/connection-problem-cant-set-com-state/1135878) includes some links to deal with that problem.

Closed 2024-01-04.
