DocBohn/CowPi_documentation/(list of files, drawings)

Other design files:
docs/source/construction/fritzing_diagrams/CowPi-mk1b-nano-spi-max7219.fzz
docs/source/construction/fritzing_diagrams/CowPi-mk1c-nano-spi-max7219.fzz
docs/source/construction/fritzing_diagrams/CowPi-mk1d-nano-i2c-lcd1602.fzz
docs/source/construction/fritzing_diagrams/CowPi-mk1x-nano-i2c-lcd1602.fzz
docs/source/construction/nano/fritzing_diagrams/CowPi-mk1a-nano-spi-max7219.fzz
docs/source/construction/nano/fritzing_diagrams/CowPi-mk1b-nano-spi-max7219.fzz
docs/source/construction/nano/fritzing_diagrams/CowPi-mk1c-nano-spi-max7219.fzz
docs/source/construction/nano/fritzing_diagrams/CowPi-mk1d-nano-i2c-lcd1602.fzz
docs/source/construction/nano/fritzing_diagrams/CowPi-mk1e-nano-spi-max7219.fzz
docs/source/construction/nano/fritzing_diagrams/CowPi-mk1ef-nano-nowires.fzz
docs/source/construction/nano/fritzing_diagrams/CowPi-mk1f-nano-i2c-lcd1602.fzz
docs/source/construction/nano/fritzing_diagrams/CowPi-mk1f-nano-i2c-ssd1306.fzz
docs/source/construction/nano/fritzing_diagrams/CowPi-mk1i-pico-nowires.fzz
docs/source/construction/nano/fritzing_diagrams/CowPi-mk1x-nano-i2c-lcd1602.fzz
