DocBohn/CowPi_documentation/(commit log)

2023-07-11 Migrated mk1d construction instructions from labs to documentation repo
    Datasheet migration also started
    [CowPi-mk1b-nano-spi-max7219.fzz, CowPi-mk1c-nano-spi-max7219.fzz, CowPi-mk1d-nano-i2c-lcd1602.fzz, CowPi-mk1x-nano-i2c-lcd1602.fzz]
2023-07-16 Structure in place for distinct mk1e/mk1f instructions
    [CowPi-mk1b-nano-spi-max7219.fzz, CowPi-mk1c-nano-spi-max7219.fzz, CowPi-mk1d-nano-i2c-lcd1602.fzz, CowPi-mk1x-nano-i2c-lcd1602.fzz]
2023-07-16 Created fully-separate TOC links for mk1e and mk1f constructions
    While the earlier solution of removing the previous/next buttons
    *appeared* to work, using a single page (for example, led.rst) for
    both mk1e and mk1f would cause jumping from the mk1e instructions to
    the mk1f instructions (or, possibly, vice-versa).
2023-07-17 Updated Fritzing files and images for mk1e/f
    [CowPi-mk1a-nano-spi-max7219.fzz, CowPi-mk1e-nano-spi-max7219.fzz, CowPi-mk1ef-nano-nowires.fzz, CowPi-mk1f-nano-i2c-lcd1602.fzz, CowPi-mk1f-nano-i2c-ssd1306.fzz, CowPi-mk1i-pico-nowires.fzz, CowPi-mk1x-nano-i2c-lcd1602.fzz]
2023-07-17 And here are the updated files that expect the updated diagrams
    [CowPi-mk1f-nano-i2c-lcd1602.fzz]
2023-07-17 Updated construction photos
    [CowPi-mk1a-nano-spi-max7219.fzz, CowPi-mk1b-nano-spi-max7219.fzz, CowPi-mk1c-nano-spi-max7219.fzz, CowPi-mk1d-nano-i2c-lcd1602.fzz, CowPi-mk1e-nano-spi-max7219.fzz, CowPi-mk1ef-nano-nowires.fzz, CowPi-mk1f-nano-i2c-lcd1602.fzz, CowPi-mk1f-nano-i2c-ssd1306.fzz]
2023-08-07 Added SPI details for ATmega328P
2023-08-21 Added assembly instructions for Cow Pi mk3c
2023-09-07 Added links to mk3c KiCad & Gerber files
2024-01-04 Added images to mk4b assembly instructions
2024-03-24 Tweaks to improve clarity as we get ready for the Spring 2024 I/O labs
2024-04-11 corrected mk4b's buttons to be "inputs" not "outputs"
2024-11-03 Convenience functions for timer inputs
