DocBohn/CowPi_documentation/(notices)

Notices in the files:
docs/source/index.rst:
:alt: Open Source Hardware Licenses: CERN-OHL-P-2.0, Apache 2.0, CC-BY-4.0
